roboninecom/SO-ARM102/docs/i18n/en/README.md

<!-- translation-navigation -->
[English](README.md) · [Русский](../ru/README.md) · [Español](../es/README.md) · [Français](../fr/README.md) · [Deutsch](../de/README.md) · [Português (Brasil)](../pt-BR/README.md) · [简体中文](../zh-CN/README.md) · [日本語](../ja/README.md) · [हिन्दी](../hi/README.md) · [العربية](../ar/README.md)

[English source](../../../README.md)

[Documentation](README.md) · [Printing](docs/printing.md) · [BOM](docs/bom.md) · [Assembly](docs/assembly-guide.md) · [Specifications](docs/specifications.md) · [Models](models/README.md) · [Contributing](CONTRIBUTING.md) · [Licensing](LICENSING.md) · [Translations](docs/translations.md)

> English reference. Shared illustrations and the original PDF booklet are unchanged.
<!-- /translation-navigation -->

<!-- translated-content -->

# SO-ARM 102

<div align="center">

SO-ARM 102

**🎥 [Watch the preview video](../../../assets/video/so-arm-102-preview.mp4)** · **🛒 [Buy the kit](https://robonine.com/shop/so-arm102-robotic-arm-kit/)**

**SO-ARM 102 is an open-source leader–follower robot arm kit for teleoperation and imitation learning. Each arm has five degrees of freedom plus a gripper.**

<p align="left">
Building on SO-ARM 100 and 101, it combines a stiffer PET-CF frame with a parallel gripper.
</p>






📩 [hello@robonine.com](mailto:hello@robonine.com)

**DIY budget: ~$340 for components, or ~$374 including printing material.**
[BOM summary](#bill-of-materials) · [Itemised costs and purchase links](docs/bom.md#estimated-kit-cost)

> Rather not source the parts and print them yourself? **[Buy the SO-ARM 102 kit](https://robonine.com/shop/so-arm102-robotic-arm-kit/)**.

</div>

---

## ✨ What changed against SO-ARM 101

| | SO-ARM 101 | SO-ARM 102 |
|---|---|---|
| **Parallel gripper** | Angular jaw | **Two parallel jaws, 85 mm span** |
| **Stiffer frame: deflection at 300 g ¹** | 7.5 mm | **3.4–3.9 mm (−48–55%)** |
| **Faster shoulder and elbow, no load** | 45 RPM (STS3215) | **75 RPM (STS3250), +67%** |
| **Higher rated payload** | 150 g | **300 g (+100%)** |
| **Wider base rotation** | 220° | **352° (+60%)** |
| **Reach: horizontal / behind the base** | 441 / 377 mm | **483 / 473 mm (+9.5% / +25.5%)** |
| **Lower base joint backlash** | 8.75 counts | **5.00 counts (−43%)** |
| **Quieter at 1 m** | 70 dB | **60 dB (−10 dB)** |

¹ Frame test at full extension with printed servo dummies in joints 2, 3 and 4: SO-ARM 101 in PLA, SO-ARM 102 in Fiberon PET-CF17 at 25% infill. Servo speeds are manufacturer no-load ratings at 12 V; payloads are rated values. Full results and test conditions: [docs/specifications.md](docs/specifications.md).

---

## 🎥 Preview

<div align="center">

SO-ARM 102 preview

*Click for the full video, 21 s*

</div>

---

## 🤝 Configurations

### Single-arm: one leader + one follower

The standard kit. Move the leader by hand, and the follower repeats the motion.
Use it for teleoperation and for recording demonstrations for imitation learning.

One leader and one follower

### Bimanual: two leaders + two followers

Two kits side by side. Each hand drives its own leader, so the followers can pass objects,
hold and work on a part, or do any task that needs two hands.

Two leaders and two followers

### The two arms

| Follower | Leader |
|:-:|:-:|
| Follower arm | Leader arm |
| Parallel gripper, wrist camera, 12 V | Handle with trigger, 5 V |

---

## 🚀 Build it in four steps

Prefer a ready kit? **[Buy the SO-ARM 102 kit](https://robonine.com/shop/so-arm102-robotic-arm-kit/)**.

### 1. Print the parts

Individual parts fit a 180 × 180 mm bed. The largest part is 160 mm long.
The supplied 3MF plate layouts use a 256 × 256 mm bed.

- 3MF slicer projects with saved orientation and support settings: [`models/3mf/`](../../../models/3mf)
  — [leader](../../../models/3mf/SO102_leader.3mf), [follower arms](../../../models/3mf/SO102_follower_arms.3mf),
  [Follower gripper and base](../../../models/3mf/SO102_follower_gripper_base.3mf)
- Project contents and printer profiles: [models/README.md](models/README.md)
- STL files, ready to slice: [`models/stl/`](../../../models/stl)
- STEP sources: [`models/step/`](../../../models/step)
- Material, settings and part quantities: [docs/printing.md](docs/printing.md)

### 2. Buy the hardware

Source the components from the [BOM summary](#bill-of-materials) and
[full BOM with purchase links](docs/bom.md). Budget **$340.22** for components,
or **$373.97** including printing material, before shipping and taxes.

| Arm | Servos | Controller | Power |
|---|---|---|---|
| Follower | 2 × STS3235, 2 × STS3250, 2 × STS3215 | Waveshare Bus Servo Adapter | **12 V** |
| Leader | 6 × STS3215 | Waveshare Bus Servo Adapter | **5 V** |

> ⚠️ **The leader runs on 5 V and the follower on 12 V.** Do not swap the power supplies.

### 3. Assemble

- Printable booklet, 32 pages A5: [docs/SO-ARM102_assembly_A5_v0.8.pdf](../../SO-ARM102_assembly_A5_v0.8.pdf)
- Step list with parts and fasteners: [docs/assembly-guide.md](docs/assembly-guide.md)

Tools: hex keys 1.5 mm (M2 screws) and 2 mm (M3 screws).

### 4. Set up the software

Servo IDs, calibration and lessons: **[lab.robonine.com](https://lab.robonine.com)**.
Use the SO-ARM 102 follower plugin with the standard `so101_leader` type.
**[LeRobot installation and setup](docs/lerobot.md)**.

---

## Bill of materials

Quantities and reference costs for **one leader + one follower**:

| Category / purchase links | Kit contents | Total (USD) |
|---|---|---:|
| [Servos](docs/bom.md#servos) | 6 × STS3215 7.4 V, 2 × STS3215 12 V, 2 × STS3235, 2 × STS3250 | $240.72 |
| [Electronics](docs/bom.md#electronics) | 2 controllers, 2 power supplies, 2 USB cables, 1 wrist camera | $50.50 |
| [Mechanical parts](docs/bom.md#mechanical-parts) | 4 bearings, 2 steel guide rods, 4 table clamps | $37.76 |
| [Fasteners](docs/bom.md#fasteners) | Screws and nuts; specified servo-kit screws included | $11.24 |
| **Components subtotal** | | **$340.22** |
| [Printing material](docs/bom.md#printing-materials) | 0.4 kg PET-CF17 + 0.75 kg PETG allowance | $33.75 |
| **Total with printing material** | | **$373.97** |

Buying the example full packs and filament spools from scratch costs about **$435**,
including unused spares. These are reference estimates, not new supplier quotes.
Shipping, taxes, tools, a computer, a printer, electricity and assembly labour are excluded.
Confirm supplier prices, variants and minimum order quantities before ordering;
re-slice the 3MF projects to check filament consumption.

[Full BOM, purchase links and cost assumptions](docs/bom.md#estimated-kit-cost).

---

## URDF export

The current standalone export is in [`simulation/urdf/`](../../../simulation/urdf):
[URDF](../../../simulation/urdf/so_arm_102.urdf) · [Xacro](../../../simulation/urdf/so_arm_102.xacro).
Keep `meshes/` beside the description files; mesh paths are relative to this folder.

- **Visuals:** STL meshes. **Collisions:** fitted, independently rotated boxes on all eight links.
- **Mass estimate:** PLA, 30% infill, 6 perimeters, 6 top/bottom layers,
  0.2 mm layer height, and **0.40 mm extrusion width**. These are simulation
  assumptions; use [the printing guide](docs/printing.md) for fabrication settings.
- **Hardware masses:** six motors at 70 g each; base bearing at 105 g.
  Total estimated model mass: **0.889 kg**.
- **Gripper:** `clamp2` mimics `clamp1` with multiplier `-1`.

[Export settings](../../../simulation/urdf/export_settings.json) and
[mass properties](../../../simulation/urdf/mass_properties.json) record the assumptions.
Geometry and inertia checks are recorded in [export_verification.json](../../../simulation/urdf/export_verification.json).

---

## 📁 Repository structure

```
├── models/
│   ├── 3mf/                 # Slicer projects: leader, follower, gripper and board case
│   ├── stl/                 # Print-ready meshes
│   │   ├── common/          # Shared parts, including controller cases
│   │   ├── follower/        # Parallel gripper and camera mount
│   │   └── leader/          # Handle, trigger and wrist roll
│   └── step/                # CAD sources, same layout as stl/
├── docs/
│   ├── printing.md          # Material, slicer settings, quantities
│   ├── bom.md               # Bill of materials
│   ├── assembly-guide.md    # Step list with parts and fasteners
│   ├── specifications.md    # Geometry, servos, measured results vs SO-ARM 101
│   └── SO-ARM102_assembly_A5_v0.8.pdf
├── assets/
│   ├── images/              # Photos, renders, booklet pages, test photos
│   └── video/               # Preview video and GIF
├── LICENSING.md             # Which licence covers which file
└── NOTICE                   # Third-party attribution
```

---

## ⚠️ Known issues

Build notes from independent testing; check these when assembling.

1. **Use booklet v0.8.** Earlier booklets show the HAT controller and older gripper parts. v0.8 fits a Bus Servo Adapter on both arms.
2. **M2 screws are hard to reach in several places.** Expect to fight a few of them.
3. **The gripper clamps run tight on carbon rods.** The clamp bores are sized for 6.1 mm. Rod diameters vary between suppliers, so check the fit before assembly.
4. **Check the servo cable lengths** before closing each joint, especially from the base to the shoulder.
5. **The assembly order is awkward in two places** of the booklet. Read two steps ahead before fastening.
6. **Leader joints can feel loose.** Adding 8 × 2 mm rubber O-rings between each servo and its horn gives the leader smooth, silent friction. Use two per servo on joints 1–4 and one on joints 5–6.

Found something else? Please [open an issue](https://github.com/roboninecom/SO-ARM-102/issues).

---

## ⭐ Star History

Star History — SO-ARM 102 (https://www.star-history.com/?repos=roboninecom%2FSO-ARM102&type=date&legend=top-left)

---

## 🔗 Related projects

- [SO-ARM100/101 Parallel Gripper](https://github.com/roboninecom/SO-ARM100-101-Parallel-Gripper), the gripper the SO-ARM 102 gripper grew from
- [SO-ARM101](https://github.com/TheRobotStudio/SO-ARM100) by TheRobotStudio, the arm this design succeeds
- [Practical comparison of smart serial servos](https://robonine.com/smart-serial-servo-motor-comparison-robotics/), the tests behind the servo choice
- [Choosing a filament for robotic arms](https://robonine.com/choosing-filament-for-robotic-arm-applications/), the tests behind PET-CF

---

## 📄 License

Copyright (c) 2026 Robonine. Different kinds of material carry different licences:

| Material | Licence |
|---|---|
| Hardware designs in `models/` | [CERN-OHL-P-2.0](../../../HARDWARE-LICENSE.txt) |
| Software and configuration | [Apache-2.0](../../../SOFTWARE-LICENSE.txt) |
| Documentation and images in `docs/`, `assets/`, all `README.md` | [CC BY 4.0](../../../DOCS-LICENSE.txt) |

See [LICENSING.md](LICENSING.md) and [REUSE.toml](../../../REUSE.toml) for the file-by-file map.

---

## 👥 Team

| Name | Role | Contact |
|---|---|---|
| **Alan Subin** | Design Engineer: mechanical design, CAD, assembly booklet | [LinkedIn](https://www.linkedin.com/in/alan-subin/) |
| **Boris Kotov** | Software and Test Engineer: prototypes, printing, test rigs | [Telegram](https://t.me/bkotov) |
| **Nikita Bragin** | Project Manager | [LinkedIn](https://www.linkedin.com/in/nikita-bragin-82296b29/) |
| **Mikhail Chistiakov** | Industrial Designer: look and form of the arm | [Telegram](https://t.me/brrryska) |
| **Mikhail Zhmaylo** | Structural Engineer: stiffness models, design changes to cut deflection | [Telegram](https://t.me/mikhail_zhmaylo) |
| **Vladislav Eremenko** | Structural Engineer: strength and thermal analysis, topology optimisation | [Telegram](https://t.me/v1ad_eremenko) |
| **Vladimir Osipov** | Tester and Consultant: independent test build | [LinkedIn](https://www.linkedin.com/in/vladimirosipov/) |

<div align="center">

**Built for the robotics community by [Robonine](https://robonine.com)** 🤖

</div>
<!-- /translated-content -->
