roboninecom/SO-ARM102/docs/i18n/es/README.md

<!-- translation-navigation -->
[English](../en/README.md) · [Русский](../ru/README.md) · [Español](README.md) · [Français](../fr/README.md) · [Deutsch](../de/README.md) · [Português (Brasil)](../pt-BR/README.md) · [简体中文](../zh-CN/README.md) · [日本語](../ja/README.md) · [हिन्दी](../hi/README.md) · [العربية](../ar/README.md)

[Original en inglés](../../../README.md)

[Documentación](README.md) · [Impresión](docs/printing.md) · [Materiales](docs/bom.md) · [Montaje](docs/assembly-guide.md) · [Especificaciones](docs/specifications.md) · [Modelos](models/README.md) · [Contribuir](CONTRIBUTING.md) · [Licencias](LICENSING.md) · [Traducciones](docs/translations.md)

> Traducción completa del documento. Las ilustraciones y el manual PDF original se comparten entre idiomas. Traducción realizada con ayuda de IA; aún no revisada por hablantes nativos.
<!-- /translation-navigation -->

<!-- translated-content -->

# SO-ARM 102

<div align="center">

SO-ARM 102

**🎥 [Ver el video de vista previa](../../../assets/video/so-arm-102-preview.mp4)**·**🛒 [Comprar el kit](https://robonine.com/shop/so-arm102-robotic-arm-kit/)**

**SO-ARM 102 es un kit de brazos robóticos líder–seguidor de código abierto para teleoperación y aprendizaje por imitación. Cada brazo tiene cinco grados de libertad y una pinza.**

<p align="left">
Basado en SO-ARM 100 y 101, combina una estructura de PET-CF más rígida con una pinza paralela.
</p>

   

📩 [hello@robonine.com](mailto:hello@robonine.com)

**Presupuesto de bricolaje: ~$340 para componentes, o ~$374 incluyendo material de impresión.** [Resumen del BOM](#bill-of-materials) · [Costos detallados y enlaces de compra](docs/bom.md#estimated-kit-cost)

> ¿Prefieres no obtener las piezas e imprimirlas tú mismo? **[Compra el kit SO-ARM 102](https://robonine.com/shop/so-arm102-robotic-arm-kit/)**.

</div>

---

## ✨ Lo que cambió contra SO-ARM 101

| | SO-ARM 101 | SO-ARM 102 |
|---|---|---|
| **Pinza paralela** | Mordaza angular | **Dos mordazas paralelas, apertura de 85 mm** |
| **Bastidor más rígido: deflexión con 300 g ¹** | 7.5 mm | **3.4–3.9 mm (−48–55%)** |
| **Hombro y codo más rápidos, sin carga** | 45 RPM (STS3215) | **75 RPM (STS3250), +67%** |
| **Mayor carga útil nominal** | 150 g | **300 g (+100%)** |
| **Mayor giro de la base** | 220° | **352° (+60%)** |
| **Alcance: horizontal / detrás de la base** | 441 / 377 mm | **483 / 473 mm (+9.5% / +25.5%)** |
| **Menor holgura en la articulación de la base** | 8.75 cuentas | **5.00 cuentas (−43%)** |
| **Menos ruido a 1 m** | 70 dB | **60 dB (−10 dB)** |

¹ Ensayo del bastidor completamente extendido con réplicas impresas de servos en las articulaciones 2, 3 y 4: SO-ARM 101 en PLA, SO-ARM 102 en Fiberon PET-CF17 con 25% de relleno. Las velocidades son valores del fabricante sin carga a 12 V; las cargas útiles son nominales. Resultados y condiciones: [docs/specifications.md](docs/specifications.md).

---

## 🎥 Vista previa

<div align="center">

SO-ARM 102 preview

*Haz clic para ver el vídeo completo, 21 s*

</div>

---

## 🤝 Configuraciones

### Brazo de un solo robot: un brazo robot líder + un brazo robot seguidor

El kit estándar. Mueva el brazo robot líder a mano, y el brazo robot seguidor repite el movimiento.Úselo para teleoperación y para grabar demostraciones para aprendizaje por imitación.

Un brazo líder y un brazo seguidor

### Bimanual: dos líderes + dos seguidores

Cada mano controla su propio brazo robot líder, por lo que los seguidores pueden pasar objetos, sujetar y trabajar en una pieza o hacer cualquier tarea que requiera dos manos.

Dos brazos líderes y dos brazos seguidores

### Los dos brazos robóticos

| Brazo seguidor | Brazo líder |
|:-:|:-:|
| Brazo seguidor | Brazo líder |
| Pinza paralela, cámara de muñeca, 12 V | Mango con gatillo, 5 V |

---

## 🚀 Construye en cuatro pasos

¿Prefieres un kit listo? **[Compra el SO-ARM 102 kit](https://robonine.com/shop/so-arm102-robotic-arm-kit/)**.

### 1. Imprimir las piezas

Las piezas individuales se ajustan a una placa de construcción de impresora 3D 180 × 180 mm. La parte más grande tiene 160 mm largo. Los diseños de placa 3MF suministrados utilizan una placa de construcción de impresora 3D 256 × 256 mm.

- 3MF proyectos slicer con configuraciones de orientación y soporte guardadas: [`models/3mf/`](../../../models/3mf) — [brazo robot líder](../../../models/3mf/SO102_leader.3mf), [brazo robot seguidor](../../../models/3mf/SO102_follower_arms.3mf), [Pinza y base del seguidor](../../../models/3mf/SO102_follower_gripper_base.3mf)
- Contenido del proyecto y perfiles de impresora: [models/README.md](models/README.md)
- STL archivos, listos para cortar: [`models/stl/`](../../../models/stl)
- STEP sources: [`models/step/`](../../../models/step)
- Material, ajustes y cantidades de piezas: [docs/printing.md](docs/printing.md)

### 2. Comprar el hardware

Obtenga los componentes del [resumen de la lista de materiales](#bill-of-materials) y [lista completa con enlaces de compra](docs/bom.md). Presupuesto **$340.22**para componentes, o**$373.97** incluyendo material de impresión, antes del envío e impuestos.

| Brazo | Servos | Controlador | Alimentación |
|---|---|---|---|
| Brazo seguidor | 2 × STS3235, 2 × STS3250, 2 × STS3215 | Waveshare Bus Servo Adapter | **12 V** |
| Brazo líder | 6 × STS3215 | Waveshare Bus Servo Adapter | **5 V** |

> ⚠️ **El brazo líder funciona a 5 V y el brazo seguidor a 12 V.** No intercambie las fuentes de alimentación.

### 3. Ensamblar

- Folleto imprimible, 32 páginas A5: [docs/SO-ARM102_assembly_A5_v0.8.pdf](../../SO-ARM102_assembly_A5_v0.8.pdf)
- Lista de pasos con piezas y sujetadores: [docs/assembly-guide.md](docs/assembly-guide.md)

Herramientas: llaves hexagonales 1.5 mm (M2 tornillos) y 2 mm (M3 tornillos).

### 4. Configurar el software

Servo IDs, calibración y lecciones: **[lab.robonine.com](https://lab.robonine.com)**.
Utilice el plugin del seguidor SO-ARM 102 con el tipo estándar `so101_leader`.
**[Instalación y configuración de LeRobot](docs/lerobot.md)**.

---

## Lista de materiales

Cantidades y costos de referencia para **un brazo robot líder + un brazo robot seguidor**:

| Categoría / enlaces de compra | Contenido del kit | Total (USD) |
|---|---|---:|
| [Servos](docs/bom.md#servos) | 6 × STS3215 7.4 V, 2 × STS3215 12 V, 2 × STS3235, 2 × STS3250 | $240.72 |
| [Electrónica](docs/bom.md#electronics) | 2 controladores, 2 fuentes de alimentación, 2 cables USB, 1 cámara de muñeca | $50.50 |
| [Piezas mecánicas](docs/bom.md#mechanical-parts) | 4 rodamientos, 2 barras guía de acero, 4 abrazaderas de mesa | $37.76 |
| [Elementos de fijación](docs/bom.md#fasteners) | Tornillos y tuercas; tornillos especificados del juego del servomotor incluidos | $11.24 |
| **Subtotal de componentes** |  | **$340.22** |
| [Material de impresión](docs/bom.md#printing-materials) | 0.4 kg PET-CF17 + 0.75 kg PETG asignación | $33.75 |
| **Total con material de impresión** |  | **$373.97** |

Comprar el ejemplo de paquetes completos y carretes de filamentos desde cero cuesta alrededor de **$435**, incluyendo repuestos no utilizados. Estas son estimaciones de referencia, no nuevas cotizaciones de proveedores. El envío, los impuestos, las herramientas, una computadora, una impresora, la electricidad y el trabajo de montaje están excluidos. Confirme los precios del proveedor, las variantes y las cantidades mínimas de pedido antes de realizar el pedido; corte nuevamente con el cortador de impresión 3D los 3MF proyectos para verificar el consumo de filamento.

[BOM completo, enlaces de compra y supuestos de costo](docs/bom.md#estimated-kit-cost).

---

## URDF exportación

La exportación independiente actual está en [`simulation/urdf/`](../../../simulation/urdf): [URDF](../../../simulation/urdf/so_arm_102.urdf) · [Xacro](../../../simulation/urdf/so_arm_102.xacro). Mantenga `meshes/` junto a los archivos de descripción; las rutas de malla son relativas a esta carpeta.

- **Visuales:**STL mallas.**Colisiones:** cajas rotativas independientes en los ocho enlaces.
- **Estimación de masa:**PLA, 30% de relleno, 6 perímetros, 6 capas superior/inferior, 0.2 mm altura de capa y**0.40 mm ancho de extrusión** Estos son supuestos de simulación; utilice [la guía de impresión](docs/printing.md) para los ajustes de fabricación.
- **Masas de hardware:**seis motores a 70 g cada uno; cojinete base a 105 g. Masa total estimada del modelo:**0.889 kg**.
- **Gripper:** `clamp2` imita `clamp1` con multiplicador `-1`.

[Configuración de exportación](../../../simulation/urdf/export_settings.json) y [Propiedades de masa](../../../simulation/urdf/mass_properties.json) registran los supuestos.La geometría y las comprobaciones de inercia se registran en [export_verification.json](../../../simulation/urdf/export_verification.json).

---

## 📁 Estructura del repositorio

```
├── models/
│   ├── 3mf/                 # Proyectos de la rebanadora: brazo robot líder, brazo robot seguidor, pinza y caja del tablero
│   ├── stl/                 # Mallas listas para imprimir
│   │   ├── common/          # Piezas comunes, incluidas las cajas de los controladores
│   │   ├── follower/        # Pinza paralela y soporte de cámara
│   │   └── leader/          # Mango, gatillo y giro de muñeca
│   └── step/                # CAD fuentes, mismo diseño que stl/
├── docs/
│   ├── printing.md          # Material, ajustes de la rebanadora, cantidades
│   ├── bom.md               # Lista de materiales
│   ├── assembly-guide.md    # Lista de pasos con piezas y sujetadores
│   ├── specifications.md    # Geometría, servomotores, resultados medidos vs SO-ARM 101
│   └── SO-ARM102_assembly_A5_v0.8.pdf
├── assets/
│   ├── images/              # Fotos, renders, páginas de folletos, fotos de prueba
│   └── video/               # Vista previa de vídeo y GIF
├── LICENSING.md             # Qué licencia cubre qué archivo
└── NOTICE                   # Atribución a terceros
```

---

## Problemas conocidos

Notas de montaje de pruebas independientes; revíselas al montar.

1. **Use el folleto v0.8.** Los anteriores muestran el controlador HAT y piezas antiguas de la pinza. La v0.8 instala un Bus Servo Adapter en ambos brazos.
2. **M2 tornillos son difíciles de alcanzar en varios lugares.** Espere luchar contra algunos de ellos.
3. **Las abrazaderas de la pinza funcionan bien en varillas de carbono.** Los orificios de las abrazaderas tienen un tamaño para 6.1 mm.Los diámetros de las varillas varían entre los proveedores, así que compruebe el ajuste antes del montaje.
4. **Compruebe las longitudes de cable del servomotor** antes de cerrar cada junta, especialmente desde la base hasta el hombro.
5. **El orden de montaje es incómodo en dos lugares** del folleto.Lea dos pasos antes de fijar.
6. **Las juntas de los brazos del robot líder pueden sentirse sueltas.** Al agregar 8 × 2 mm juntas tóricas de goma entre cada servomotor y su bocina, el brazo del robot líder obtiene una fricción suave y silenciosa. Utilice dos por servomotor en las juntas 1–4 y una en las juntas 5–6.

Por favor, [abre un problema](https://github.com/roboninecom/SO-ARM-102/issues).

---

## ⭐ Historial de estrellas

Historial de estrellas — SO-ARM 102 (https://www.star-history.com/?repos=roboninecom%2FSO-ARM102&type=date&legend=top-left)

---

## Proyectos relacionados

- [SO-ARM100/101 Pinza paralela](https://github.com/roboninecom/SO-ARM100-101-Parallel-Gripper), la pinza de la que creció la SO-ARM 102 pinza
- [SO-ARM101](https://github.com/TheRobotStudio/SO-ARM100) por TheRobotStudio, el brazo robótico este diseño tiene éxito
- [Comparación práctica de servomotores inteligentes en serie](https://robonine.com/smart-serial-servo-motor-comparison-robotics/), las pruebas detrás de la elección del servomotor
- [Elegir un filamento para brazos robóticos](https://robonine.com/choosing-filament-for-robotic-arm-applications/), las pruebas detrás de PET-CF

---

## 📄 Licencia de uso

Copyright (c) 2026 Robonine. Diferentes tipos de material llevan diferentes licencias:

| Material | Licencia |
|---|---|
| Diseños de hardware en `models/` | [CERN-OHL-P-2.0](../../../HARDWARE-LICENSE.txt) |
| Software y configuración | [Apache-2.0](../../../SOFTWARE-LICENSE.txt) |
| Documentación e imágenes en `docs/`, `assets/`, todos `README.md` | [CC BY 4.0](../../../DOCS-LICENSE.txt) |

Vea [LICENSING.md](LICENSING.md) y [REUSE.toml](../../../REUSE.toml) para el mapa archivo por archivo.

---

## 👥 Team

| Nombre | Función | Contacto |
|---|---|---|
| **Alan Subin** | Ingeniero de diseño: diseño mecánico, CAD, folleto de montaje | [LinkedIn](https://www.linkedin.com/in/alan-subin/) |
| **Boris Kotov** | Ingeniero de software y pruebas: prototipos, impresión, bancos de prueba | [Telegram](https://t.me/bkotov) |
| **Nikita Bragin** | Gerente de proyecto | [LinkedIn](https://www.linkedin.com/in/nikita-bragin-82296b29/) |
| **Mikhail Chistiakov** | Diseñador industrial: aspecto y forma del brazo robot | [Telegram](https://t.me/brrryska) |
| **Mikhail Zhmaylo** | Ingeniero estructural: modelos de rigidez, cambios de diseño para reducir la desviación | [Telegram](https://t.me/mikhail_zhmaylo) |
| **Vladislav Eremenko** | Ingeniero estructural: análisis de resistencia y térmico, optimización topológica | [Telegram](https://t.me/v1ad_eremenko) |
| **Vladimir Osipov** | Tester y Consultor: construcción independiente de pruebas | [LinkedIn](https://www.linkedin.com/in/vladimirosipov/) |

<div align="center">

** Construido para la comunidad de robótica por [Robonine](https://robonine.com)** 🤖

</div>
<!-- /translated-content -->
