roboninecom/SO-ARM102/docs/i18n/ru/README.md

<!-- translation-navigation -->
[English](../en/README.md) · [Русский](README.md) · [Español](../es/README.md) · [Français](../fr/README.md) · [Deutsch](../de/README.md) · [Português (Brasil)](../pt-BR/README.md) · [简体中文](../zh-CN/README.md) · [日本語](../ja/README.md) · [हिन्दी](../hi/README.md) · [العربية](../ar/README.md)

[Английский оригинал](../../../README.md)

[Документация](README.md) · [Печать](docs/printing.md) · [Комплектующие](docs/bom.md) · [Сборка](docs/assembly-guide.md) · [Характеристики](docs/specifications.md) · [Модели](models/README.md) · [Участие](CONTRIBUTING.md) · [Лицензирование](LICENSING.md) · [Переводы](docs/translations.md)

> Полный перевод документа. Изображения и исходный PDF-буклет общие для всех языков. Перевод подготовлен с помощью ИИ; проверка носителями языка ещё не проведена.
<!-- /translation-navigation -->

<!-- translated-content -->

# SO-ARM 102

<div align="center">

SO-ARM 102

**🎥 [Посмотреть видео](../../../assets/video/so-arm-102-preview.mp4)**·**🛒 [Купить комплект](https://robonine.com/shop/so-arm102-robotic-arm-kit/)**

**SO-ARM 102 — открытый комплект ведущей и ведомой роботизированных рук для телеуправления и обучения по демонстрациям. Каждая рука имеет пять степеней свободы и захват.**

<p align="left">
Развивая конструкцию SO-ARM 100 и 101, он сочетает более жёсткую раму из PET-CF с параллельным захватом.
</p>

   

📩 [hello@robonine.com](mailto:hello@robonine.com)

**Бюджет самостоятельной сборки: ~$340 на комплектующие или ~$374 с материалом для печати.** [Сводная спецификация](#bill-of-materials) · [Подробные цены и ссылки закупки](docs/bom.md#estimated-kit-cost)

> Предпочитаете не закупать и не печатать детали самостоятельно? **[Купите комплект SO-ARM 102](https://robonine.com/shop/so-arm102-robotic-arm-kit/)**.

</div>

---

## ✨ Изменения относительно SO-ARM 101

| | SO-ARM 101 | SO-ARM 102 |
|---|---|---|
| **Параллельный захват** | Угловой захват | **Две параллельные губки, раскрытие 85 mm** |
| **Более жёсткая рама: прогиб при 300 g ¹** | 7.5 mm | **3.4–3.9 mm (−48–55%)** |
| **Более быстрые плечо и локоть, без нагрузки** | 45 RPM (STS3215) | **75 RPM (STS3250), +67%** |
| **Большая номинальная грузоподъёмность** | 150 g | **300 g (+100%)** |
| **Больший поворот основания** | 220° | **352° (+60%)** |
| **Вылет: горизонтальный / за основание** | 441 / 377 mm | **483 / 473 mm (+9.5% / +25.5%)** |
| **Меньший люфт основания** | 8.75 отсчётов | **5.00 отсчётов (−43%)** |
| **Меньше шума на расстоянии 1 m** | 70 dB | **60 dB (−10 dB)** |

¹ Испытание рамы при полном вылете с печатными макетами сервоприводов в суставах 2, 3 и 4: SO-ARM 101 из PLA, SO-ARM 102 из Fiberon PET-CF17 с заполнением 25%. Скорости сервоприводов указаны производителем без нагрузки при 12 V; грузоподъёмность номинальная. Результаты и условия испытаний: [docs/specifications.md](docs/specifications.md).

---

## 🎥 Видео

<div align="center">

Видео SO-ARM 102

*Нажмите, чтобы посмотреть полное видео, 21 s*

</div>

---

## 🤝 Конфигурации

### Одна рабочая рука: одна ведущая и одна ведомая

Стандартный комплект. Перемещайте ведущую руку вручную, а ведомая будет повторять движение. Используйте комплект для телеуправления и записи демонстраций для обучения.

Одна ведущая и одна ведомая рука

### Двуручная конфигурация: две ведущие и две ведомые руки

Два комплекта рядом. Каждая рука оператора перемещает свою ведущую руку, а ведомые могут передавать предметы, удерживать и обрабатывать деталь или выполнять другие задачи, требующие двух рук.

Две ведущие и две ведомые руки

### Две руки комплекта

| Ведомая рука | Ведущая рука |
|:-:|:-:|
| Ведомая рука | Ведущая рука |
| Параллельный захват, камера на запястье, 12 V | Рукоятка с курком, 5 V |

---

## 🚀 Сборка за четыре этапа

Предпочитаете готовый комплект? **[Купите SO-ARM 102](https://robonine.com/shop/so-arm102-robotic-arm-kit/)**.

### 1. Напечатайте детали

Отдельные детали помещаются на столе 180 × 180 mm. Длина самой большой детали — 160 mm. Готовые раскладки 3MF рассчитаны на стол 256 × 256 mm.

- Проекты слайсера 3MF с сохранёнными ориентацией и поддержками: [`models/3mf/`](../../../models/3mf) — [ведущая рука](../../../models/3mf/SO102_leader.3mf), [ведомая рука](../../../models/3mf/SO102_follower_arms.3mf), [Захват и основание ведомой руки](../../../models/3mf/SO102_follower_gripper_base.3mf)
- Содержимое проектов и профили принтера: [models/README.md](models/README.md)
- Файлы STL, готовые к подготовке печати: [`models/stl/`](../../../models/stl)
- Исходные модели STEP: [`models/step/`](../../../models/step)
- Материалы, параметры и количество деталей: [docs/printing.md](docs/printing.md)

### 2. Закупите комплектующие

Используйте [сводную спецификацию](#bill-of-materials) и [полный BOM со ссылками закупки](docs/bom.md). Бюджет комплектующих — **$340.22**, с материалом для печати — **$373.97**, без доставки и налогов.

| Рука | Сервоприводы | Контроллер | Питание |
|---|---|---|---|
| Ведомая рука | 2 × STS3235, 2 × STS3250, 2 × STS3215 | Waveshare Bus Servo Adapter | **12 V** |
| Ведущая рука | 6 × STS3215 | Waveshare Bus Servo Adapter | **5 V** |

> ⚠️ **Питание ведущей руки — 5 V, ведомой — 12 V.** Не меняйте блоки питания местами.

### 3. Соберите комплект

- Буклет для печати, 32 страницы A5: [docs/SO-ARM102_assembly_A5_v0.8.pdf](../../SO-ARM102_assembly_A5_v0.8.pdf)
- Этапы сборки с деталями и крепежом: [docs/assembly-guide.md](docs/assembly-guide.md)

Инструменты: шестигранники 1.5 mm для винтов M2 и 2 mm для винтов M3.

### 4. Настройте ПО

Назначение ID сервоприводов, калибровка и уроки: **[lab.robonine.com](https://lab.robonine.com)**.
Используйте плагин ведомой руки SO-ARM 102 со стандартным типом `so101_leader`.
**[Установка и настройка LeRobot](docs/lerobot.md)**.

---

## Спецификация комплектующих

Количество и справочная стоимость для **одной ведущей и одной ведомой руки**:

| Категория / ссылки закупки | Состав комплекта | Итого (USD) |
|---|---|---:|
| [Сервоприводы](docs/bom.md#servos) | 6 × STS3215 7.4 V, 2 × STS3215 12 V, 2 × STS3235, 2 × STS3250 | $240.72 |
| [Электроника](docs/bom.md#electronics) | Контроллеры — 2, блоки питания — 2, USB-кабели — 2, камера на запястье — 1 | $50.50 |
| [Механические детали](docs/bom.md#mechanical-parts) | Подшипники — 4, стальные направляющие — 2, струбцины — 4 | $37.76 |
| [Крепёж](docs/bom.md#fasteners) | Винты и гайки; указанные винты из комплекта сервоприводов включены | $11.24 |
| **Итого комплектующие** |  | **$340.22** |
| [Материал для печати](docs/bom.md#printing-materials) | Расчётный расход: 0.4 kg PET-CF17 + 0.75 kg PETG | $33.75 |
| **Итого с материалом для печати** |  | **$373.97** |

Закупка указанных полных упаковок и катушек с нуля обойдётся примерно в **$435**, включая неиспользованные остатки. Это справочные оценки, а не новые предложения поставщиков. Доставка, налоги, инструменты, компьютер, принтер, электричество и работа по сборке не включены. Перед заказом проверьте цены, варианты и минимальные партии; заново нарежьте проекты 3MF для оценки расхода пластика.

[Полный BOM, ссылки закупки и допущения расчёта стоимости](docs/bom.md#estimated-kit-cost).

---

## Экспорт URDF

Текущий автономный экспорт находится в [`simulation/urdf/`](../../../simulation/urdf): [URDF](../../../simulation/urdf/so_arm_102.urdf) · [Xacro](../../../simulation/urdf/so_arm_102.xacro). Сохраняйте папку `meshes/` рядом с описаниями: пути к сеткам заданы относительно неё.

- **Визуализация:**сетки STL.**Коллизии:** подобранные и независимо повёрнутые параллелепипеды на всех восьми звеньях.
- **Оценка массы:**PLA, заполнение 30%, 6 периметров, 6 верхних/нижних слоёв, высота слоя 0.2 mm и**ширина экструзии 0.40 mm**. Это допущения симуляции; параметры изготовления приведены в [руководстве по печати](docs/printing.md).
- **Масса оборудования:**шесть моторов по 70 g, подшипник основания — 105 g. Общая расчётная масса модели —**0.889 kg**.
- **Захват:** `clamp2` повторяет движение `clamp1` с множителем `-1`.

Допущения записаны в [настройках экспорта](../../../simulation/urdf/export_settings.json) и [массовых характеристиках](../../../simulation/urdf/mass_properties.json). Проверки геометрии и инерции приведены в [export_verification.json](../../../simulation/urdf/export_verification.json).

---

## 📁 Структура репозитория

```
├── models/
│   ├── 3mf/                 # Проекты слайсера: ведущая и ведомая руки, захват и корпус платы
│   ├── stl/                 # Сетки для печати
│   │   ├── common/          # Общие детали, включая корпуса контроллеров
│   │   ├── follower/        # Параллельный захват и крепление камеры
│   │   └── leader/          # Рукоятка, курок и узел вращения запястья
│   └── step/                # Исходники CAD, структура как в stl/
├── docs/
│   ├── printing.md          # Материалы, настройки слайсера, количество
│   ├── bom.md               # Спецификация комплектующих
│   ├── assembly-guide.md    # Этапы сборки с деталями и крепежом
│   ├── specifications.md    # Геометрия, сервоприводы, измерения в сравнении с SO-ARM 101
│   └── SO-ARM102_assembly_A5_v0.8.pdf
├── assets/
│   ├── images/              # Фото, рендеры, страницы буклета, фото испытаний
│   └── video/               # Видео и GIF
├── LICENSING.md             # Какая лицензия покрывает какой файл
└── NOTICE                   # Сведения об авторах сторонних материалов
```

---

## ⚠️ Известные проблемы

Замечания по результатам независимой тестовой сборки; учитывайте их при сборке.

1. **Используйте буклет v0.8.** В предыдущих версиях показаны контроллер HAT и старые детали захвата. В v0.8 на обеих руках установлен Bus Servo Adapter.
2. **В нескольких местах трудно добраться до винтов M2.** Установка части винтов потребует усилий.
3. **Губки захвата туго ходят по карбоновым направляющим.** Диаметр отверстий — 6.1 mm. Диаметры направляющих зависят от поставщика: проверьте посадку до сборки.
4. **Проверьте длину кабелей сервоприводов**, прежде чем закрывать сустав, особенно между основанием и плечом.
5. **В двух местах буклета порядок сборки неудобен.** Перед затяжкой читайте на два шага вперёд.
6. **Суставы ведущей руки могут казаться слишком свободными.** Резиновые кольца 8 × 2 mm между сервоприводом и качалкой создают плавное бесшумное трение. Используйте по два кольца на суставах 1–4 и по одному на суставах 5–6.

Нашли другую проблему? [Создайте issue](https://github.com/roboninecom/SO-ARM-102/issues).

---

## ⭐ История звёзд

История звёзд — SO-ARM 102 (https://www.star-history.com/?repos=roboninecom%2FSO-ARM102&type=date&legend=top-left)

---

## 🔗 Связанные проекты

- [SO-ARM100/101 Parallel Gripper](https://github.com/roboninecom/SO-ARM100-101-Parallel-Gripper) — захват, на основе которого создан захват SO-ARM 102
- [SO-ARM101](https://github.com/TheRobotStudio/SO-ARM100) от TheRobotStudio — предшественник этой руки
- [Практическое сравнение интеллектуальных сервоприводов](https://robonine.com/smart-serial-servo-motor-comparison-robotics/) — испытания, на которых основан выбор моторов
- [Выбор пластика для роботизированных рук](https://robonine.com/choosing-filament-for-robotic-arm-applications/) — испытания PET-CF

---

## 📄 Лицензия

Авторские права (c) 2026 Robonine. Разные материалы распространяются по разным лицензиям:

| Материал | Лицензия |
|---|---|
| Аппаратные модели в `models/` | [CERN-OHL-P-2.0](../../../HARDWARE-LICENSE.txt) |
| ПО и конфигурация | [Apache-2.0](../../../SOFTWARE-LICENSE.txt) |
| Документация и изображения в `docs/`, `assets/`, все `README.md` | [CC BY 4.0](../../../DOCS-LICENSE.txt) |

Распределение лицензий по файлам см. в [LICENSING.md](LICENSING.md) и [REUSE.toml](../../../REUSE.toml).

---

## 👥 Команда

| Название | Роль | Контакт |
|---|---|---|
| **Alan Subin** | Инженер-конструктор: механическая конструкция, CAD, буклет сборки | [LinkedIn](https://www.linkedin.com/in/alan-subin/) |
| **Boris Kotov** | Инженер по ПО и испытаниям: прототипы, печать, испытательные стенды | [Telegram](https://t.me/bkotov) |
| **Nikita Bragin** | Руководитель проекта | [LinkedIn](https://www.linkedin.com/in/nikita-bragin-82296b29/) |
| **Mikhail Chistiakov** | Промышленный дизайнер: внешний вид и форма руки | [Telegram](https://t.me/brrryska) |
| **Mikhail Zhmaylo** | Инженер по расчётам: модели жёсткости, изменения конструкции для уменьшения прогиба | [Telegram](https://t.me/mikhail_zhmaylo) |
| **Vladislav Eremenko** | Инженер по расчётам: прочность, тепловой анализ, топологическая оптимизация | [Telegram](https://t.me/v1ad_eremenko) |
| **Vladimir Osipov** | Испытатель и консультант: независимая тестовая сборка | [LinkedIn](https://www.linkedin.com/in/vladimirosipov/) |

<div align="center">

**Создано [Robonine](https://robonine.com) для сообщества робототехники** 🤖

</div>
<!-- /translated-content -->
