roboninecom/SO-ARM102/docs/i18n/ar/docs/specifications.md

<div dir="rtl" lang="ar">

<!-- translation-navigation -->
[English](../../en/docs/specifications.md) · [Русский](../../ru/docs/specifications.md) · [Español](../../es/docs/specifications.md) · [Français](../../fr/docs/specifications.md) · [Deutsch](../../de/docs/specifications.md) · [Português (Brasil)](../../pt-BR/docs/specifications.md) · [简体中文](../../zh-CN/docs/specifications.md) · [日本語](../../ja/docs/specifications.md) · [हिन्दी](../../hi/docs/specifications.md) · [العربية](specifications.md)

[الأصل الإنجليزي](../../../specifications.md)

[الوثائق](../README.md) · [الطباعة](printing.md) · [قائمة المواد](bom.md) · [التجميع](assembly-guide.md) · [المواصفات](specifications.md) · [النماذج](../models/README.md) · [المساهمة](../CONTRIBUTING.md) · [التراخيص](../LICENSING.md) · [الترجمات](translations.md)

> هذه ترجمة كاملة للوثيقة. الرسوم وكتيب PDF الأصلي مشتركة بين اللغات. أعدت الترجمة بمساعدة الذكاء الاصطناعي ولم يراجعها متحدثون أصليون بعد.
<!-- /translation-navigation -->

<!-- translated-content -->

# المواصفات ونتائج الاختبارات

تم القياس على Robonine نماذج أولية في آب/أغسطس وأيلول/سبتمبر 2026. والأرقام التي تحمل علامة *محسوبة* مستمدة من صحائف بيانات النموذج URDF والمحرك المساعد، لا من قياس.

## الأبعاد الهندسية

| المفصل | النطاق |
|---|---|
| دوران القاعدة | −176° … +176° (352°) |
| رفع الكتف | −43° … +181° (224°) |
| ثني المرفق | −166° … +77° (243°) |
| ثني المعصم | −85° … +111° (196°) |
| دوران المعصم | −165° … +163° (328°) |
| القابض | 0 … 85 mm |

| الوصلة | بين المحورين |
|---|---|
| الدوران الأساسي إلى الكتف | 85 mm |
| الكتف إلى المرفق | 119 mm |
| مرفق إلى معصم المرونة | 139 mm |
| مرونة المعصم إلى لف المعصم | 62 mm |
| دوار المعصم إلى نهاية الملقط | 132 mm |

| مدى الوصول، مركز رأس الممسحة |  |
|---|---|
| نصف القطر الأفقي | 483 mm |
| الطول فوق القاعدة | حتى 544 mm |
| تحت قاعدة القاعدة، ذراع الروبوت فوق حافة الطاولة | انخفض إلى −301 mm |

حُسبت نسبة التغطية من 100,000 وضع عشوائي داخل حدود المفصل، بدون اصطدامات ذاتية.

## محركات السيرفو

| المفصل | الذراع التابع | الذراع القائد |
|---|---|---|
| 1 التناوب الأساسي | STS3235 | STS3215 |
| 2 رفع الكتف | STS3250 | STS3215 |
| 3 مرفق مرن | STS3250 | STS3215 |
| 4 مرونة المعصم | STS3235 | STS3215 |
| 5 لف المعصم | ST-3215-C049, 1:191 | STS3215 |
| 6 المضخة/الزناد | ST-3215-C049, 1:191 | STS3215 |
| التغذية | 12 V | 5 V |

## القابض

| | |
|---|---|
| النوع | موازية، سلسلة ومحور، فكين متحركان |
| عرض الفتح | 85 mm |
| صندوق، العرض الأقصى الموصى به | حوالي 75 mm |
| الأسطوانة، القطر الأقصى الموصى به | حوالي 70 mm |
| الكرة، القطر الأقصى الموصى به | حوالي 60 mm |
| الكاميرا | كاميرا USB مركبة على المقبض |

## النتائج المقيسة مقابل SO-ARM 101

| المقياس | SO-ARM 101 | SO-ARM 102 | التغير |
|---|---|---|---|
| الانحراف عند رأس المقبض، 300 g، ذراع الروبوت ممدداً بالكامل(1) | 7.5 mm | 3.4 mm | −55 % |
| نفس الشيء، جميع الروابط عند 100 في المائة من الملء | — | 2.34 mm | −69 % |
| نصف القطر الأفقي | 441 mm | 483 mm | +9.5 % |
| المدى خلف القاعدة | 377 mm | 473 mm | +25.5 % |
| نطاق دوران القاعدة | 220° | 352° | +60 % |
| نطاق المرفق | 194° | 243° | +25 % |
| سرعة الكتف والمرفق بدون حمولة، *محسوبة* | 270 °/s | 450 °/s | +67 % |
| خلوص مفصل القاعدة | 8.75 عدد | 5.00 عدد | −43 % |
| خطأ الطرف الأفقي من حركة القاعدة العكسية، *محسوب* | ±2.96 mm | ±1.85 mm | −37.5 % |
| قابلية التكرار | — | حوالي 0.1 mm |  |
| الضجيج عند 1 م | 70 dB | 60 dB | −10 dB |
| الحمولة الاسمية | 150 g | 300 g |  |

¹ صُنعت الذراعان مع نماذج سيرفو مطبوعة في المفاصل 2 و3 و4، لذا تُقارَن البنية فقط. طُبع SO-ARM 101 بمادة PLA، وSO-ARM 102 بمادة Fiberon PET-CF17، بنسبة ملء 25 %. أعطت إعادة اختبار SO-ARM 102 نفسه النتيجة 3.9 mm.

| SO-ARM 101 | SO-ARM 102 |
|:-:|:-:|
| SO-ARM 101 اختبار الصلابة | SO-ARM 102 اختبار الصلابة |

## تيار ودرجة حرارة، ذراع روبوتية متابعة

مقيسة بحمل 300 g على مسار متكرر، محيط 30 °C، ست محركات خدمة STS3250.

| | |
|---|---|
| التيار المتوسط | 1.26 A |
| تيار الذروة | 3.28 A |
| أقصى درجة حرارة للسيرفو | 46 °C |

## الدقة المطلقة

لا يزال الضبط جاريًا. مع إعدادات PID الأصلية للسيرفو، هبط الطرف نحو 50 mm تحت وزن الذراع نفسها عند مدّها بالكامل. خفّض ضبط PID هذا الهبوط إلى نحو 5 mm. يجري إعداد ملف مخصص لتقييم الدقة.
<!-- /translated-content -->

</div>
