roboninecom/SO-ARM102/docs/i18n/ru/docs/specifications.md

<!-- translation-navigation -->
[English](../../en/docs/specifications.md) · [Русский](specifications.md) · [Español](../../es/docs/specifications.md) · [Français](../../fr/docs/specifications.md) · [Deutsch](../../de/docs/specifications.md) · [Português (Brasil)](../../pt-BR/docs/specifications.md) · [简体中文](../../zh-CN/docs/specifications.md) · [日本語](../../ja/docs/specifications.md) · [हिन्दी](../../hi/docs/specifications.md) · [العربية](../../ar/docs/specifications.md)

[Английский оригинал](../../../specifications.md)

[Документация](../README.md) · [Печать](printing.md) · [Комплектующие](bom.md) · [Сборка](assembly-guide.md) · [Характеристики](specifications.md) · [Модели](../models/README.md) · [Участие](../CONTRIBUTING.md) · [Лицензирование](../LICENSING.md) · [Переводы](translations.md)

> Полный перевод документа. Изображения и исходный PDF-буклет общие для всех языков. Перевод подготовлен с помощью ИИ; проверка носителями языка ещё не проведена.
<!-- /translation-navigation -->

<!-- translated-content -->

# Характеристики и результаты испытаний

Измерения выполнены на прототипах Robonine в августе и сентябре 2026. Значения с пометкой *расчётное* получены из модели URDF и документации сервоприводов, а не измерены.

## Геометрия

| Сустав | Диапазон |
|---|---|
| Поворот основания | −176° … +176° (352°) |
| Подъём плеча | −43° … +181° (224°) |
| Сгибание локтя | −166° … +77° (243°) |
| Сгибание запястья | −85° … +111° (196°) |
| Вращение запястья | −165° … +163° (328°) |
| Захват | 0 … 85 mm |

| Звено | Между осями |
|---|---|
| От поворота основания до плеча | 85 mm |
| От плеча до локтя | 119 mm |
| От локтя до сгибания запястья | 139 mm |
| От сгибания до вращения запястья | 62 mm |
| От вращения запястья до кончика захвата | 132 mm |

| Вылет по центру кончика захвата |  |
|---|---|
| Горизонтальный радиус | 483 mm |
| Высота над нижней плоскостью основания | до 544 mm |
| Ниже основания, при установке руки над краем стола | до −301 mm |

Вылет рассчитан по 100,000 случайных поз в пределах суставов без самоколлизий.

## Сервоприводы

| Сустав | Ведомая рука | Ведущая рука |
|---|---|---|
| 1 Поворот основания | STS3235 | STS3215 |
| 2 Подъём плеча | STS3250 | STS3215 |
| 3 Сгибание локтя | STS3250 | STS3215 |
| 4 Сгибание запястья | STS3235 | STS3215 |
| 5 Вращение запястья | ST-3215-C049, 1:191 | STS3215 |
| 6 Захват / курок | ST-3215-C049, 1:191 | STS3215 |
| Питание | 12 V | 5 V |

## Захват

| | |
|---|---|
| Тип | Параллельный, реечный, с двумя подвижными губками |
| Раскрытие | 85 mm |
| Коробка: рекомендуемая максимальная ширина | около 75 mm |
| Цилиндр: рекомендуемый максимальный диаметр | около 70 mm |
| Шар: рекомендуемый максимальный диаметр | около 60 mm |
| Камера | USB-камера на захвате |

## Измеренные результаты в сравнении с SO-ARM 101

| Показатель | SO-ARM 101 | SO-ARM 102 | Изменение |
|---|---|---|---|
| Прогиб у кончика захвата, нагрузка 300 g, рука полностью вытянута ¹ | 7.5 mm | 3.4 mm | −55 % |
| То же, заполнение всех звеньев 100 % ¹ | — | 2.34 mm | −69 % |
| Горизонтальный радиус | 441 mm | 483 mm | +9.5 % |
| Вылет за основание | 377 mm | 473 mm | +25.5 % |
| Диапазон поворота основания | 220° | 352° | +60 % |
| Диапазон локтя | 194° | 243° | +25 % |
| Скорость плеча и локтя без нагрузки, *расчётная* | 270 °/s | 450 °/s | +67 % |
| Люфт сустава основания | 8.75 отсчётов | 5.00 отсчётов | −43 % |
| Горизонтальная ошибка кончика из-за люфта основания, *расчётная* | ±2.96 mm | ±1.85 mm | −37.5 % |
| Повторяемость | — | около 0.1 mm |  |
| Шум на расстоянии 1 м | 70 dB | 60 dB | −10 dB |
| Номинальная нагрузка | 150 g | 300 g |  |

¹ В суставах 2, 3 и 4 обеих рук установлены напечатанные макеты сервоприводов: сравниваются только рамы. SO-ARM 101 напечатана из PLA, SO-ARM 102 — из Fiberon PET-CF17 с заполнением 25 %. Повторное испытание SO-ARM 102 дало 3.9 mm.

| SO-ARM 101 | SO-ARM 102 |
|:-:|:-:|
| Испытание жёсткости SO-ARM 101 | Испытание жёсткости SO-ARM 102 |

## Ток и температура ведомой руки

Измерено при нагрузке 300 g на повторяющейся траектории, температуре окружающей среды 30 °C, с шестью сервоприводами STS3250.

| | |
|---|---|
| Средний ток | 1.26 A |
| Пиковый ток | 3.28 A |
| Максимальная температура сервопривода | 46 °C |

## Абсолютная точность

Настройка продолжается. При штатных параметрах PID сервоприводов кончик полностью вытянутой руки проседал примерно на 50 mm под её собственным весом. После настройки PID прогиб уменьшился примерно до 5 mm. Отдельный профиль точности разрабатывается.
<!-- /translated-content -->
