roboninecom/SO-ARM102/docs/bom.md

# Bill of materials

<!-- documentation-languages -->
[English](i18n/en/docs/bom.md) · [Русский](i18n/ru/docs/bom.md) · [Español](i18n/es/docs/bom.md) · [Français](i18n/fr/docs/bom.md) · [Deutsch](i18n/de/docs/bom.md) · [Português (Brasil)](i18n/pt-BR/docs/bom.md) · [简体中文](i18n/zh-CN/docs/bom.md) · [日本語](i18n/ja/docs/bom.md) · [हिन्दी](i18n/hi/docs/bom.md) · [العربية](i18n/ar/docs/bom.md)
<!-- /documentation-languages -->

Quantities are for one complete kit: one follower arm and one leader arm.
Printed parts are listed separately in [printing.md](printing.md).

## Estimated kit cost

**One leader + one follower: $342.4 in components, or $388.4 including printing material.**

| Category | Cost of quantities used (USD) | Buy full packs / spools (USD) |
|---|---:|---:|
| Servos (12 pcs) | $240.7 | $240.7 |
| Electronics, camera and power supplies | $50.5 | $50.5 |
| Bearings, steel guide rods and table clamps | $40.0 | $52.0 |
| Fasteners | $11.2 | $28.6 |
| **Components subtotal** | **$342.4** | **$371.8** |
| Printing material: 0.4 kg PET-CF17 + 0.3 kg PETG-CF + 0.5 kg PLA+ | $46.0 | $58.0 |
| **Total with printing material** | **$388.4** | **$429.8** |

The **Total (USD)** column is the cost of the quantity needed for one kit,
using the reference offer behind each existing line total (not the sum of supplier offers).
Included screws cost $0; alternative carbon tubes are excluded from totals.
Estimates use the reference prices listed below, with each line rounded to cents.
They are not new supplier quotes: confirm the selected variants, minimum order
quantities and prices before ordering. Shipping, taxes, tools, a computer, a printer,
electricity and assembly labour are excluded.

The full-pack column includes unused spares: 0.5 kg spool of PET-CF17, 1.0 kg spools of PETG-CF and PLA+. Printing quantities are budget allowances; re-slice the supplied
3MF projects for your settings. Rod costs use steel; carbon tubes are an alternative.

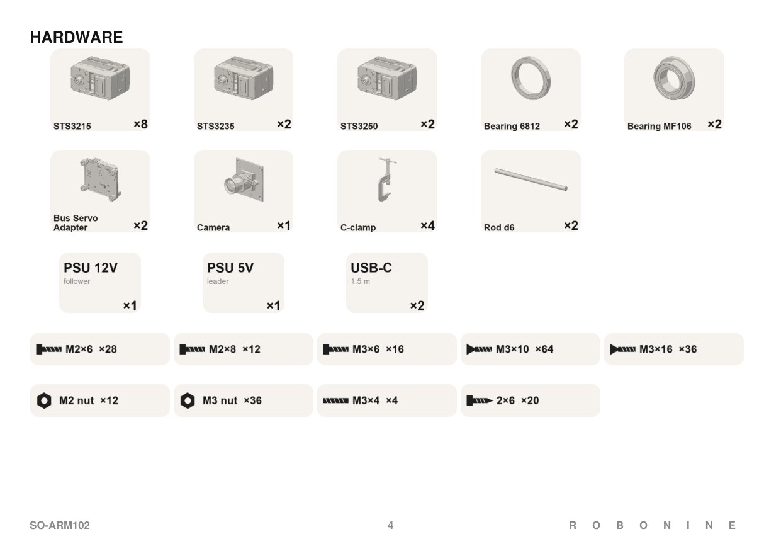
[picture p2: assets/images/assembly/hardware.jpg]
Kit hardware


## Servos

| Joint | ID | Follower | Leader |
|---|:-:|---|---|
| Base rotation | 1 | ST-3235-С001 | ST-3215-C066, 1:191 |
| Shoulder lift | 2 | ST-3250-С002 | ST-3215-C066, 1:191 |
| Elbow flex | 3 | ST-3250-С002 | ST-3215-C066, 1:191 |
| Wrist flex | 4 | ST-3235-С001 | ST-3215-C066, 1:191 |
| Wrist roll | 5 | ST-3215-C049, 1:191 | ST-3215-C066, 1:191 |
| Gripper / Trigger | 6 | ST-3215-C049, 1:191 | ST-3215-C066, 1:191 |

Totals: 6 × STS3215 7.4V, 2 × STS3215 12V, 2 × STS3235 12V, 2 × STS3250 12V. All are Feetech TTL serial bus servos.

| Servo | Qty | Selection | Aliexpress link | Unit price (USD) | Alibaba link | Unit price (USD) | Total (USD) |
|---|---|---|---|---|---|---|---|
| STS3215 | 6 | 7.4V TTL version for leader servos. Select ST-3215-C066 (7.4V). | [Aliexpress](https://www.aliexpress.us/item/3256811860804361.html) | $32.8 | [Alibaba](https://www.alibaba.com/product-detail/Feetech-SO-ARM101-LeRobot-Open-Source_1601636174153.html) | $6.7 | $40.4 |
| STS3215 | 2 | 12V TTL version for follower joints 5 and 6. Select ST-3215-C049 (12V30KG). | [Aliexpress](https://www.aliexpress.us/item/3256811832699316.html) | $55.8 for 2pcs | [Alibaba](https://www.alibaba.com/product-detail/6pcs-12V-30KG-1-345-STS3215_1601900233170.html) | $14.7 | $29.4 |
| STS3235 | 2 | 12V TTL version for follower joints 1 and 4. | [Aliexpress](https://www.aliexpress.us/item/3256810213842277.html) | $63.0 | [Alibaba](https://www.alibaba.com/product-detail/FEETECH-STS3235-12V-30KG-TTL-Dual_1601910640629.html) | $40.8 | $81.6 |
| STS3250 | 2 | 12V TTL version for follower joints 2 and 3. | [Aliexpress](https://www.aliexpress.us/item/3256811995148799.html) | $126.4 for 2pcs | [Alibaba](https://www.alibaba.com/product-detail/Feetech-STS3250-12V-50kg-Servo-High_1601711893549.html) | $44.6 | $89.3 |
| **Total** | | | | | | | **$240.7** |

- **Follower, 12V.** STS3250 is a 50 kg·cm brushless servo at 75 RPM. It drives the two joints that carry the most load.
  STS3235 is a 30 kg·cm servo with lower backlash than the STS3215.
- **Leader, 5V.** The leader servos are only read, never loaded. You can use a passive ST-3215-C066 without motor and gearbox **only** for leader arm.
- Servo horns and the M3 × 6 horn screws come with the servos.

## Servo cables

The STS3250 servos come with 22 cm long cables, while the STS3215 servos come with 17 cm long cables. Assembling follower + leader requires 4 long cables and 8 standard ones, meaning you'll need to purchase two additional cables that are 22 cm or longer. You will need them to join servos ID1 to ID2 and ID3 to ID4 ([assembly-guide.md](assembly-guide.md)).

5264 3p Wire Double Head Reverse 300 mm [Aliexpress](https://www.aliexpress.us/item/3256809219214030.html) [Amazon](https://www.amazon.com/waveshare-5264-3PIN-Servo-Compatible-servos/dp/B0GVDPPF72/)

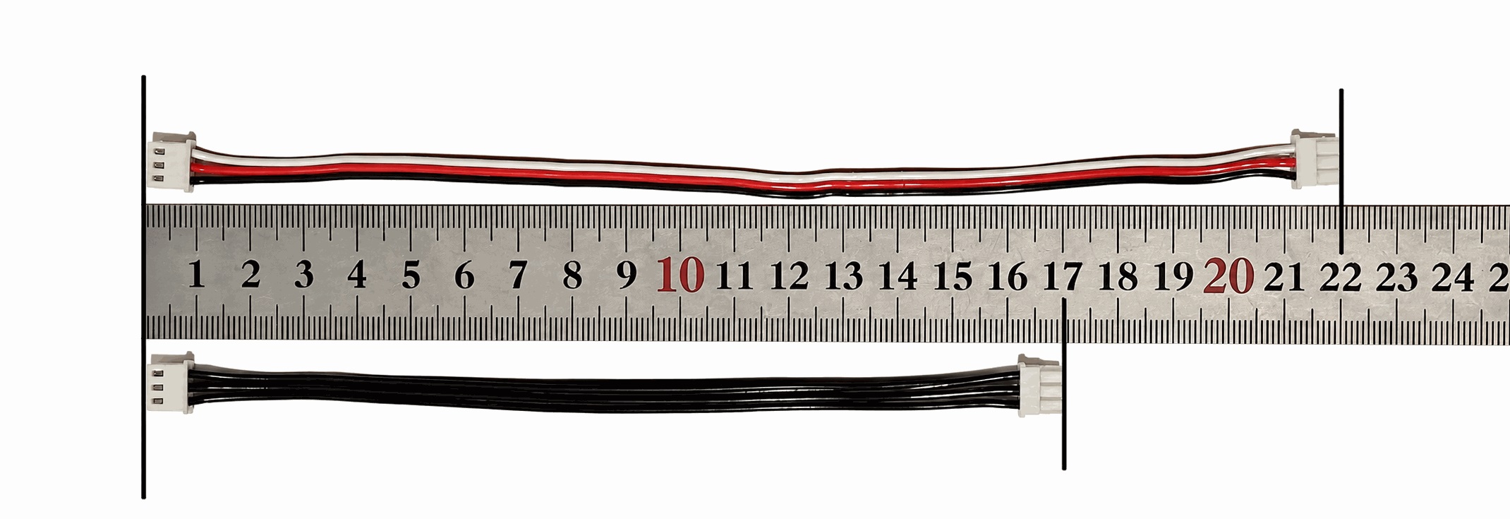
[picture p3: assets/images/assembly/cables-length.jpg]
Cables length


## Electronics

| Item | Qty | Notes | Buy US | Unit cost (US) | Buy US | Unit cost (US) | Buy EU | Unit cost (EU) | Total (USD) |
| --- | --- | --- | --- | --- | --- | --- | --- | --- | --- |
| Waveshare Bus Servo Adapter | 2 | Servo controller | [Amazon](https://www.amazon.com/Waveshare-Integrates-Control-Applicable-Integrate/dp/B0CJ6TP3TP/) | $13.0 | [Aliexpress](https://www.aliexpress.us/item/3256810343532716.html) | $7.4 | [Amazon EU](https://www.amazon.fr/-/en/Serial-Integrates-Control-Circuit-Support/dp/B0CJBKQ8LJ/) | €11.9 | $14.8 |
| Power supply 12V DC (12V 5A power supply 5.5 2.1mm) | 1 | Follower. 60W / 5A or more recommended. The arm peaked at 3.3A under a 300g load. Match the Adapter's connector (5.5x2.1mm). | [Amazon](https://www.amazon.com/Power-Supply-Adapter-5-5x2-1-2-5mm/dp/B0C3CJF313/) | $10.0 | [Aliexpress](https://www.aliexpress.us/item/3256812113231032.html) | $6.60 | [Amazon EU](https://www.amazon.fr/-/en/zstg-Universal-Power-Supply-Connector/dp/B0GTLSRM91/) | €12.00 | $6.6 |
| Power supply 5V DC (5V 2A power supply 5.5 2.1mm) | 1 | Leader. Match the Adapter's connector (5.5x2.1mm). | [Amazon](https://www.amazon.com/MTDZKJG-Adapter-100V-240V-Transformer-Security/dp/B0BZP65GRW/) | $6.2 | [Aliexpress](https://www.aliexpress.us/item/3256812479558626.html) | $4.1 | [Amazon EU](https://www.amazon.fr/5V-2A-Supply-DC-Adapter/dp/B0GDXFRYJS/) | €11.0 | $4.1 |
| USB-C cable, 1.5 m (USB A to USB C data cable 1.5m) | 2 | One per controller. Choose a data cable, not a charging-only cable. | [Amazon](https://www.amazon.com/Data-Cable-1-5ft-10Gbps-Transfer/dp/B0FMJTHRCM/) | $6.0 | [Aliexpress](https://www.aliexpress.us/item/3256812299430938.html) | $3.0 | [Amazon EU](https://www.amazon.fr/-/en/10Gbps-Transfer-Charging-Samsung-External/dp/B0DHZ1R8FQ/) | €7.0 | $6.0 |
| USB camera (OV2735, 1080P USB Camera Module, 2MP 1920x1080, UVC Camera, 2.8 or 3.0 mm lens) | 1 | Wrist camera on the follower gripper. The prototype used an OV2735 module. Check module dimensions and mounting holes against the camera holder. | [Amazon](https://www.amazon.com/innomaker-Computer-Raspberry-Support-Windows/dp/B0CNCSFQC1/) | $19.0 | [Aliexpress](https://www.aliexpress.us/item/3256804452094739.html) | $26.1 | [Amazon EU](https://www.amazon.fr/InnoMaker-Raspberry-Compatible-Windows-Android/dp/B0CNCSFQC1/) | €21.0 | $19.0 |
| **Total** | | | | | | | | | **$50.5** |

## Mechanical parts

| Item | Size | Qty | Where | Buy US | Unit cost (US) | Buy US | Unit cost (US) | Buy EU | Unit cost (EU) | Total (USD) |
| --- | --- | --- | --- | --- | --- | --- | --- | --- | --- | --- |
| Ball bearing 6812 | 60 × 78 × 10 mm | 2 | Base rotation, one per arm | [Amazon](https://www.amazon.com/Othmro-6812-2RS-60x78x10mm-Accuracy-Bearing/dp/B081W9QL2Z/) | $5.9 | [Aliexpress](https://www.aliexpress.us/item/3256812369319030.html) | $39.6 / 2 | [Amazon EU](https://www.amazon.fr/-/en/XYWHPGV-6812-2RS-Groove-Bearings-Chrome/dp/B0CQLT6J6D/) | €7.4 / 2 | $11.8 |
| Flanged bearing MF106ZZ | 6 × 10 × 3 mm | 2 | Gripper main frame | [Amazon](https://www.amazon.com/METERXITY-Shielded-Bearings-Wheelbarrow-Machines/dp/B0F4QXJSRQ/) | $6.6 / 4 | [Aliexpress](https://www.aliexpress.us/item/3256807821523719.html) | $6.0 / 10 | [Amazon EU](https://www.amazon.fr/-/en/PRECISCRY-DE-SGQ-FLZC-11-MF128ZZ-8x12x3-5-5Pcs/dp/B0GQK9BGWK/) | €11.6 / 5 | $1.2 |
| Rod (Stainless Steel Round Rod, 6mm Diameter, Length 125mm) | Ø6 × 125 mm, carbon or steel | 2 | Gripper guides | [Amazon](https://www.amazon.com/SKYPRO-Stainless-Diameter-Industry-Working/dp/B0CLCSWSJ9?th=1) | $11.9 / 5 | [Aliexpress](https://www.aliexpress.us/item/3256805290944526.html) | $2.80 | [Amazon EU](https://www.amazon.fr/-/en/SKYPRO-Stainless-Diameter-Industry-Metalworking/dp/B0CLCSWSJ9/) | €14.4 / 5 | $4.8 |
| Aluminium guide tube, alternative | Ø6 × 4 × 125 mm; cut 1 × 300 mm into 2 × 125 mm; deburr | 2 | Alternative to steel gripper guide rods | [Amazon](https://www.amazon.com/dp/B0DRG94GJB/) | $10.0 / 3 pcs | [Aliexpress](https://www.aliexpress.us/item/3256804988048256.html) | $4.1 / 1 pc | [Amazon EU](https://www.amazon.de/dp/B0D266J2NF/) | €14.9 / 3 pcs | $3.3 (alternative) |
| Carbon tube (Carbon tube, 6mm x 4mm x 125mm), alternative | Ø6 × 4 × 125 mm | 2 | Alternative to steel gripper guide rods | [Amazon](https://www.amazon.com/MECCANIXITY-Carbon-Pultruded-Airplane-Quadcopter/dp/B0CZDCW2NL/) | $5.6 / 2 | [Aliexpress](https://www.aliexpress.us/item/3256812851232051.html) | $5.9 / 2 | [Amazon EU](https://www.amazon.fr/-/en/QUARKZMAN-Carbon-Fiber-Tubes-Aircraft/dp/B0CZQVN7JB/) | €8.1 / 2 | $5.6 (alternative) |
| C-clamp | 3 inch, 0–75 mm opening | 4 | Two per arm, to fix the base to the table | [Amazon](https://www.amazon.com/Inch-Clamp-Woodworking-Precision-Carpentry/dp/B0FLHZVM7G/) | $10.0 / 2 | [Aliexpress](https://www.aliexpress.us/item/3256813098676278.html) | $9.7 | [Amazon EU](https://www.amazon.fr/Performance-75mm-Adjustable-Stainless-Metalworking/dp/B0GSQL9BCN/) | €17.4 / 2 | $20.0 |
| Rubber O-ring | 8 × 2 mm | 10 | Adds friction to the leader joints. Two per servo on joints 2–4, one on joints 1, 5, 6. | [Amazon](https://www.amazon.com/uxcell-Rings-Nitrile-Rubber-Diameter/dp/B07F329SW1/) | $6.0 / 50 | [Aliexpress](https://www.aliexpress.us/item/3256812453064283.html) | $2.3 / 30 | [Amazon EU] | € | $2.3 |
| **Total** | | | | | | | | | | **$40.0** |

## Fasteners

Kit totals as packed in the assembly booklet.

Use a removable threadlocker compatible with the printed plastic, e.g. [Vibra-Tite VC-3](https://www.vibra-tite.com/faq/if-vc-3-has-mek-how-can-it-be-plastic-compatible/). Apply VC-3 to metal screw threads and let it dry fully before assembly (at least 30 minutes per its [technical data sheet](https://www.vibra-tite.com/wp-content/uploads/213_tds.pdf)); do not apply it wet to plastic. Confirm compatibility with your filament on a spare print first.

| Fastener | Standard | Qty | Buy US | Unit cost (US) | Buy US | Unit cost (US) | Buy EU | Unit cost (EU) | Total (USD) |
| --- | --- | --- | --- | --- | --- | --- | --- | --- | --- |
| M2 × 6 socket head | DIN 912 | 28 | [Amazon](https://www.amazon.com/Socket-Stainless-Threaded-Furniture-Printing/dp/B0DKY8XHB1/) | $6.6 / 60 | [Aliexpress](https://www.aliexpress.us/item/3256812583382995.html) | $3.7 / 100 | [Amazon EU](https://www.amazon.fr/-/en/THFJWJ-M2-Allen-Cylinder-Screws/dp/B0FP8ZP1XT/) | €6.60 / 60 | $1.0 |
| M2 × 8 socket head | DIN 912 | 12 | [Amazon](https://www.amazon.com/Socket-Stainless-Threaded-Furniture-Printing/dp/B0DKY7L8YJ/) | $6.6 / 50 | [Aliexpress](https://www.aliexpress.us/item/3256812583382995.html) | $4.1 / 100 | [Amazon EU](https://www.amazon.fr/-/en/THFJWJ-M2-Allen-Cylinder-Screws/dp/B0FP8ZKVDN/) | €7.00 / 60 | $0.5 |
| M3 × 10 countersunk | DIN 7991 | 64 | [Amazon](https://www.amazon.com/M3-0-5-Socket-Screws-Alloy-Threaded/dp/B08HNF3J3D/) | $9.0 / 100 | [Aliexpress](https://www.aliexpress.us/item/3256812583382995.html) | $3.7 / 50 | [Amazon EU](https://www.amazon.fr/-/en/Mbsomnus-Countersunk-Stainless-Mechanical-Furniture/dp/B0DY12R93P/) | €8.0 / 60 | $4.6 |
| M3 × 16 countersunk | DIN 7991 | 36 | [Amazon](https://www.amazon.com/Skweawert-40-Pcs-M3x16mm-countersunk/dp/B0D7MY32JZ/) | $6.2 / 40 | [Aliexpress](https://www.aliexpress.us/item/3256812583382995.html) | $4.10 / 50 | [Amazon EU](https://www.amazon.fr/-/en/Mbsomnus-Countersunk-Stainless-Mechanical-Furniture/dp/B0DY138MGY/) | €8.0 / 60 | $2.9 |
| M3 × 4 set screw | DIN 913 | 4 | [Amazon](https://www.amazon.com/Generic-Bathroom-Fixtures-Furniture-Project/dp/B0H8DPZJPQ/) | $4.6 / 60 | [Aliexpress](https://www.aliexpress.us/item/3256805653005840.html) | $2.1 / 10 | [Amazon EU](https://www.amazon.fr/-/en/MIETONG-Hex-Socket-Grub-Screws/dp/B0FSKLJR93/) | €6.0 / 20 | $0.3 |
| M2 hex nut | DIN 934 | 12 | [Amazon](https://www.amazon.com/1-10Pcs-M1-M20-Stainless-Steel-Loose/dp/B0GVMQ3VD5/) | $3.5 / 100 | [Aliexpress](https://www.aliexpress.us/item/3256812621986317.html) | $4.1 / 100 | [Amazon EU](https://www.amazon.fr/-/en/PRORAJE-Stainless-Steel-Hexagonal-Diameter/dp/B0GVC5QKH9/) | €6.0 / 20 | $0.4 |
| M3 hex nut | DIN 934 | 36 | [Amazon](https://www.amazon.com/FOCMKEAS-Stainless-Hexagon-Fasteners-Hardware/dp/B0CR7WL4D6/) | $3.7 / 50 | [Aliexpress](https://www.aliexpress.us/item/3256812621986317.html) | $4.0 / 100 | [Amazon EU](https://www.amazon.fr/-/en/PRORAJE-Stainless-Steel-Hexagonal-Diameter/dp/B0GVC7PD4Q/) | €6.3 / 50 | $1.4 |
| M3 × 6 Phillips-head screw | from servo kit | 16 | Included with the servos. | — | — | — | — | — | — |
| Self-tapping screw 2 × 6 | from servo kit | 20 | Included with the servos. | — | — | — | — | — | — |
| **Total** | | | | | | | | | **$11.2** |

Black fasteners match the look of the renders but are not required.

## Printing materials

| Material | Use | Purchase link | Price / budget (USD) | Total (USD) |
|---|---|---|---|---:|
| Fiberon PET-CF17 | Arm links and servo holders | [Polymaker](https://shop.polymaker.com/products/fiberon-pet-cf17) | $25.0 / 0.5 kg | $20.0 (0.4 kg) |
| PETG-CF | Gripper and base parts | [Amazon](https://www.amazon.com/ELEGOO-Filament-Strength-Resistance-Functional/dp/B0F37YCK6K/) | PETG-CF: $19.0 / 1 kg | $5.7 (0.3 kg) |
| PLA+ | Leader | [Amazon](https://www.amazon.com/ELEGOO-Filament-Printing-Dimensional-Cardboard/dp/B0C6XG88RG/) | PLA+: $14.0 / 1 kg | $7.0 (0.5 kg) |
| **Total** | | | | **$46.00** |

Use the [printing guide](printing.md) and re-slice the supplied 3MF projects to determine
the filament quantity for your printer and settings.

## Tools

Allow about **$10.0** for a small hex-key and screwdriver set if you do not already own these tools.

- Hex key 1.5 mm for M2 screws: [Amazon search](https://www.amazon.com/s?k=1.5mm+hex+key)
- Hex key 2 mm for M3 screws: [Amazon search](https://www.amazon.com/s?k=2mm+hex+key)
- Phillips PH1 screwdriver for servo horn screws: [Amazon search](https://www.amazon.com/s?k=PH1+Phillips+screwdriver)
