roboninecom/SO-ARM102/assets/images/assembly/printed-parts.jpg

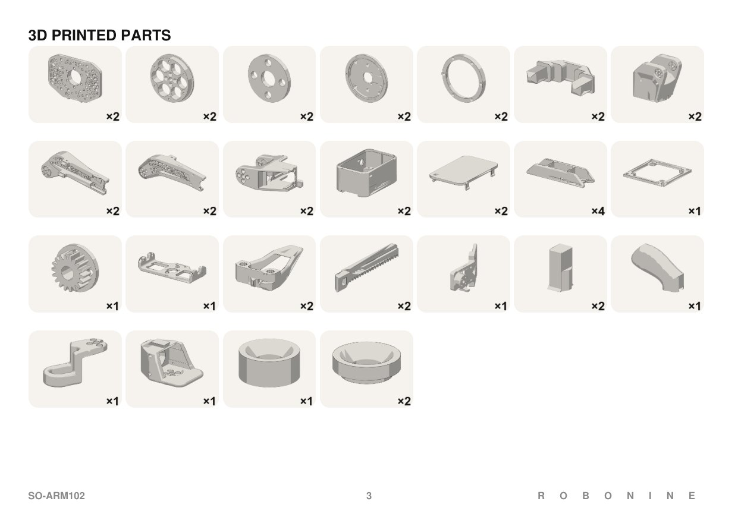
assets/images/assembly/printed-parts.jpg
