roboninecom/SO-ARM102/models/3mf/SO102.2.01_Follower_table_base_PETG-CF_(D6.1).3mf

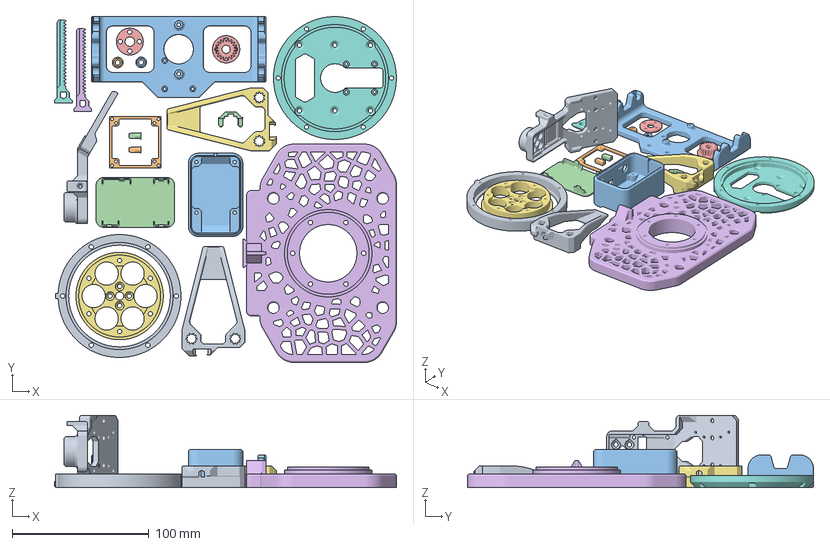
[picture p5: CAD file, 2026-11-07]
models/3mf/SO102.2.01_Follower_table_base_PETG-CF_(D6.1).3mf
250.5 x 253.4 x 53.0 mm
RB9.01.062.075 Camera holder
RB9.01.062.090 Camera spacer
RB9.01.062.012 Main frame (D6.1)
RB9.01.062.100 Nail x 2
RB9.01.062.040 Gear for gripper
RB9.01.062.030 Gear rack x 2
RB9.01.062.025 Clamp (D6.1) x 2
SO102.02.101 Board holder
SO102.02.101-01 Board cap
SO102.02.030 Base washer
SO102.01.010 Base
SO102.02.020 Base ring
SO102.02.040 Bottom top plate
SO102.02.050 Bottom ring
RB9.01.062.050 Washer x 2
SO102.02.130 Cable snap
