roboninecom/SO-ARM102/models/step/common/SO102.02.101-01 Board cap.STEP

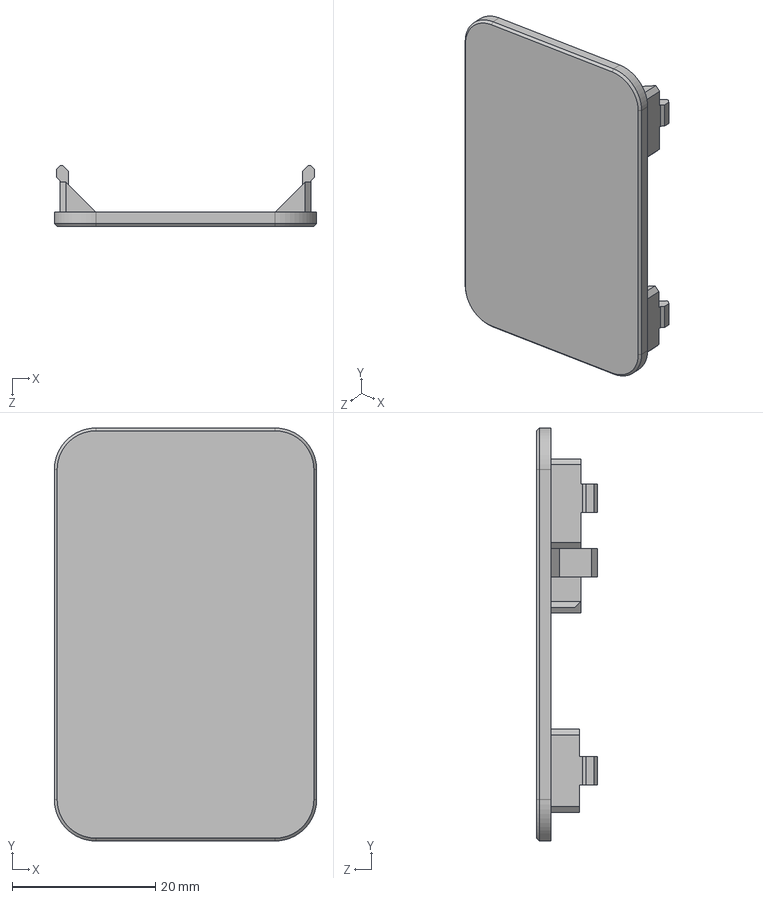
[picture p6: CAD file, 2026-11-07]
models/step/common/SO102.02.101-01 Board cap.STEP
36.6 x 57.6 x 8.50 mm
