roboninecom/SO-ARM102/models/step/leader/SO102 Wrist roll.STEP

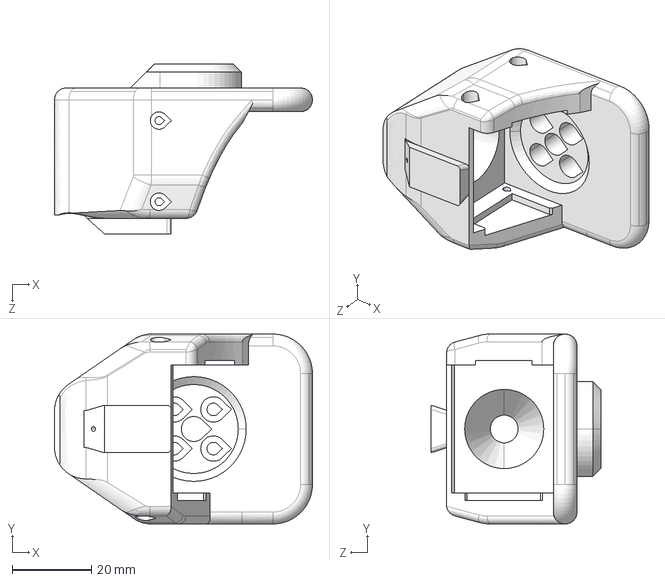
[picture p8: CAD file, 2026-11-02]
models/step/leader/SO102 Wrist roll.STEP
65.2 x 48.0 x 42.9 mm
