roboninecom/SO-ARM102/models/step/follower/RB9.01.062.100 Nail.STEP

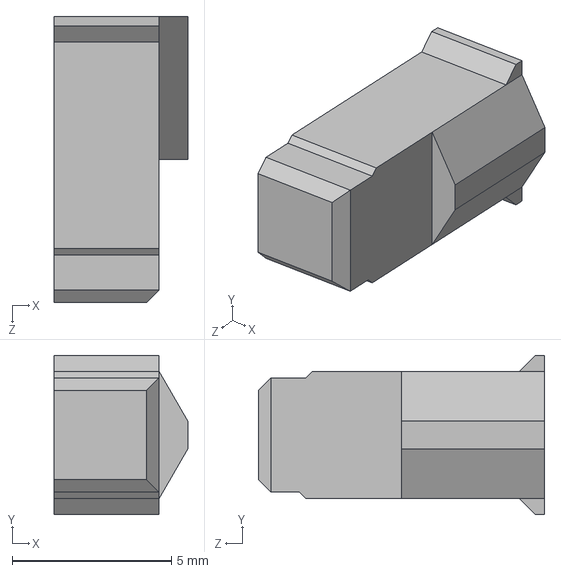
[picture p9: CAD file, 2026-11-07]
models/step/follower/RB9.01.062.100 Nail.STEP
4.20 x 5.00 x 9.00 mm
