roboninecom/SO-ARM102/models/3mf/SO102.3.01_Leader_table_PLA+.3mf

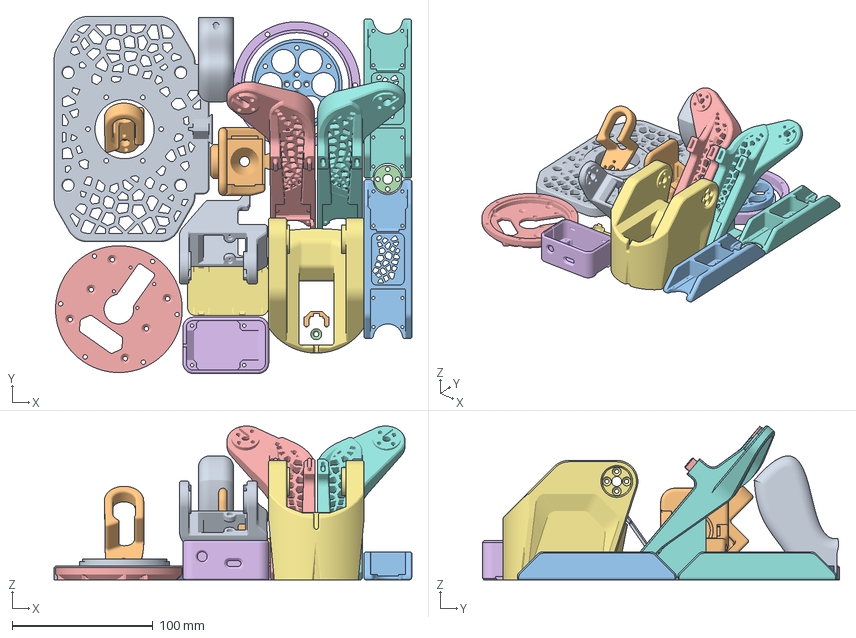
[picture p10: CAD file, 2026-11-07]
models/3mf/SO102.3.01_Leader_table_PLA+.3mf
254.0 x 253.6 x 109.4 mm
SO102_Handle
SO102 Wrist roll
SO102.02.020 Base ring
SO102.02.030 Base washer
SO102.02.040 Bottom top plate
SO102.02.050 Bottom ring
SO102.02.060 Bottom servo holder
SO102.02.080-01 Upper arm right
SO102.02.090 Wrist holder
SO102.02.130 Cable snap
SO102.02.070 Bottom arm x 2
SO102 Washer
SO102.02.080 Upper arm
SO102.02.101 Board holder
SO102.02.101-01 Board cap.STL
SO102.01.010 Base
SO102_Trigger
