roboninecom/SO-ARM102/models/step/follower/RB9.01.062.030 Gear rack.STEP

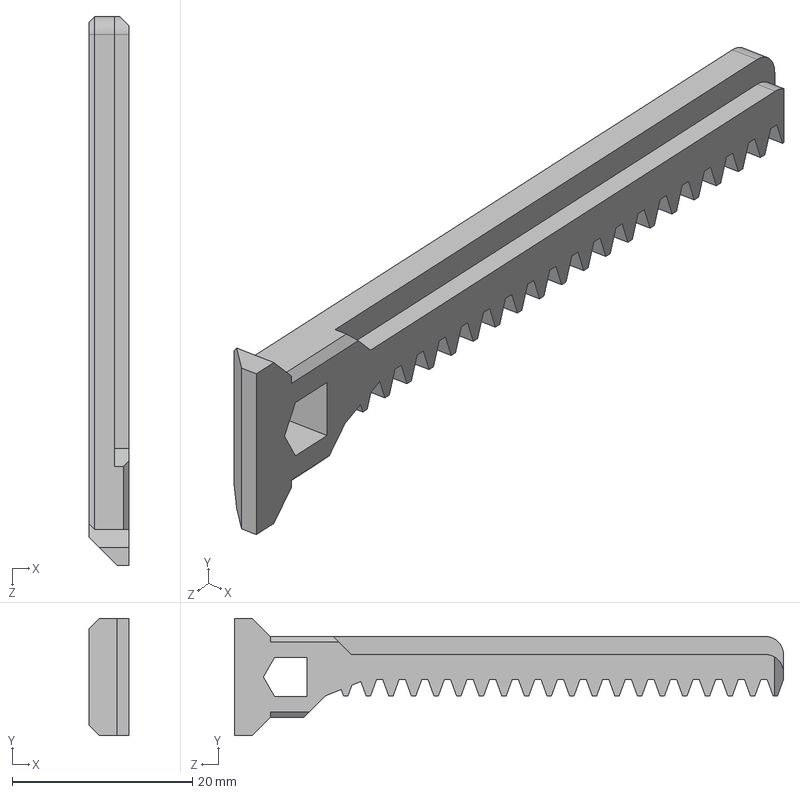
[picture p11: CAD file, 2026-11-07]
models/step/follower/RB9.01.062.030 Gear rack.STEP
4.40 x 13.0 x 61.0 mm
