roboninecom/SO-ARM102/models/3mf/SO102.1.01_Follower_table_arm_links_PET-CF.3mf

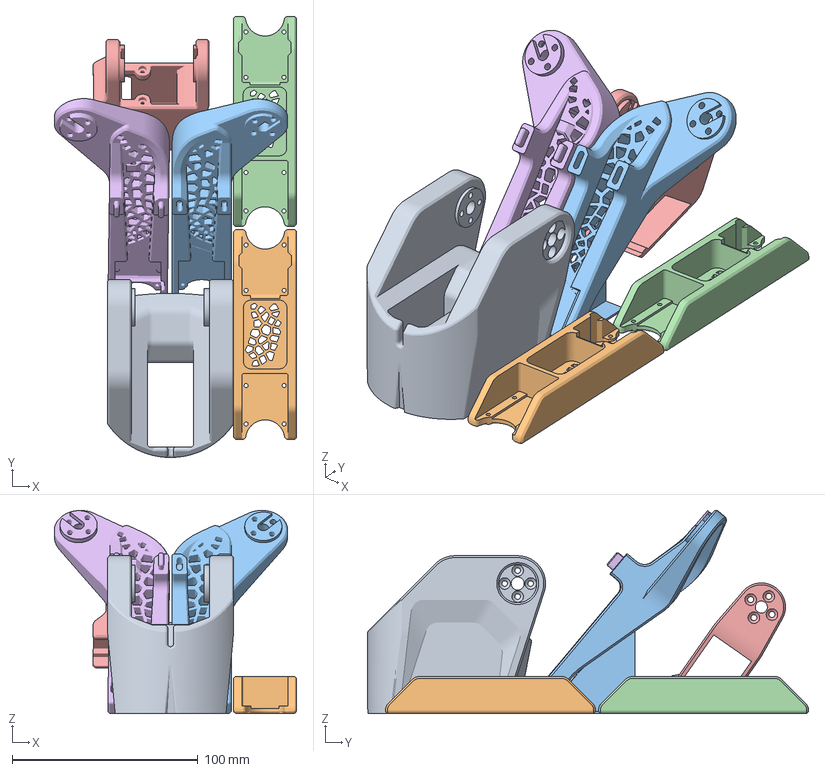
[picture p12: CAD file, 2026-11-07]
models/3mf/SO102.1.01_Follower_table_arm_links_PET-CF.3mf
130.6 x 237.5 x 109.4 mm
SO102.02.060 Bottom servo holder
SO102.02.070 Bottom arm x 2
SO102.02.080-01 Upper arm right
SO102.02.090 Wrist holder
SO102.02.080 Upper arm
