roboninecom/SO-ARM102/models/step/follower/RB9.01.062.025 Clamp (D6.0).STEP

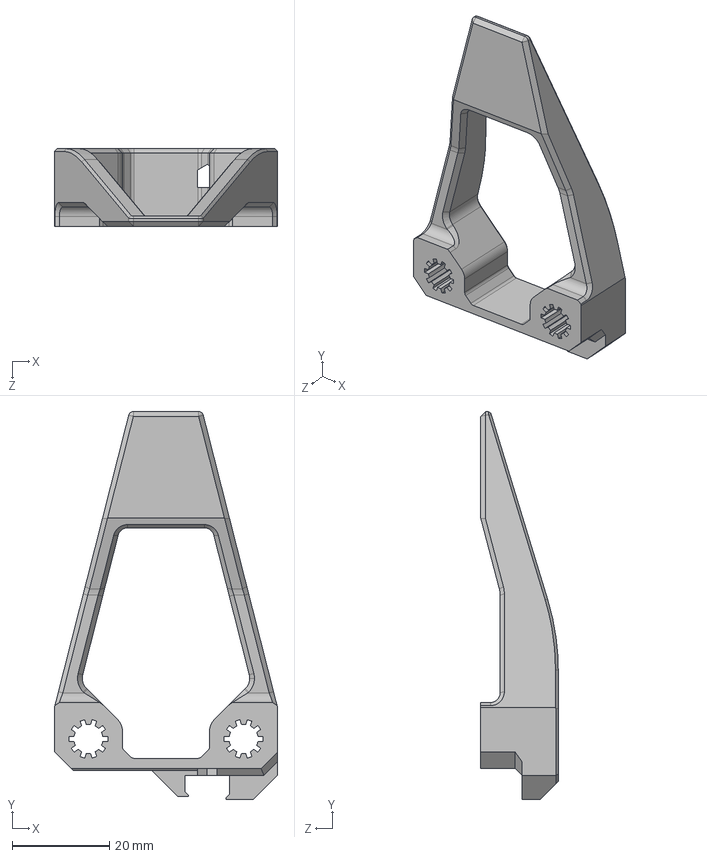
[picture p13: CAD file, 2026-11-07]
models/step/follower/RB9.01.062.025 Clamp (D6.0).STEP
46.0 x 80.0 x 16.0 mm
