roboninecom/SO-ARM102/models/3mf/colored_figures.3mf

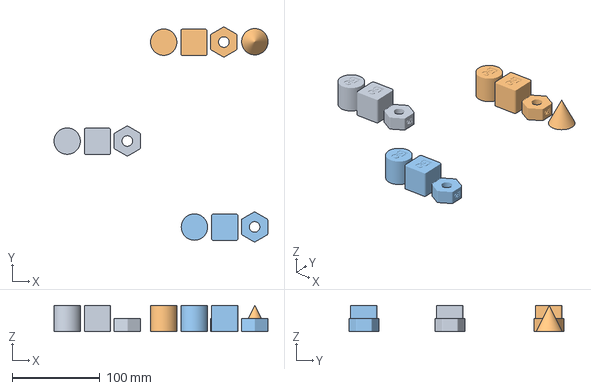
[picture p14: CAD file, 2026-11-03]
models/3mf/colored_figures.3mf
243.4 x 244.4 x 30.0 mm
cube_cylinder_nut.STL x 2
cube_cylinder_nut_cone.STL
