roboninecom/SO-ARM102/models/step/follower/RB9.01.062.075 Camera holder.STEP

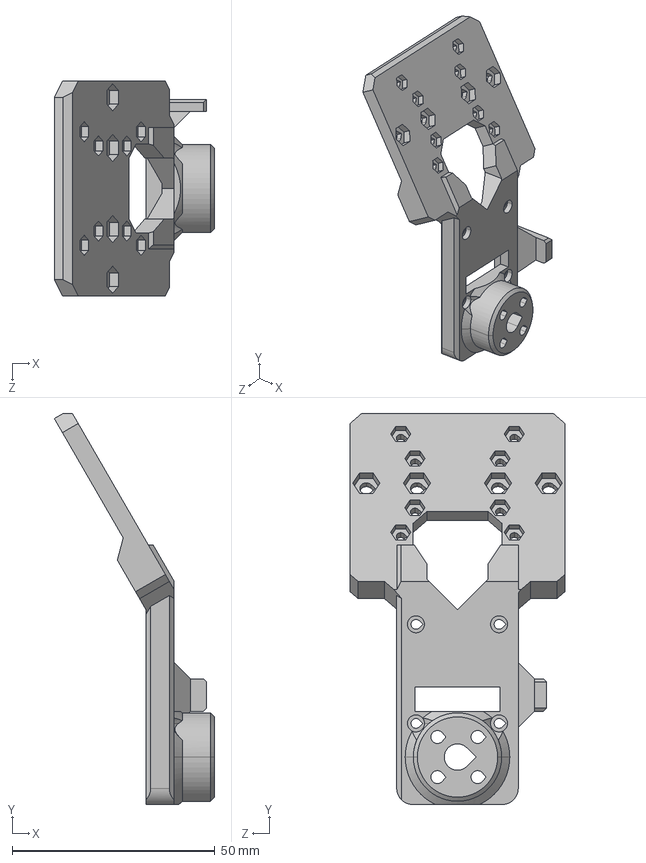
[picture p15: CAD file, 2026-11-02]
models/step/follower/RB9.01.062.075 Camera holder.STEP
39.6 x 96.5 x 53.0 mm
