roboninecom/SO-ARM102/models/step/leader/SO102 Washer.STEP

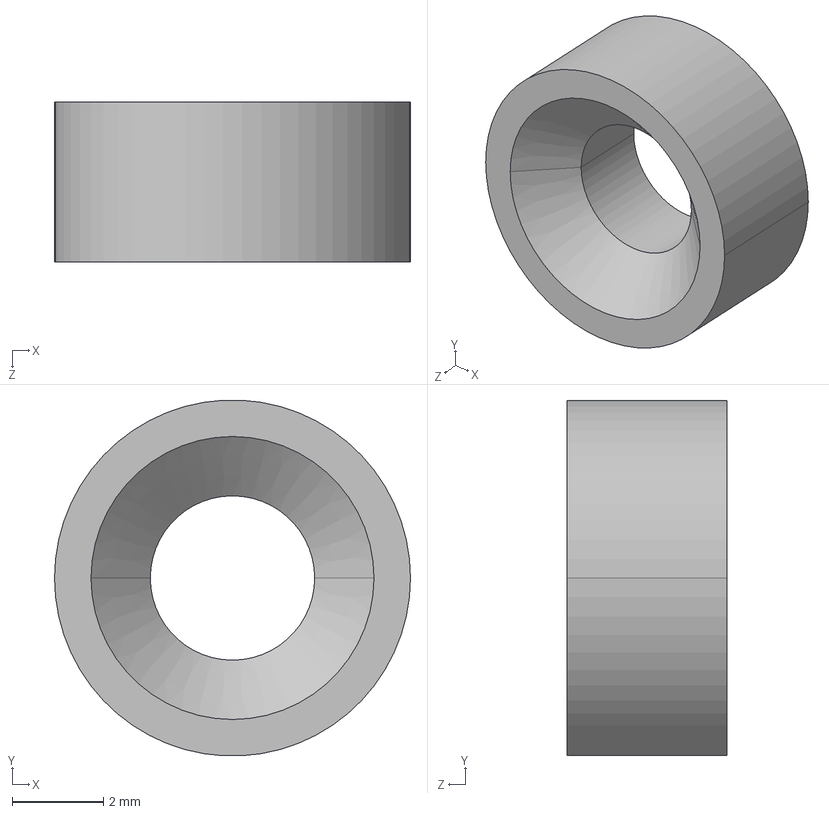
[picture p16: CAD file, 2026-11-02]
models/step/leader/SO102 Washer.STEP
7.80 x 7.79 x 3.50 mm
