roboninecom/SO-ARM102/(list of files, cad)

Other CAD files:
models/stl/test/Gripper rods test plate D6.0-D6.2.STL
models/3mf/SO102.2.01_Follower_table_base_PETG-CF_(D6.0).3mf
models/3mf/SO102.2.01_Follower_table_base_PETG-CF_(D6.2).3mf
models/step/follower/RB9.01.062.025 Clamp (D6.1).STEP
models/stl/common/SO102.02.101-01 Board cap.STL
models/stl/follower/RB9.01.062.025 Clamp (D6.0).STL
models/stl/follower/RB9.01.062.025 Clamp (D6.1).STL
models/stl/follower/RB9.01.062.025 Clamp (D6.2).STL
models/stl/follower/RB9.01.062.030 Gear rack.stl
models/stl/follower/RB9.01.062.075 Camera holder.STL
models/stl/follower/RB9.01.062.100 Nail.stl
models/stl/leader/SO102 Washer.STL
models/stl/leader/SO102 Wrist roll.stl
