roboninecom/SO-ARM102/docs/i18n/ar/docs/assembly-guide.md

<div dir="rtl" lang="ar">

<!-- translation-navigation -->
[English](../../en/docs/assembly-guide.md) · [Русский](../../ru/docs/assembly-guide.md) · [Español](../../es/docs/assembly-guide.md) · [Français](../../fr/docs/assembly-guide.md) · [Deutsch](../../de/docs/assembly-guide.md) · [Português (Brasil)](../../pt-BR/docs/assembly-guide.md) · [简体中文](../../zh-CN/docs/assembly-guide.md) · [日本語](../../ja/docs/assembly-guide.md) · [हिन्दी](../../hi/docs/assembly-guide.md) · [العربية](assembly-guide.md)

[الأصل الإنجليزي](../../../assembly-guide.md)

[الوثائق](../README.md) · [الطباعة](printing.md) · [قائمة المواد](bom.md) · [التجميع](assembly-guide.md) · [المواصفات](specifications.md) · [النماذج](../models/README.md) · [المساهمة](../CONTRIBUTING.md) · [التراخيص](../LICENSING.md) · [الترجمات](translations.md)

> هذه ترجمة كاملة للوثيقة. الرسوم وكتيب PDF الأصلي مشتركة بين اللغات. أعدت الترجمة بمساعدة الذكاء الاصطناعي ولم يراجعها متحدثون أصليون بعد.
<!-- /translation-navigation -->

<!-- translated-content -->

# دليل التجميع

يتبع هذا الدليل الكتيب المطبوع [SO-ARM102_assembly_A5_v0.8.pdf](../../../SO-ARM102_assembly_A5_v0.8.pdf) صفحة بصفحة. طبع الكتيب على ورق A5 مسطح إذا كنت تفضل الورقة.

قبل البدء:

- طباعة جميع الأجزاء من [printing.md](printing.md) وجمع المعدات من [bom.md](bom.md).
- أنت بحاجة إلى المفاتيح السداسية 1.5 mm (M2) و 2 mm (M3).
- اقرأ خطوتين قبل تشديد أي شيء. مكانان في الترتيب الحالي غير مريح، انظر [مشاكل معروفة](../README.md#-known-issues).

> ⚠️ **تعمل الذراع القائدة بجهد 5 V والذراع التابعة بجهد 12 V.** احتفظ بمزوّدي الطاقة منفصلين.

استخدم مثبت لولب قابلاً للفك ومتوافقاً مع البلاستيك المطبوع، مثل [Vibra-Tite VC-3](https://www.vibra-tite.com/faq/if-vc-3-has-mek-how-can-it-be-plastic-compatible/). ضع VC-3 على لولب البرغي المعدني واتركه يجف تماماً قبل التجميع (30 دقيقة على الأقل وفق [ورقة البيانات الفنية](https://www.vibra-tite.com/wp-content/uploads/213_tds.pdf))؛ لا تضعه وهو رطب على البلاستيك. اختبر أولاً توافقه مع خيط الطباعة على قطعة تجريبية.

تحذير بشأن الأدوات والفولطية

## ترتيب العمل

### قراءة الرسوم التوضيحية

تشير العلامات البيضاء إلى الأجزاء الجديدة؛ والأجزاء الرمادية هي أجزاء تم تجميعها بالفعل. وتظهر صورة صغيرة للجزء والكمية ما يجب إضافته. والدائرة المرقمة هي خطوة التجميع؛ والنقاط تبين التقدم. وأرقام الأجزاء، وأحجام الملحقات، وتحديدات محركات الخدمة هي نفسها في كل لغة.

### تسلسل التجميع

1. ضعي البوق على محركات الخدمة
2. اجمع جسم الذراع **مرتين**، مرة للذراع التابعة ومرة للقائدة (الخطوات 1–13). في الخطوتين 12–13، ركّب Bus Servo Adapter على كل ذراع.
3. اجمع الماسك المتوازي (خطوات الماسك 1–6).
4. أكمل الذراع التابعة: حامل الكاميرا والقابض والكاميرا (خطوات التابعة 1–3).
5. أكمل الذراع القائدة: المقبض والزناد (خطوات القائدة 1–2).

## معرّفات السيرفو

حدد هوية كل محرك سيرف قبل أن يدخل إلى ذراع الروبوت. أدوات لتحديد الهويات والمعايرة متاحة على [lab.robonine.com](https://lab.robonine.com).

معرفات الخادم

| ID | المفصل | سيرفو الذراع التابع | سيرفو الذراع القائد |
|:-:|---|---|---|
| 1 | دوران القاعدة | STS3235 | STS3215 |
| 2 | رفع الكتف | STS3250 | STS3215 |
| 3 | ثني المرفق | STS3250 | STS3215 |
| 4 | ثني المعصم | STS3235 | STS3215 |
| 5 | دوران المعصم | STS3215 | STS3215 |
| 6 | القابض / الزناد | STS3215 | STS3215 |

## 0.

جميع محركات السيرفو في الذراع القائدة من نوع STS3215. في الذراع التابعة، المحركان ID 1 وID 4 من نوع STS3235، والمحركان ID 2 وID 3 من نوع STS3250.

ثبّت ذراع سيرفو واحدة على المحرك ID 1 بمسمار M3 × 6 من طقم السيرفو. ركّب أذرع السيرفو على جانبي المحركات ID 2 و3 و4. تُرفق مسامير الأذرع مع محركات السيرفو. المسامير المعلّمة «servo kit» في أي خطوة تؤخذ من عبوة السيرفو، وليس من كيس المثبّتات المنفصل.

إذا أضفت حلقات أو إلى ذراع الروبوت القيادي، ضعها بين محرك الخدمة والبوق الآن. إن خطأ هذا الترتيب يمكن أن يعرقل الحلقة بين قشرة محرك الخدمة والبوق.

## 1–13:: جسم الذراع، وذراع الروبوت المتتبع، وذراع الروبوت القائد

وتكرر هذه الخطوات لكلا ذراعي الروبوت. تطابق أسماء الأجزاء المطبوعة الأسماء في [printing.md](printing.md).

| الخطوة | الأجزاء | المثبتات |
|:-:|---|---|
| 1 | SO102.02.060 حامل أدنى لمحرك سيرفو، SO102.02.040 الصفيحة السفلى العليا | مثقاب 3 × M3×16، 3 × M3 |
| 2 | — | مثقاب 3 × M3×16، 3 × M3 |
| 3 | 1 هوية الخادم | 4 × M2×6 |
| 4 | حلقة القاعدة SO102.02.020، محمل 6812، حلقة القاعدة SO102.02.050، قاعدة SO102.02.010 | مثقاب 6 × M3×16، 6 × M3 |
| 5 | SO102.02.030 غسالة قاعدة | 4 × M3×10, 6 × M3×16 |
| 6 | أجهزة سيرفو ID 2 وID 3، 2 × SO102.02.070 ذراع روبوتية أسفلية، 2 كابلات قصيرة، 1 كابل طويل | 16 × M2×6 |
| 7 | رمز السيرفو 4، SO102.02.080-01 ذراع الروبوت العلوي الأيمن، 1 كابل قصير | 4 × M2×6 |
| 8 | SO102.02.080 الذراع العلوية اليسرى | 4 × M2×6, 8 × M3×10 |
| 9 | محرك السيرفو ID 5 (STS3215)، SO102.02.090 حامل المعصم، ذراع السيرفو | 1 × M3×6 (من طقم السيرفو), 4 × 2×6 (من طقم السيرفو) |
| 10 | 1 كابل قصير | 8 × M3×10 |
| 11 | — | 8 × M3×10 |
| 12 | SO102.02.101 حامل اللوحة, Bus Servo Adapter | 4 × صامولة M2, 4 × M2×8 |
| 13 | SO102.02.101-01 غطاء اللوحة, 1 × سلك طويل | — |

| | | |
|:-:|:-:|:-:|
| الخطوة 1 | الخطوة 2 | الخطوة 3 |
| الخطوة 4 | الخطوة 5 | الخطوة 6 |
| الخطوة 7 | الخطوة 8 | الخطوة 9 |
| الخطوة 10 | الخطوة 11 | الخطوة 12 |
| الخطوة 13 | | |

تحقق من أن كل كابل محركات الخدمة يصل إلى المفصل التالي مع بعض الراحة قبل إغلاق المفصل.

## مقبض 1-6، ذراع روبوت متتبع فقط

| الخطوة | الأجزاء | المثبتات |
|:-:|---|---|
| 1 | RB9.01.062.040 عجلة للممسكة على بوق المحرك المساعدة، رقم المحرك المساعدة 6 | 4 × M3×4 مسمار تثبيت، 1 × M3×6 (من طقم السيرفو) |
| 2 | 2 × RB9.01.062.025 (D6.1) ملصق، 2 × RB9.01.062.030 رافعة عجلة، 2 × RB9.01.062.100 مسمار | — |
| 3 | 2 × قضيب قطره 6 × 125 mm | — |
| 4 | RB9.01.062.012 الإطار الرئيسي (D6.1), 2 × محمل MF106, 2 × RB9.01.062.050 حلقة | 2 × M3×10 |
| 5 | ضع القضبان في الإطار الرئيسي | — |
| 6 | دفع المشابك إلى مواقفها الخارجية، إدخال محرك الخدمة | 3 × 2×6 (من طقم السيرفو) |

تعني ×2 في الخطوة 2 تجميع فك لكل جانب. الكميات في الجدول هي الإجمالي.

أحكم براغي التثبيت من جهة ذراع السيرفو باتجاه الترس، حتى لا تبقى فجوة بينهما. قبل الخطوة 6، حرّك السيرفو ذي المعرّف 6 إلى موضعه الأدنى لكي يغلق الماسك بالكامل ويفتح حتى كامل 85 mm. قبل إغلاق المجموعة، حرّك كلا الفكين يدويًا على طول القضيبين. يجب أن يتحركا بحرية من دون انحشار.

| | | |
|:-:|:-:|:-:|
| المقبض 1 | المقبض 2 | المقبض 3 |
| المقبض 4 | المقبض 5 | المقبض 6 |

## الذراع الروبوتية المتتبعة 1–3

| الخطوة | الأجزاء | المثبتات |
|:-:|---|---|
| 1 | RB9.01.062.075 حامل كاميرا | 5 × M3×10 |
| 2 | تجميع مقبض على المعصم | 4 × 2×6 (من طقم السيرفو) |
| 3 | RB9.01.062.090 جهاز فاصل بين الكاميرات، كاميرا USB, SO102.02.130 مشبك الكابل | مثقاب 4 × M2×8، 4 × M2 |

| | | |
|:-:|:-:|:-:|
| ذراع روبوت متابعة 1 | ذراع روبوت متابعة 2 | ذراع روبوت متابعة 3 |

## ذراع روبوتية رائدة 1–2

| الخطوة | الأجزاء | المثبتات |
|:-:|---|---|
| 1 | SO102 مقبض، SO102 جزء دوران المعصم، SO102.02.130 مشبك الكابل، SO102 وردة | 4 × M3×6 (من طقم السيرفو), 1 × 2×6 (من طقم السيرفو), 1 × M3×10 |
| 2 | SO102 صمامة، محرك خدمة ID 6 | 4 × M3×6 (من طقم السيرفو), 4 × 2×6 (من طقم السيرفو) |

| | |
|:-:|:-:|
| ذراع روبوتية رائدة 1 | ذراع روبوتية رائدة 2 |

## التثبيت والتشغيل الأول

1. تثبيت كل قاعدة إلى الطاولة مع اثنين من الملحقات C.
2. صِل وحدة تحكم الذراع التابعة بمزوّد الطاقة 12 V، ووحدة تحكم الذراع القائدة بمزوّد الطاقة 5 V.
3. يربط كلا المتحكمين إلى الحاسوب مع USB-C.
4. معايرة الذراعين الروبوتيين وبدء التشغيل عن بعد على [lab.robonine.com](https://lab.robonine.com)، أو مع LeRobot SO -101 workflow.
<!-- /translated-content -->

</div>
