roboninecom/SO-ARM102/docs/i18n/de/docs/assembly-guide.md

<!-- translation-navigation -->
[English](../../en/docs/assembly-guide.md) · [Русский](../../ru/docs/assembly-guide.md) · [Español](../../es/docs/assembly-guide.md) · [Français](../../fr/docs/assembly-guide.md) · [Deutsch](assembly-guide.md) · [Português (Brasil)](../../pt-BR/docs/assembly-guide.md) · [简体中文](../../zh-CN/docs/assembly-guide.md) · [日本語](../../ja/docs/assembly-guide.md) · [हिन्दी](../../hi/docs/assembly-guide.md) · [العربية](../../ar/docs/assembly-guide.md)

[Englisches Original](../../../assembly-guide.md)

[Dokumentation](../README.md) · [Drucken](printing.md) · [Stückliste](bom.md) · [Montage](assembly-guide.md) · [Technische Daten](specifications.md) · [Modelle](../models/README.md) · [Mitwirken](../CONTRIBUTING.md) · [Lizenzen](../LICENSING.md) · [Übersetzungen](translations.md)

> Vollständige Übersetzung des Dokuments. Abbildungen und die ursprüngliche PDF-Anleitung werden gemeinsam genutzt. Mit KI übersetzt; noch nicht von Muttersprachlern geprüft.
<!-- /translation-navigation -->

<!-- translated-content -->

# Montageanleitung

Diese Anleitung folgt der gedruckten Broschüre [SO-ARM102_assembly_A5_v0.8.pdf](../../../SO-ARM102_assembly_A5_v0.8.pdf) Seite für Seite und druckt die Broschüre auf A5 Querformat aus, wenn Sie Papier bevorzugen.

Vor dem Beginn:

- Drucken Sie alle Teile aus [printing.md](printing.md) und sammeln Sie die Hardware aus [bom.md](bom.md).
- Sie benötigen die Hex-Schlüssel 1.5 mm (M2) und 2 mm (M3).
- Lesen Sie zwei Schritte voraus, bevor Sie etwas festziehen. Zwei Stellen in der aktuellen Reihenfolge sind umständlich, siehe [Bekannte Probleme](../README.md#-known-issues).

> ⚠️ **Der Leader-Arm wird mit 5 V betrieben, der Follower-Arm mit 12 V.** Halten Sie die Netzteile getrennt.

Verwenden Sie eine lösbare, mit dem gedruckten Kunststoff verträgliche Schraubensicherung, z. B. [Vibra-Tite VC-3](https://www.vibra-tite.com/faq/if-vc-3-has-mek-how-can-it-be-plastic-compatible/). VC-3 auf Metallschraubengewinde auftragen und vor der Montage vollständig trocknen lassen (mindestens 30 Minuten laut [Datenblatt](https://www.vibra-tite.com/wp-content/uploads/213_tds.pdf)); nicht nass auf Kunststoff auftragen. Verträglichkeit zuerst an einem Probedruck mit Ihrem Filament prüfen.

Werkzeug- und Spannungswarnung

## Arbeitsreihenfolge

### Lesen der Illustrationen

Beigefarbene Markierungen kennzeichnen neue Teile, graue Teile sind bereits montiert. Das Teil-Thumbnail und die Menge zeigen, was hinzugefügt werden muss. Der nummerierte Kreis ist der Montageschritt, die Punkte zeigen den Fortschritt. Teilenummern, Verbindungsgrößen und Servomotor-IDs sind in allen Sprachen gleich.

### Montagereihenfolge

1. Montieren Sie die Hörner auf den Servomotoren.
2. Bauen Sie den Roboterarmkörper **zweimal**, einmal für den Nachfolgerroboterarm und einmal für den Anführerroboterarm (Schritte 1–13). In den Schritten 12–13 wird an jedem Arm ein Bus Servo Adapter montiert.
3. Bauen Sie den Parallelgreifer (Greiferschritte 1–6).
4. Vervollständigen Sie den Follower: Kamerahalter, Greifer und Kamera (Follower-Schritte 1–3).
5. Vervollständigen Sie den Leader: Griff und Abzug (Leader-Schritte 1–2).

## Servo-IDs

Stellen Sie die ID jedes Servomotors ein, bevor er in den Roboterarm gelangt. Tools zum Setzen von IDs und Kalibrieren finden Sie unter [lab.robonine.com](https://lab.robonine.com).

Servo IDs

| ID | Gelenk | Follower-Servo | Leader-Servo |
|:-:|---|---|---|
| 1 | Basisdrehung | STS3235 | STS3215 |
| 2 | Schulterhub | STS3250 | STS3215 |
| 3 | Ellbogenbeugung | STS3250 | STS3215 |
| 4 | Handgelenkbeugung | STS3235 | STS3215 |
| 5 | Handgelenkrotation | STS3215 | STS3215 |
| 6 | Greifer / Abzug | STS3215 | STS3215 |

## 0. Servohörner

Alle Servos des Leaders sind STS3215. Beim Follower sind ID 1 und ID 4 STS3235 sowie ID 2 und ID 3 STS3250.

Befestigen Sie ein Servohorn mit einer M3 × 6 Schraube aus dem Servopaket am Servo ID 1. Die Servos ID 2, 3 und 4 erhalten auf beiden Seiten ein Horn. Die Hornschrauben liegen den Servos bei. In einem Schritt mit „servo kit“ gekennzeichnete Schrauben stammen aus dem Servopaket, nicht aus dem separaten Schraubenbeutel.

Wenn Sie O-Ringe an den Roboterarm des Leiters anbringen, setzen Sie sie jetzt zwischen Servomotor und Horn ein, da eine falsche Reihenfolge dazu führen kann, dass der Ring zwischen Servomotorgehäuse und Horn verklemmt.

## 1–13. Armkörper, Roboterarm und Leiterroboterarm

Wiederholen Sie diese Schritte für beide Roboterarme. Die Namen der Druckteile entsprechen [printing.md](printing.md).

| Schritt | Teile | Befestigungsmittel |
|:-:|---|---|
| 1 | SO102.02.060 Servomotorhalter unten, SO102.02.040 Bodenplatte oben | 3 × M3×16, 3 × M3 Mutter |
| 2 | — | 3 × M3×16, 3 × M3 Mutter |
| 3 | Servo ID 1 | 4 × M2×6 |
| 4 | SO102.02.020 Grundring, Lager 6812, SO102.02.050 Unterer Ring, SO102.02.010 Basis | 6 × M3×16, 6 × M3 Mutter |
| 5 | SO102.02.030 Unterlegscheibe | 4 × M3×10, 6 × M3×16 |
| 6 | Servos ID 2 und ID 3, 2 × SO102.02.070 Roboterarm unten, 2 kurze Kabel, 1 langes Kabel | 16 × M2×6 |
| 7 | Servo ID 4, SO102.02.080-01 Roboterarm oben rechts, 1 kurze Leitung | 4 × M2×6 |
| 8 | SO102.02.080 Oberarm links | 4 × M2×6, 8 × M3×10 |
| 9 | Servo ID 5 (STS3215), SO102.02.090 Handgelenkhalter, Servohorn | 1 × M3×6 (aus dem Servopaket), 4 × 2×6 (aus dem Servopaket) |
| 10 | 1 Kurzes Kabel | 8 × M3×10 |
| 11 | — | 8 × M3×10 |
| 12 | SO102.02.101 Platinenhalter, Bus Servo Adapter | 4 × M2-Mutter, 4 × M2×8 |
| 13 | SO102.02.101-01 Platinenabdeckung, 1 × langes Kabel | — |

| | | |
|:-:|:-:|:-:|
| Schritt 1 | Schritt 2 | Schritt 3 |
| Schritt 4 | Schritt 5 | Schritt 6 |
| Schritt 7 | Schritt 8 | Schritt 9 |
| Schritt 10 | Schritt 11 | Schritt 12 |
| Schritt 13 | | |

Prüfen Sie, ob jedes Servomotorkabel die nächste Verbindung mit etwas Spiel erreicht, bevor Sie die Verbindung schließen.

## Greifer 1–6, nur Roboterarm

| Schritt | Teile | Befestigungsmittel |
|:-:|---|---|
| 1 | RB9.01.062.040 Getriebe für Greifer am Servomotorhorn, Servomotor ID 6 | 4 × M3×4 Stellschraube, 1 × M3×6 (aus dem Servopaket) |
| 2 | 2 × RB9.01.062.025 (D6.1) Klammer, 2 × RB9.01.062.030 Zahnstange, 2 × RB9.01.062.100 Nagel | — |
| 3 | 2 × Stab Ø6 × 125 mm | — |
| 4 | RB9.01.062.012 Hauptrahmen (D6.1), 2 × Lager MF106, 2 × RB9.01.062.050 Unterlegscheibe | 2 × M3×10 |
| 5 | Schnappen Sie die Stangen in den Hauptrahmen | — |
| 6 | Die Klemmen auf ihre äußeren Anschläge schieben, den Servomotor einsetzen | 3 × 2×6 (aus dem Servopaket) |

×2 in Schritt 2 bedeutet eine Backenbaugruppe pro Seite. Die Mengen in der Tabelle sind Gesamtmengen.

Ziehen Sie die Gewindestifte von der Seite des Servohorns in Richtung Zahnrad fest, damit dazwischen kein Spalt entsteht. Stellen Sie vor Schritt 6 den Servo mit ID 6 auf seine Minimalposition, damit der Greifer vollständig schließt und sich auf die vollen 85 mm öffnet. Schieben Sie beide Klemmbacken vor dem Schließen des Gehäuses von Hand entlang der Stangen. Sie müssen sich frei und ohne Verklemmen bewegen.

| | | |
|:-:|:-:|:-:|
| Gripper 1 | Gripper 2 | Gripper 3 |
| Gripper 4 | Gripper 5 | Gripper 6 |

## Roboterarm mit Nachfolger 1–3

| Schritt | Teile | Befestigungsmittel |
|:-:|---|---|
| 1 | RB9.01.062.075 Kamerahalter | 5 × M3×10 |
| 2 | Greifermontage am Handgelenk | 4 × 2×6 (aus dem Servopaket) |
| 3 | RB9.01.062.090 Kamera-Abstandshalter, USB-Kamera, SO102.02.130 Kabelclip | 4 × M2×8, 4 × M2 Mutter |

| | | |
|:-:|:-:|:-:|
| Nachfolger Roboterarm 1 | Nachfolger Roboterarm 2 | Nachfolger Roboterarm 3 |

## Leader Roboterarm 1–2

| Schritt | Teile | Befestigungsmittel |
|:-:|---|---|
| 1 | SO102 Handgriff, SO102 Handgelenkdrehung, SO102.02.130 Kabelclip, SO102 Unterlegscheibe | 4 × M3×6 (aus dem Servopaket), 1 × 2×6 (aus dem Servopaket), 1 × M3×10 |
| 2 | SO102 Trigger, Servomotor ID 6 | 4 × M3×6 (aus dem Servopaket), 4 × 2×6 (aus dem Servopaket) |

| | |
|:-:|:-:|
| Anführer Roboterarm 1 | Anführer Roboterarm 2 |

## Befestigung und erste Inbetriebnahme

1. Klemmen Sie jede Basis mit zwei C-Klemmen an den Tisch.
2. Schließen Sie die Steuerung des Follower-Arms an das 12 V-Netzteil und die Steuerung des Leader-Arms an das 5 V-Netzteil an.
3. Verbinden Sie beide Controller mit USB-C mit dem Computer.
4. Kalibrieren Sie beide Roboterarme und starten Sie die Teleoperation unter [lab.robonine.com](https://lab.robonine.com) oder mit dem LeRobot SO-101-Workflow.
<!-- /translated-content -->
