roboninecom/SO-ARM102/docs/i18n/es/docs/assembly-guide.md

<!-- translation-navigation -->
[English](../../en/docs/assembly-guide.md) · [Русский](../../ru/docs/assembly-guide.md) · [Español](assembly-guide.md) · [Français](../../fr/docs/assembly-guide.md) · [Deutsch](../../de/docs/assembly-guide.md) · [Português (Brasil)](../../pt-BR/docs/assembly-guide.md) · [简体中文](../../zh-CN/docs/assembly-guide.md) · [日本語](../../ja/docs/assembly-guide.md) · [हिन्दी](../../hi/docs/assembly-guide.md) · [العربية](../../ar/docs/assembly-guide.md)

[Original en inglés](../../../assembly-guide.md)

[Documentación](../README.md) · [Impresión](printing.md) · [Materiales](bom.md) · [Montaje](assembly-guide.md) · [Especificaciones](specifications.md) · [Modelos](../models/README.md) · [Contribuir](../CONTRIBUTING.md) · [Licencias](../LICENSING.md) · [Traducciones](translations.md)

> Traducción completa del documento. Las ilustraciones y el manual PDF original se comparten entre idiomas. Traducción realizada con ayuda de IA; aún no revisada por hablantes nativos.
<!-- /translation-navigation -->

<!-- translated-content -->

# Guía de montaje

Esta guía sigue el folleto impreso [SO-ARM102_assembly_A5_v0.8.pdf](../../../SO-ARM102_assembly_A5_v0.8.pdf) página por página, imprimiéndolo en A5 horizontal si prefiere papel.

Antes de empezar:

- Imprima todas las piezas de [printing.md](printing.md) y recoja el hardware de [bom.md](bom.md).
- Necesita las claves hexadecimales 1.5 mm (M2) y 2 mm (M3).
- Dos lugares en el orden actual son incómodos, consulte [Problemas conocidos](../README.md#-known-issues) para obtener más información.

> ⚠️ **El brazo líder funciona a 5 V y el brazo seguidor a 12 V.** Mantenga separadas las fuentes de alimentación.

Use un fijador de roscas desmontable compatible con el plástico impreso, como [Vibra-Tite VC-3](https://www.vibra-tite.com/faq/if-vc-3-has-mek-how-can-it-be-plastic-compatible/). Aplique VC-3 a la rosca del tornillo metálico y deje secar completamente antes del montaje (al menos 30 minutos según la [ficha técnica](https://www.vibra-tite.com/wp-content/uploads/213_tds.pdf)); no lo aplique húmedo sobre plástico. Compruebe primero la compatibilidad con su filamento en una pieza de prueba.

Herramientas y advertencia de voltaje

## Orden de trabajo

### Lectura de las ilustraciones

Los resaltados en beige indican piezas nuevas; las piezas grises ya están montadas. La miniatura de la pieza y la cantidad muestran lo que hay que añadir. El círculo numerado es el paso de montaje; los puntos indican el progreso.

### Secuencia de montaje

1. Monte los cuernos en los servomotores.
2. Construye el cuerpo del brazo robot **dos veces**, una vez para el brazo robot seguidor y otra para el brazo robot líder (pasos 1–13). En los pasos 12–13 se instala un Bus Servo Adapter en cada brazo.
3. Construya la pinza paralela (pasos de la pinza 1–6).
4. Complete el seguidor: soporte de cámara, pinza y cámara (pasos 1–3 del seguidor).
5. Complete el líder: mango y gatillo (pasos 1–2 del líder).

## Identificadores de servos

Establezca el ID de cada servomotor antes de que entre en el brazo del robot.Las herramientas para establecer los ID y calibrar están en [lab.robonine.com](https://lab.robonine.com).

Servo IDs

| ID | Articulación | Servo del seguidor | Servo del líder |
|:-:|---|---|---|
| 1 | Giro de la base | STS3235 | STS3215 |
| 2 | Elevación del hombro | STS3250 | STS3215 |
| 3 | Flexión del codo | STS3250 | STS3215 |
| 4 | Flexión de la muñeca | STS3235 | STS3215 |
| 5 | Rotación de la muñeca | STS3215 | STS3215 |
| 6 | Pinza / gatillo | STS3215 | STS3215 |

## 0. Servo bocinas

Todos los servos del líder son STS3215. En el seguidor, los ID 1 e ID 4 son STS3235, y los ID 2 e ID 3 son STS3250.

Monte un brazo de servo con un tornillo M3 × 6 del kit del servo en el servo ID 1. Los servos ID 2, 3 y 4 llevan un brazo en ambos lados. Los tornillos de los brazos vienen con los servos. Los tornillos marcados «servo kit» en un paso proceden del paquete del servo, no de la bolsa de tornillería suelta.

Si agrega juntas tóricas al brazo del robot líder, colóquelas ahora entre el servomotor y la bocina, ya que si se equivoca en este orden puede atascarse el anillo entre la carcasa del servomotor y la bocina.

## 1–13. Cuerpo del brazo: seguidor y líder

Repita estos pasos para ambos brazos del robot. Los nombres de las piezas impresas coinciden con [printing.md](printing.md).

| Paso | Piezas | Elementos de fijación |
|:-:|---|---|
| 1 | SO102.02.060 Soporte inferior del servomotor, SO102.02.040 Placa superior inferior | Tuerca 3 × M3×16, 3 × M3 |
| 2 | — | Tuerca 3 × M3×16, 3 × M3 |
| 3 | ID de servicio 1 | 4 × M2×6 |
| 4 | SO102.02.020 Anillo base, cojinete 6812, SO102.02.050 Anillo inferior, SO102.02.010 Base | Tuerca 6 × M3×16, 6 × M3 |
| 5 | SO102.02.030 Arandela de base | 4 × M3×10, 6 × M3×16 |
| 6 | Servos ID 2 e ID 3, 2 × SO102.02.070 brazo robot inferior, 2 cables cortos, 1 cable largo | 16 × M2×6 |
| 7 | Servo ID 4, SO102.02.080-01 brazo robot superior derecho, 1 cable corto | 4 × M2×6 |
| 8 | SO102.02.080 Brazo superior izquierdo | 4 × M2×6, 8 × M3×10 |
| 9 | Servo ID 5 (STS3215), SO102.02.090 Soporte de muñeca, brazo de servo | 1 × M3×6 (del kit del servo), 4 × 2×6 (del kit del servo) |
| 10 | 1 cable corto | 8 × M3×10 |
| 11 | — | 8 × M3×10 |
| 12 | SO102.02.101 Soporte de placa, Bus Servo Adapter | 4 × tuerca M2, 4 × M2×8 |
| 13 | SO102.02.101-01 Tapa de placa, 1 × cable largo | — |

| | | |
|:-:|:-:|:-:|
| Paso 1 | Paso 2 | Paso 3 |
| Paso 4 | Paso 5 | Paso 6 |
| Paso 7 | Paso 8 | Paso 9 |
| Paso 10 | Paso 11 | Paso 12 |
| Paso 13 | | |

Compruebe que cada cable del servomotor llegue a la siguiente junta con algo de holgura antes de cerrar la junta.

## Pinza 1–6, brazo robot seguidor solamente

| Paso | Piezas | Elementos de fijación |
|:-:|---|---|
| 1 | RB9.01.062.040 Engranaje para pinza en el cuerno del servomotor, ID del servomotor 6 | 4 × M3×4 tornillo de fijación, 1 × M3×6 (del kit del servo) |
| 2 | 2 × RB9.01.062.025 (D6.1) Abrazadera, 2 × RB9.01.062.030 Cremallera, 2 × RB9.01.062.100 Clavo | — |
| 3 | 2 × barra Ø6 × 125 mm | — |
| 4 | RB9.01.062.012 Marco principal (D6.1), 2 × cojinete MF106, 2 × RB9.01.062.050 Arandela | 2 × M3×10 |
| 5 | Encaje las barras en el marco principal | — |
| 6 | Empuje las abrazaderas a sus topes exteriores, inserte el servomotor | 3 × 2×6 (del kit del servo) |

El ×2 del paso 2 indica un conjunto de mordaza para cada lado. Las cantidades de la tabla son los totales.

Apriete los tornillos prisioneros desde el lado del brazo del servo hacia el engranaje, para que no quede ningún hueco entre ambos. Antes del paso 6, lleve el servo con ID 6 a su posición mínima para que la pinza se cierre por completo y se abra hasta los 85 mm. Antes de cerrar el conjunto, deslice a mano ambas mordazas por las varillas. Deben moverse libremente, sin atascarse.

| | | |
|:-:|:-:|:-:|
| Gripper 1 | Gripper 2 | Gripper 3 |
| Gripper 4 | Gripper 5 | Gripper 6 |

## Brazo robot seguidor 1–3

| Paso | Piezas | Elementos de fijación |
|:-:|---|---|
| 1 | RB9.01.062.075 Soporte de cámara | 5 × M3×10 |
| 2 | Montaje del agarrador en la muñeca | 4 × 2×6 (del kit del servo) |
| 3 | RB9.01.062.090 Espaciador de cámara, cámara USB, SO102.02.130 Clip de cable | Tuerca 4 × M2×8, 4 × M2 |

| | | |
|:-:|:-:|:-:|
| Brazo robot seguidor 1 | Brazo robot seguidor 2 | Brazo robot seguidor 3 |

## Brazo robot líder 1–2

| Paso | Piezas | Elementos de fijación |
|:-:|---|---|
| 1 | SO102 Mango, SO102 Giro de muñeca, SO102.02.130 Clip de cable, SO102 Arandela | 4 × M3×6 (del kit del servo), 1 × 2×6 (del kit del servo), 1 × M3×10 |
| 2 | SO102 Disparador, servomotor ID 6 | 4 × M3×6 (del kit del servo), 4 × 2×6 (del kit del servo) |

| | |
|:-:|:-:|
| Brazo robótico líder 1 | Brazo robótico líder 2 |

## Fijación y primera puesta en marcha

1. Sujete cada base a la mesa con dos abrazaderas en C.
2. Conecte el controlador del brazo seguidor a la fuente de 12 V y el controlador del brazo líder a la fuente de 5 V.
3. Conecta ambos controles al ordenador con USB-C.
4. Calibra ambos brazos robot y comienza la teleoperación en [lab.robonine.com](https://lab.robonine.com), o con el flujo de trabajo LeRobot SO-101.
<!-- /translated-content -->
