roboninecom/SO-ARM102/docs/i18n/fr/docs/assembly-guide.md

<!-- translation-navigation -->
[English](../../en/docs/assembly-guide.md) · [Русский](../../ru/docs/assembly-guide.md) · [Español](../../es/docs/assembly-guide.md) · [Français](assembly-guide.md) · [Deutsch](../../de/docs/assembly-guide.md) · [Português (Brasil)](../../pt-BR/docs/assembly-guide.md) · [简体中文](../../zh-CN/docs/assembly-guide.md) · [日本語](../../ja/docs/assembly-guide.md) · [हिन्दी](../../hi/docs/assembly-guide.md) · [العربية](../../ar/docs/assembly-guide.md)

[Original anglais](../../../assembly-guide.md)

[Documentation](../README.md) · [Impression](printing.md) · [Composants](bom.md) · [Montage](assembly-guide.md) · [Caractéristiques](specifications.md) · [Modèles](../models/README.md) · [Contribuer](../CONTRIBUTING.md) · [Licences](../LICENSING.md) · [Traductions](translations.md)

> Traduction intégrale du document. Les illustrations et le livret PDF original sont communs aux langues. Traduction assistée par IA, pas encore relue par des locuteurs natifs.
<!-- /translation-navigation -->

<!-- translated-content -->

# Guide de montage

Ce guide suit le livret imprimé [SO-ARM102_assembly_A5_v0.8.pdf](../../../SO-ARM102_assembly_A5_v0.8.pdf) page par page, imprimé sur A5 paysage si vous préférez du papier.

Avant de commencer :

- Imprimez toutes les pièces à partir de [printing.md](printing.md) et récupérez le matériel à partir de [bom.md](bom.md).
- Vous avez besoin des clés hexadécimales 1.5 mm (M2) et 2 mm (M3).
- Deux endroits dans l'ordre actuel sont mal placés, voir [Problèmes connus](../README.md#-known-issues) pour plus d'informations.

> ⚠️ **Le bras maître fonctionne sous 5 V, le bras suiveur sous 12 V.** Gardez leurs alimentations séparées.

Utilisez un frein-filet démontable compatible avec le plastique imprimé, par exemple [Vibra-Tite VC-3](https://www.vibra-tite.com/faq/if-vc-3-has-mek-how-can-it-be-plastic-compatible/). Appliquez VC-3 sur le filetage des vis métalliques et laissez sécher complètement avant assemblage (au moins 30 minutes selon la [fiche technique](https://www.vibra-tite.com/wp-content/uploads/213_tds.pdf)) ; ne l'appliquez pas humide sur le plastique. Vérifiez d'abord la compatibilité avec votre filament sur une pièce d'essai.

Outils et avertissement de tension

## Ordre des opérations

### Lecture des illustrations

La vignette de la pièce et la quantité indiquent ce qui doit être ajouté. Le cercle numéroté représente l'étape d'assemblage, les points indiquent le progrès. Les numéros de pièces, les tailles des fixations et les ID des servomoteurs sont identiques dans toutes les langues.

### Séquence d'assemblage

1. Montez les cornes sur les servomoteurs.
2. Construisez le corps du bras robotique **deux fois**, une fois pour le bras robotique suiveur et une fois pour le bras robotique leader (étapes 1–13). Les étapes 12–13 installent un Bus Servo Adapter sur chaque bras.
3. Construire la pince parallèle (étapes de pince 1–6).
4. Terminez le bras suiveur : support de caméra, pince et caméra (étapes 1–3 du suiveur).
5. Terminez le bras leader : poignée et gâchette (étapes 1–2 du leader).

## Identifiants des servos

Réglez l'ID de chaque servomoteur avant qu'il ne passe dans le bras du robot.Les outils pour régler les ID et calibrer sont disponibles sur [lab.robonine.com](https://lab.robonine.com).

Servo IDs

| ID | Articulation | Servo du suiveur | Servo du leader |
|:-:|---|---|---|
| 1 | Rotation de la base | STS3235 | STS3215 |
| 2 | Élévation de l’épaule | STS3250 | STS3215 |
| 3 | Flexion du coude | STS3250 | STS3215 |
| 4 | Flexion du poignet | STS3235 | STS3215 |
| 5 | Rotation du poignet | STS3215 | STS3215 |
| 6 | Pince / gâchette | STS3215 | STS3215 |

## 0. Servo klaxons

Tous les servomoteurs du leader sont des STS3215. Sur le suiveur, les ID 1 et ID 4 sont des STS3235, et les ID 2 et ID 3 sont des STS3250.

Montez un palonnier avec une vis M3 × 6 du kit du servomoteur sur le servomoteur ID 1. Les servomoteurs ID 2, 3 et 4 reçoivent un palonnier de chaque côté. Les vis des palonniers sont fournies avec les servomoteurs. Les vis marquées « servo kit » à une étape proviennent du sachet du servomoteur, pas du sachet de visserie séparé.

Si vous ajoutez des joints toriques au bras du robot leader, placez-les maintenant entre le servomoteur et la corne.Si vous ne respectez pas cet ordre, l'anneau entre la coque du servomoteur et la corne risque de se coincer.

## 1–13. Corps du bras, bras robotique suiveur et bras robotique leader

Répétez ces étapes pour les deux bras robotiques. Les noms des pièces imprimées correspondent à [printing.md](printing.md).

| Étape | Pièces | Fixations |
|:-:|---|---|
| 1 | SO102.02.060 Support de servomoteur inférieur, SO102.02.040 Plaque supérieure inférieure | Écrou 3 × M3×16, 3 × M3 |
| 2 | — | Écrou 3 × M3×16, 3 × M3 |
| 3 | Numéro de service 1 | 4 × M2×6 |
| 4 | SO102.02.020 Bague de base, roulement 6812, SO102.02.050 Anneau inférieur, SO102.02.010 Base | Écrou 6 × M3×16, 6 × M3 |
| 5 | SO102.02.030 Rondelle de base | 4 × M3×10, 6 × M3×16 |
| 6 | Servos ID 2 et ID 3, 2 × SO102.02.070 bras robot inférieur, 2 câbles courts, 1 câble long | 16 × M2×6 |
| 7 | Servo ID 4, SO102.02.080-01 bras robot supérieur droit, 1 câble court | 4 × M2×6 |
| 8 | SO102.02.080 Bras supérieur gauche | 4 × M2×6, 8 × M3×10 |
| 9 | Servomoteur ID 5 (STS3215), SO102.02.090 Support de poignet, palonnier | 1 × M3×6 (du kit du servomoteur), 4 × 2×6 (du kit du servomoteur) |
| 10 | 1 câble court | 8 × M3×10 |
| 11 | — | 8 × M3×10 |
| 12 | SO102.02.101 Support de carte, Bus Servo Adapter | 4 × écrou M2, 4 × M2×8 |
| 13 | SO102.02.101-01 Couvercle de carte, 1 × câble long | — |

| | | |
|:-:|:-:|:-:|
| Step 1 | Step 2 | Step 3 |
| Step 4 | Step 5 | Step 6 |
| Step 7 | Step 8 | Step 9 |
| Step 10 | Step 11 | Step 12 |
| Step 13 | | |

Vérifiez que chaque câble de servomoteur atteigne le prochain joint avec un certain jeu avant de fermer le joint.

## Pince 1–6, bras robotique suiveur uniquement

| Étape | Pièces | Fixations |
|:-:|---|---|
| 1 | RB9.01.062.040 Engrenage pour préhenseur sur le klaxon du servomoteur, servomoteur ID 6 | 4 × M3×4 vis de réglage, 1 × M3×6 (du kit du servomoteur) |
| 2 | Pince 2 × RB9.01.062.025 (D6.1), crémaillère 2 × RB9.01.062.030, clou 2 × RB9.01.062.100 | — |
| 3 | 2 × tige Ø6 × 125 mm | — |
| 4 | RB9.01.062.012 Cadre principal (D6.1), 2 × roulement MF106, 2 × RB9.01.062.050 Rondelle | 2 × M3×10 |
| 5 | Encliquetez les tiges dans le cadre principal | — |
| 6 | Poussez les pinces à leurs butées extérieures, insérez le servomoteur | 3 × 2×6 (du kit du servomoteur) |

Le ×2 de l’étape 2 correspond à un ensemble de mâchoire de chaque côté. Les quantités du tableau sont les totaux.

Serrez les vis de pression du côté du palonnier vers l'engrenage afin de ne laisser aucun jeu entre eux. Avant l'étape 6, placez le servo d'ID 6 en position minimale afin que la pince se ferme complètement et s'ouvre sur toute la course de 85 mm. Avant de refermer l'ensemble, faites coulisser les deux mâchoires à la main le long des tiges. Elles doivent se déplacer librement, sans coincer.

| | | |
|:-:|:-:|:-:|
| Gripper 1 | Gripper 2 | Gripper 3 |
| Gripper 4 | Gripper 5 | Gripper 6 |

## Bras robotique de suivi 1–3

| Étape | Pièces | Fixations |
|:-:|---|---|
| 1 | RB9.01.062.075 Support pour appareil photo | 5 × M3×10 |
| 2 | Montage de la pince sur le poignet | 4 × 2×6 (du kit du servomoteur) |
| 3 | RB9.01.062.090 Entretoise de caméra, caméra USB, SO102.02.130 Clip de câble | Écrou 4 × M2×8, 4 × M2 |

| | | |
|:-:|:-:|:-:|
| Suivant bras robotique 1 | Suivant bras robotique 2 | Suivant bras robotique 3 |

## Bras robotique de leader 1–2

| Étape | Pièces | Fixations |
|:-:|---|---|
| 1 | SO102 Poignée, SO102 Rotation du poignet, SO102.02.130 Clip de câble, SO102 Rondelle | 4 × M3×6 (du kit du servomoteur), 1 × 2×6 (du kit du servomoteur), 1 × M3×10 |
| 2 | SO102 Déclencheur, servomoteur ID 6 | 4 × M3×6 (du kit du servomoteur), 4 × 2×6 (du kit du servomoteur) |

| | |
|:-:|:-:|
| Leader robot arm 1 | Leader robot arm 2 |

## Fixation et première mise en service

1. Fixez chaque base à la table avec deux pinces en C.
2. Branchez le contrôleur du bras suiveur à l'alimentation de 12 V et celui du bras maître à l'alimentation de 5 V.
3. Connectez les deux manettes à l'ordinateur avec USB-C.
4. Étalonnez les deux bras du robot et démarrez la téléopération sur [lab.robonine.com](https://lab.robonine.com), ou avec le flux de travail LeRobot SO-101.
<!-- /translated-content -->
