roboninecom/SO-ARM102/docs/i18n/hi/docs/assembly-guide.md

<!-- translation-navigation -->
[English](../../en/docs/assembly-guide.md) · [Русский](../../ru/docs/assembly-guide.md) · [Español](../../es/docs/assembly-guide.md) · [Français](../../fr/docs/assembly-guide.md) · [Deutsch](../../de/docs/assembly-guide.md) · [Português (Brasil)](../../pt-BR/docs/assembly-guide.md) · [简体中文](../../zh-CN/docs/assembly-guide.md) · [日本語](../../ja/docs/assembly-guide.md) · [हिन्दी](assembly-guide.md) · [العربية](../../ar/docs/assembly-guide.md)

[अंग्रेज़ी मूल](../../../assembly-guide.md)

[दस्तावेज़](../README.md) · [प्रिंटिंग](printing.md) · [सामग्री सूची](bom.md) · [असेंबली](assembly-guide.md) · [विनिर्देश](specifications.md) · [मॉडल](../models/README.md) · [योगदान](../CONTRIBUTING.md) · [लाइसेंस](../LICENSING.md) · [अनुवाद](translations.md)

> यह दस्तावेज़ का पूर्ण अनुवाद है। चित्र और मूल PDF पुस्तिका सभी भाषाओं में साझा हैं। अनुवाद AI की सहायता से तैयार किया गया है; मूल भाषा बोलने वालों ने अभी इसकी समीक्षा नहीं की है।
<!-- /translation-navigation -->

<!-- translated-content -->

# असेंबली मार्गदर्शिका

यह मार्गदर्शक मुद्रित पुस्तिका [SO-ARM102_assembly_A5_v0.8.pdf](../../../SO-ARM102_assembly_A5_v0.8.pdf) के पृष्ठ से पृष्ठ का अनुसरण करता है. यदि आप कागज पसंद करते हैं तो पुस्तक को A5 लैंडस्केप पर छापें.

शुरू करने से पहले:

- [printing.md](printing.md) से सभी भागों को छापें और [bom.md](bom.md) से हार्डवेयर इकट्ठा करें.
- आपको हेक्स कुंजी 1.5 mm (M2) तथा 2 mm (M3) की आवश्यकता है.
- कुछ भी कसने से पहले दो कदम आगे पढ़ें. मौजूदा क्रम में दो स्थान असुविधाजनक हैं, देखें [Known issues](../README.md#-known-issues).

> ⚠️ **लीडर आर्म 5 V पर और फॉलोअर आर्म 12 V पर चलता है।** दोनों की बिजली आपूर्ति अलग रखें।

प्रिंट किए प्लास्टिक के अनुकूल, खोलने योग्य थ्रेडलॉकर इस्तेमाल करें, जैसे [Vibra-Tite VC-3](https://www.vibra-tite.com/faq/if-vc-3-has-mek-how-can-it-be-plastic-compatible/)। VC-3 धातु के स्क्रू की चूड़ियों पर लगाएँ और असेंबली से पहले पूरी तरह सूखने दें ([तकनीकी पत्रक](https://www.vibra-tite.com/wp-content/uploads/213_tds.pdf) के अनुसार कम से कम 30 मिनट); गीला पदार्थ प्लास्टिक पर न लगाएँ। पहले उसी फिलामेंट के परीक्षण प्रिंट पर अनुकूलता जाँचें।

उपकरण और वोल्टेज चेतावनी

## काम का क्रम

### चित्र पढ़ रहे

नए भागों के लिए बेज रंग का उभार है; भूरे रंग के भाग पहले से ही इकट्ठे हो चुके हैं. भाग लघुछवि तथा मात्रा बताती है कि क्या जोड़ना है. संख्यायुक्त वृत्त एकत्रीकरण चरण है; बिंदु प्रगति दर्शाता है. प्रत्येक भाषा में भाग संख्या, फिक्सिंग आकार तथा सर्वोमोटर पहचान एक ही होती है.

### एसेम्बलिंग अनुक्रम

1. सर्वोमोटर पर हॉर्न माउंट.
2.  रोबोट आर्म का शरीर **दो बार** बनाएं, एक बार अनुयायी रोबोट आर्म के लिए और एक बार नेता रोबोट आर्म (चरण 1–13) के लिए। चरण 12–13 में प्रत्येक आर्म पर एक Bus Servo Adapter लगाएँ।
3. समानांतर ग्रिपर बनाएँ (ग्रिपर चरण 1-6)
4. फॉलोअर पूरा करें: कैमरा होल्डर, ग्रिपर और कैमरा (फॉलोअर के चरण 1–3)।
5. लीडर पूरा करें: हैंडल और ट्रिगर (लीडर के चरण 1–2)।

## सर्वो ID

प्रत्येक सर्वोमोटर आईडी सेट करें इससे पहले कि यह रोबोट आर्म में जाए. आईडी सेट करने के लिए औजार और कैलिब्रेशन [lab.robonine.com](https://lab.robonine.com) पर है.

सर्वर आईडी

| ID | जोड़ | फ़ॉलोअर सर्वो | लीडर सर्वो |
|:-:|---|---|---|
| 1 | आधार का घुमाव | STS3235 | STS3215 |
| 2 | कंधा उठाना | STS3250 | STS3215 |
| 3 | कोहनी मोड़ना | STS3250 | STS3215 |
| 4 | कलाई मोड़ना | STS3235 | STS3215 |
| 5 | कलाई घुमाना | STS3215 | STS3215 |
| 6 | ग्रिपर / ट्रिगर | STS3215 | STS3215 |

## 0. सर्वो हॉर्न

लीडर के सभी सर्वो STS3215 हैं। फॉलोअर में ID 1 और ID 4 पर STS3235 तथा ID 2 और ID 3 पर STS3250 हैं।

सर्वो ID 1 पर सर्वो किट के M3 × 6 स्क्रू से एक हॉर्न लगाएँ। सर्वो ID 2, 3 और 4 पर दोनों ओर हॉर्न लगाएँ। हॉर्न के स्क्रू सर्वो के साथ आते हैं। किसी चरण में “servo kit” चिह्नित स्क्रू सर्वो की पैकिंग से लें, अलग फास्टनर बैग से नहीं।

अगर आप नेता रोबोट के हाथ में ओ-रिंग जोड़ते है तो उन्हें सर्वोमोटर और हॉर्न के बीच रख दें. इस क्रम को गलत करने से सर्वोमोटर शेल और हॉर्न के बीच रिंग जमी जा सकती है.

## 1–13. आर्म बॉडी, फॉलोवर रोबोट आर्म तथा लीडर रोबोट आर्म

दोनों रोबोट हाथों के लिए इन चरणों को दोहराएँ. प्रिंट किए गए भागों के नाम [printing.md](printing.md) से मेल खाते हैं।

| चरण | पुर्ज़े | फ़ास्टनर |
|:-:|---|---|
| 1 | SO102.02.060 निचला सर्वोमोटर होल्डर, SO102.02.040 निचला शीर्ष प्लेट | 3 × M3×16, 3 × M3 नट |
| 2 | — | 3 × M3×16, 3 × M3 नट |
| 3 | सेवा ID 1 | 4 × M2×6 |
| 4 | SO102.02.020 आधार रिंग, बेयरिंग 6812, SO102.02.050 निचला रिंग, SO102.02.010 आधार | 6 × M3×16, 6 × M3 नट |
| 5 | SO102.02.030 बेस वॉशर | 4 × M3×10, 6 × M3×16 |
| 6 | सर्वो ID 2 तथा ID 3, 2 × SO102.02.070 निचला रोबोट आर्म, 2 छोटे केबल, 1 लंबे केबल | 16 × M2×6 |
| 7 | सर्वो ID 4, SO102.02.080-01 ऊपरी रोबोट हाथ दायाँ, 1 छोटा केबल | 4 × M2×6 |
| 8 | SO102.02.080 बायाँ ऊपरी आर्म | 4 × M2×6, 8 × M3×10 |
| 9 | सर्वो ID 5 (STS3215), SO102.02.090 कलाई होल्डर, सर्वो हॉर्न | 1 × M3×6 (सर्वो किट से), 4 × 2×6 (सर्वो किट से) |
| 10 | 1 छोटा केबल | 8 × M3×10 |
| 11 | — | 8 × M3×10 |
| 12 | SO102.02.101 बोर्ड होल्डर, Bus Servo Adapter | 4 × M2 नट, 4 × M2×8 |
| 13 | SO102.02.101-01 बोर्ड कवर, 1 × लंबा तार | — |

| | | |
|:-:|:-:|:-:|
| चरण 1 | चरण 2 | चरण 3 |
| चरण 4 | चरण 5 | चरण 6 |
| चरण 7 | चरण 8 | चरण 9 |
| चरण 10 | चरण 11 | चरण 12 |
| चरण 13 | | |

 यह सुनिश्चित करें कि प्रत्येक सर्वोमोटर केबल अगले जोड़े तक कुछ लचीलापन के साथ पहुंचता है, जब आप जोड़े को बंद करते हैं।

## ग्रिपर 1–6, केवल अनुवर्ती रोबोट हाथ

| चरण | पुर्ज़े | फ़ास्टनर |
|:-:|---|---|
| 1 | RB9.01.062.040 सर्वोमोटर हॉर्न पर ग्रिपर के लिए गियर, सर्वोमोटर ID 6 | 4 × M3×4 सेट स्क्रू, 1 × M3×6 (सर्वो किट से) |
| 2 | 2 × RB9.01.062.025 (D6.1) क्लैंप, 2 × RB9.01.062.030 गियर रैक, 2 × RB9.01.062.100 nail | — |
| 3 | 2 × रूट Ø6 × 125 mm | — |
| 4 | RB9.01.062.012 मुख्य फ्रेम (D6.1), 2 × बेयरिंग MF106, 2 × RB9.01.062.050 वॉशर | 2 × M3×10 |
| 5 | मुख्य फ्रेम में पट्टियों को स्नैप करें | — |
| 6 | अपने बाहरी बंद करने के लिए क्लैम्प धक्का, सर्वोमोटर डाल | 3 × 2×6 (सर्वो किट से) |

चरण 2 में ×2 का अर्थ है प्रत्येक तरफ एक जॉ असेंबली। तालिका में कुल मात्राएँ दी गई हैं।

सेट स्क्रू को सर्वो हॉर्न की तरफ से गियर की ओर कसें, ताकि दोनों के बीच कोई अंतर न रहे। चरण 6 से पहले ID 6 वाले सर्वो को उसकी न्यूनतम स्थिति में ले जाएँ, ताकि ग्रिपर पूरी तरह बंद हो और पूरे 85 mm तक खुल सके। असेंबली बंद करने से पहले दोनों क्लैंप को हाथ से छड़ों पर सरकाएँ। उन्हें बिना अटके आसानी से चलना चाहिए।

| | | |
|:-:|:-:|:-:|
| 1 ग्रिपर | 2 ग्रिपर | 3 ग्रिपर |
| 4 ग्रिपर | 5 ग्रिपर | 6 ग्रिपर |

## फॉलोअर रोबोट आर्म 1–3

| चरण | पुर्ज़े | फ़ास्टनर |
|:-:|---|---|
| 1 | RB9.01.062.075 कैमरा धारक | 5 × M3×10 |
| 2 | कलाई पर ग्रिपर असेंबली | 4 × 2×6 (सर्वो किट से) |
| 3 | RB9.01.062.090 कैमरा स्पेसर, USB कैमरा, SO102.02.130 केबल क्लिप | 4 × M2×8, 4 × M2 नट |

| | | |
|:-:|:-:|:-:|
| Follower रोबोट आर्म 1 | Follower रोबोट आर्म 2 | Follower रोबोट आर्म 3 |

## नेता रोबोट हाथ 1–2

| चरण | पुर्ज़े | फ़ास्टनर |
|:-:|---|---|
| 1 | SO102 हैंडल, SO102 कलाई घुमाव भाग, SO102.02.130 केबल क्लिप, SO102 वॉशर | 4 × M3×6 (सर्वो किट से), 1 × 2×6 (सर्वो किट से), 1 × M3×10 |
| 2 | SO102 ट्रिगर, सर्वो मोटर ID 6 | 4 × M3×6 (सर्वो किट से), 4 × 2×6 (सर्वो किट से) |

| | |
|:-:|:-:|
| लीडर रोबोट आर्म 1 | लीडर रोबोट आर्म 2 |

## माउंटिंग और पहली शुरुआत

1.  प्रत्येक आधार को दो सी-क्लैम्प्स के साथ टेबल पर क्लैंप करें।
2. फॉलोअर के नियंत्रक को 12 V की बिजली आपूर्ति से और लीडर के नियंत्रक को 5 V की बिजली आपूर्ति से जोड़ें।
3. दोनों नियंत्रकों को USB-C के साथ कम्प्यूटर से जोड़ें.
4. दोनों रोबोट हाथों को कैलिब्रेट करें और [lab.robonine.com](https://lab.robonine.com) पर दूरसंचार प्रारंभ करें, या LeRobot SO-101 कार्यप्रवाह के साथ.
<!-- /translated-content -->
