roboninecom/SO-ARM102/docs/i18n/ja/docs/assembly-guide.md

<!-- translation-navigation -->
[English](../../en/docs/assembly-guide.md) · [Русский](../../ru/docs/assembly-guide.md) · [Español](../../es/docs/assembly-guide.md) · [Français](../../fr/docs/assembly-guide.md) · [Deutsch](../../de/docs/assembly-guide.md) · [Português (Brasil)](../../pt-BR/docs/assembly-guide.md) · [简体中文](../../zh-CN/docs/assembly-guide.md) · [日本語](assembly-guide.md) · [हिन्दी](../../hi/docs/assembly-guide.md) · [العربية](../../ar/docs/assembly-guide.md)

[英語原文](../../../assembly-guide.md)

[ドキュメント](../README.md) · [印刷](printing.md) · [部品表](bom.md) · [組立](assembly-guide.md) · [仕様](specifications.md) · [モデル](../models/README.md) · [貢献方法](../CONTRIBUTING.md) · [ライセンス](../LICENSING.md) · [翻訳](translations.md)

> この文書の全文翻訳です。図と元のPDF冊子は各言語で共用します。AIを使用した翻訳であり、母語話者による確認は未実施です。
<!-- /translation-navigation -->

<!-- translated-content -->

# 組立ガイド

このガイドは、印刷されたブックレット [SO-ARM102_assembly_A5_v0.8.pdf](../../../SO-ARM102_assembly_A5_v0.8.pdf) をページごとに追従します。紙が好きな場合は、ブックレットを A5横長で印刷してください。

作業を始める前に：

- [printing.md](printing.md)からすべての部品を印刷し、[bom.md](bom.md)からハードウェアを集める。
- ヘキサデシマルキー 1.5 mm (M2) と 2 mm (M3) が必要です。
- 何かを締め付ける前に2段階先読みしてください。現在の順序で2つの場所が不都合です。[既知の問題](../README.md#-known-issues)を参照してください。

> ⚠️ **リーダーアームは 5 V、フォロワーアームは 12 V で動作します。** それぞれの電源を分けて管理してください。

印刷した樹脂に適合する取り外し可能なねじロック剤（例：[Vibra-Tite VC-3](https://www.vibra-tite.com/faq/if-vc-3-has-mek-how-can-it-be-plastic-compatible/)）を使用してください。VC-3 は金属ねじのねじ部に塗布し、組立前に完全に乾燥させます（[技術資料](https://www.vibra-tite.com/wp-content/uploads/213_tds.pdf)では最低 30 分）。未乾燥の状態で樹脂に塗布しないでください。まず同じフィラメントの試作品で適合性を確認してください。

ツールと電圧警告

## 作業順序

### 絵を読む

ベージュ色のハイライトが新しい部品を示し、グレー色は既に組み立てられた部品です。部品サムネイルと数量は追加するものを示します。番号付き円は組み立てステップであり、点は進行状況を示しています。部品番号、ファスナーサイズ、サーボモーター ID は言語ごとに同じです。

### 組み立てシーケンス

1. サーボモーターにホーンを取り付ける
2. アーム本体を**2回**組み立てます。フォロワー用とリーダー用にそれぞれ1回です（手順 1–13）。 手順 12–13 で各アームに Bus Servo Adapter を取り付けます。
3. パラレルグリップを構築する（グリップステップ 1-6）。
4. フォロワーを仕上げます：カメラホルダー、グリッパー、カメラ（フォロワーの手順 1–3）。
5. リーダーを仕上げます：ハンドルとトリガー（リーダーの手順 1–2）。

## サーボID

ロボットアームに入る前に各サーボモーターの ID を設定します。ID の設定とキャリブレーションツールは [lab.robonine.com](https://lab.robonine.com)で利用できます。

サーボ ID の割り当て

| ID | 関節 | フォロワーのサーボ | リーダーのサーボ |
|:-:|---|---|---|
| 1 | ベース回転 | STS3235 | STS3215 |
| 2 | 肩の上下動 | STS3250 | STS3215 |
| 3 | 肘の屈曲 | STS3250 | STS3215 |
| 4 | 手首の屈曲 | STS3235 | STS3215 |
| 5 | 手首の回転 | STS3215 | STS3215 |
| 6 | グリッパー / トリガー | STS3215 | STS3215 |

## 0. サーボホーン

リーダーのサーボはすべて STS3215 です。フォロワーでは ID 1 と ID 4 が STS3235、ID 2 と ID 3 が STS3250 です。

サーボ ID 1 に、サーボ付属の M3 × 6 ねじでホーンを一つ取り付けます。サーボ ID 2、3、4 には両側にホーンを取り付けます。ホーン用ねじはサーボに付属しています。手順で「servo kit」と表示されたねじは、別袋の締結部品ではなくサーボの包装から取り出してください。

リーダーロボットアームにＯリングを付ける場合は、サーボモーターとホーンの間に置く。この順序が間違えば、サーボモーターシェルとホーンの間のリングがジャンプする可能性があります。

## 1–13アームボディ，フォロワーロボットアーム，リーダロボットアームについて述べた。

両方のロボットアームに対してこれらのステップを繰り返す。 印刷部品の名前は [printing.md](printing.md) と一致します。

| 手順 | 部品 | 締結部品 |
|:-:|---|---|
| 1 | SO102.02.060 下サーボモーターホルダー,SO102.02.040 下トッププレート | 3 × M3×16, 3 × M3 ナット |
| 2 | — | 3 × M3×16, 3 × M3 ナット |
| 3 | サーバ ID 1 | 4 × M2×6 |
| 4 | SO102.02.020 ベースリング、ベアリング 6812、SO102.02.050 ボトムリング、SO102.02.010 ベース | 6 × M3×16, 6 × M3 ナット |
| 5 | SO102.02.030 ベースワッシャー | 4 × M3×10, 6 × M3×16 |
| 6 | サーボID 2 と ID 3、2 × SO102.02.070 ボトムロボットアーム、2短いケーブル、1長いケーブル | 16 × M2×6 |
| 7 | サーボID 4、SO102.02.080-01上部ロボットアーム右、1短いケーブル | 4 × M2×6 |
| 8 | SO102.02.080 左上腕 | 4 × M2×6, 8 × M3×10 |
| 9 | サーボ ID 5 (STS3215)、SO102.02.090 手首ホルダー、サーボホーン | 1 × M3×6 (サーボ付属), 4 × 2×6 (サーボ付属) |
| 10 | 1 短いケーブル | 8 × M3×10 |
| 11 | — | 8 × M3×10 |
| 12 | SO102.02.101 基板ホルダー, Bus Servo Adapter | 4 × M2 ナット, 4 × M2×8 |
| 13 | SO102.02.101-01 基板カバー, 1 × 長いケーブル | — |

| | | |
|:-:|:-:|:-:|
| 手順 1 | 手順 2 | 手順 3 |
| 手順 4 | 手順 5 | 手順 6 |
| 手順 7 | 手順 8 | 手順 9 |
| 手順 10 | 手順 11 | 手順 12 |
| 手順 13 | | |

サーボモータのケーブルが次のジョイントに到達する前に，ジョイントを閉じる前に少しずつゆるみを持って確認した。

## グリップ 1-6、フォローロボットアームのみ

| 手順 | 部品 | 締結部品 |
|:-:|---|---|
| 1 | RB9.01.062.040 サーボモータホーンのグリップ用ギヤ、サーボモータID6 | 4 × M3×4 セットネジ、1 × M3×6 (サーボ付属) |
| 2 | 2 × RB9.01.062.025 (D6.1) クランプ、2 × RB9.01.062.030 ギアラック、2 × RB9.01.062.100 釘 | — |
| 3 | 2 × 棒 Ø6 × 125 mm | — |
| 4 | RB9.01.062.012 メインフレーム (D6.1), 2 × ベアリング MF106, 2 × RB9.01.062.050 ワッシャー | 2 × M3×10 |
| 5 | ロッドをメインフレームにスナップ | — |
| 6 | クランプを外側の止め具に押し込み サーボモーターを挿入 | 3 × 2×6 (サーボ付属) |

手順 2 の ×2 は、左右にそれぞれ一組のジョーを組み立てることを示します。表の数量は合計です。

ホーン側からギアに向かって止めねじを締め、両者の間に隙間ができないようにします。手順 6 の前に、ID 6 のサーボを最小位置に動かし、グリッパーが完全に閉じて最大 85 mm まで開くようにします。組み付けを閉じる前に、両方のクランプを手でロッドに沿って動かしてください。引っ掛かりなく自由に動くことを確認します。

| | | |
|:-:|:-:|:-:|
| グリッパーの手順 1 | グリッパーの手順 2 | グリッパーの手順 3 |
| グリッパーの手順 4 | グリッパーの手順 5 | グリッパーの手順 6 |

## フォローアーム 1–3

| 手順 | 部品 | 締結部品 |
|:-:|---|---|
| 1 | RB9.01.062.075 カメラホルダー | 5 × M3×10 |
| 2 | 手首にグリップを取り付ける | 4 × 2×6 (サーボ付属) |
| 3 | RB9.01.062.090 カメラスペーサー、USBカメラ, SO102.02.130 ケーブルクリップ | 4 × M2×8, 4 × M2 ナット |

| | | |
|:-:|:-:|:-:|
| フォロワーの手順 1 | フォロワーの手順 2 | フォロワーの手順 3 |

## リーダーロボットアーム 1–2

| 手順 | 部品 | 締結部品 |
|:-:|---|---|
| 1 | SO102 ハンドル、SO102 手首回転部、SO102.02.130 ケーブルクリップ、SO102 ワッシャー | 4 × M3×6 (サーボ付属), 1 × 2×6 (サーボ付属), 1 × M3×10 |
| 2 | SO102 トリガー、サーボモーター ID 6 | 4 × M3×6 (サーボ付属), 4 × 2×6 (サーボ付属) |

| | |
|:-:|:-:|
| リーダーの手順 1 | リーダーの手順 2 |

## 固定と初回起動

1. 2つのCクランプでテーブルに固定する
2. フォロワー側のコントローラーを 12 V 電源に、リーダー側のコントローラーを 5 V 電源に接続してください。
3. USB-Cで両方のコントローラをコンピュータに接続します。
4. 両方のロボットアームを調整し 遠隔操作を開始 [lab.robonine.com](https://lab.robonine.com)あるいは LeRobot SO-101 workflow.
<!-- /translated-content -->
