roboninecom/SO-ARM102/docs/SO-ARM102_assembly_A5_v0.8.pdf

# SO-ARM102

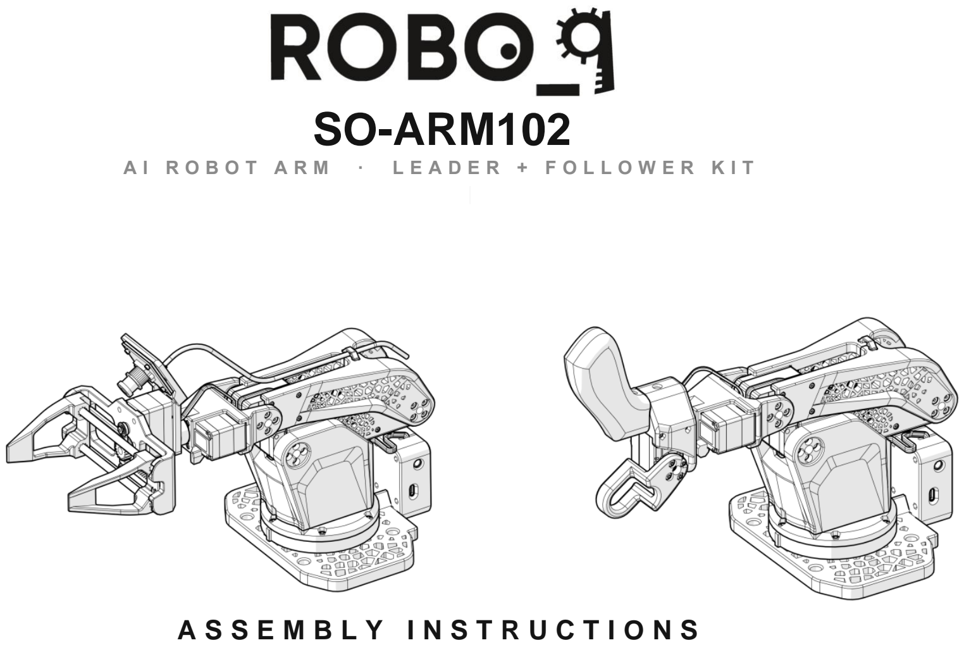
[picture p34: page 1]

A I R O B O T A R M | · | L E A D E R + F O L L O W E R K I T

## A S S E M B L Y I N S T R U C T I O N S

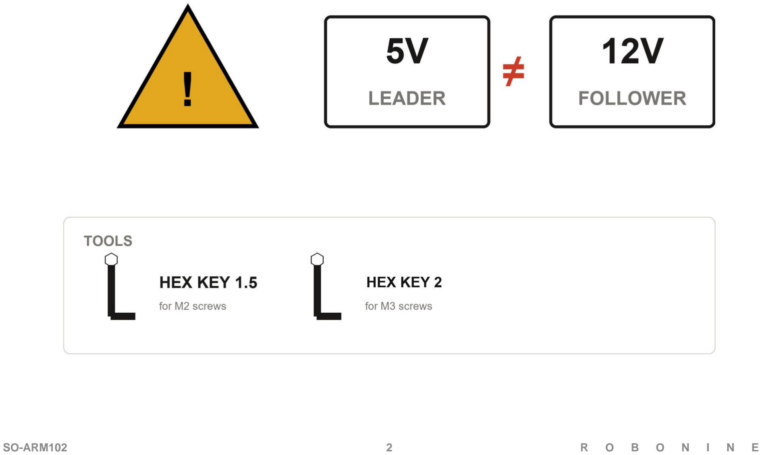
[picture p35: page 2]

SO-ARM102 | 2 | R | O | B | O | N | I | N | E

## 3D PRINTED PARTS

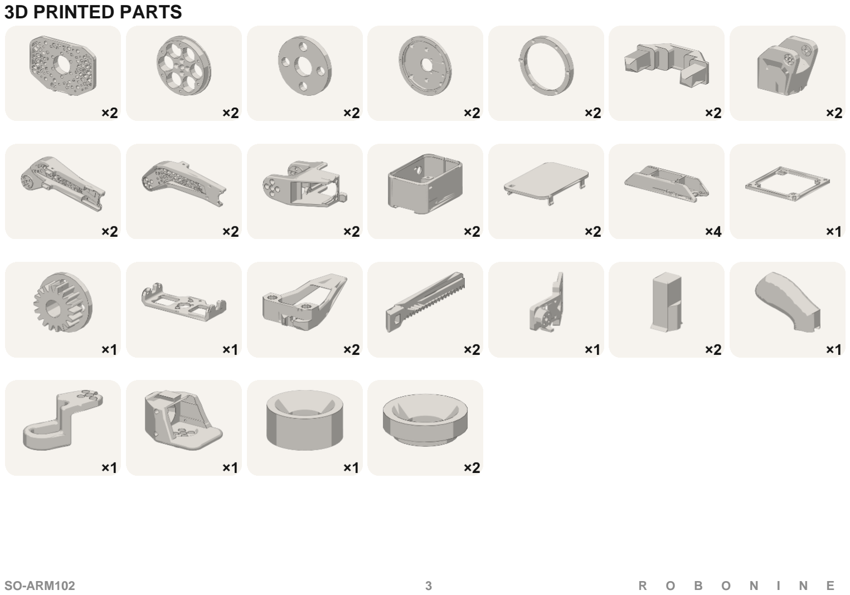
[picture p36: page 3]

SO-ARM102 | 3 | R | O | B | O | N | I | N | E

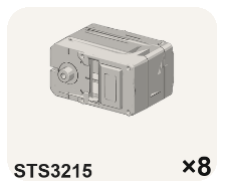
[picture p37: figure]
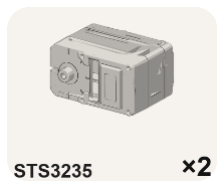
[picture p38: figure]
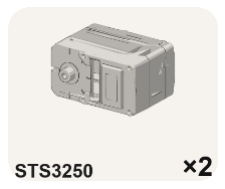
[picture p39: figure]
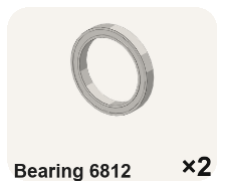
[picture p40: figure]
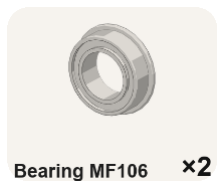
[picture p41: figure]
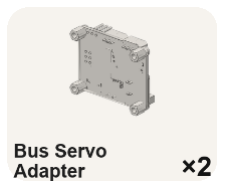
[picture p42: figure]
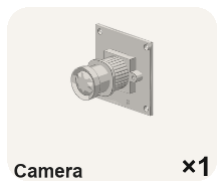
[picture p43: figure]
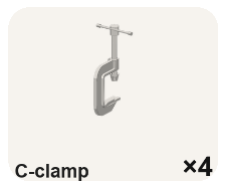
[picture p44: figure]
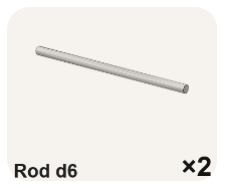
[picture p45: figure]

SO-ARM102 | 4 | R | O | B | O | N | I | N | E

## HARDWARE

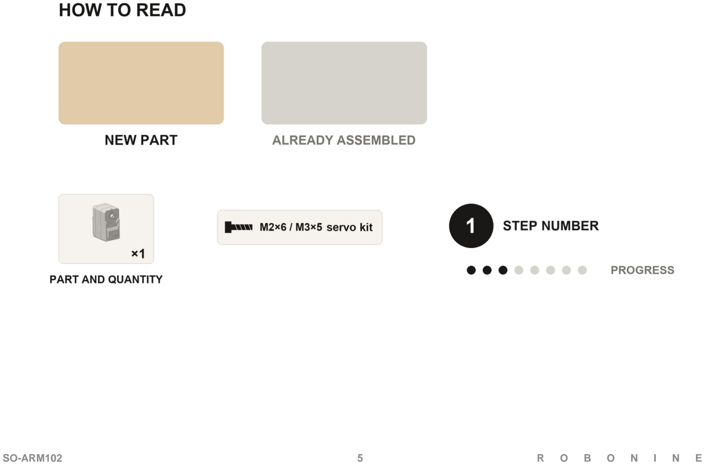
[picture p46: page 5]

SO-ARM102 | 5 | R | O | B | O | N | I | N | E

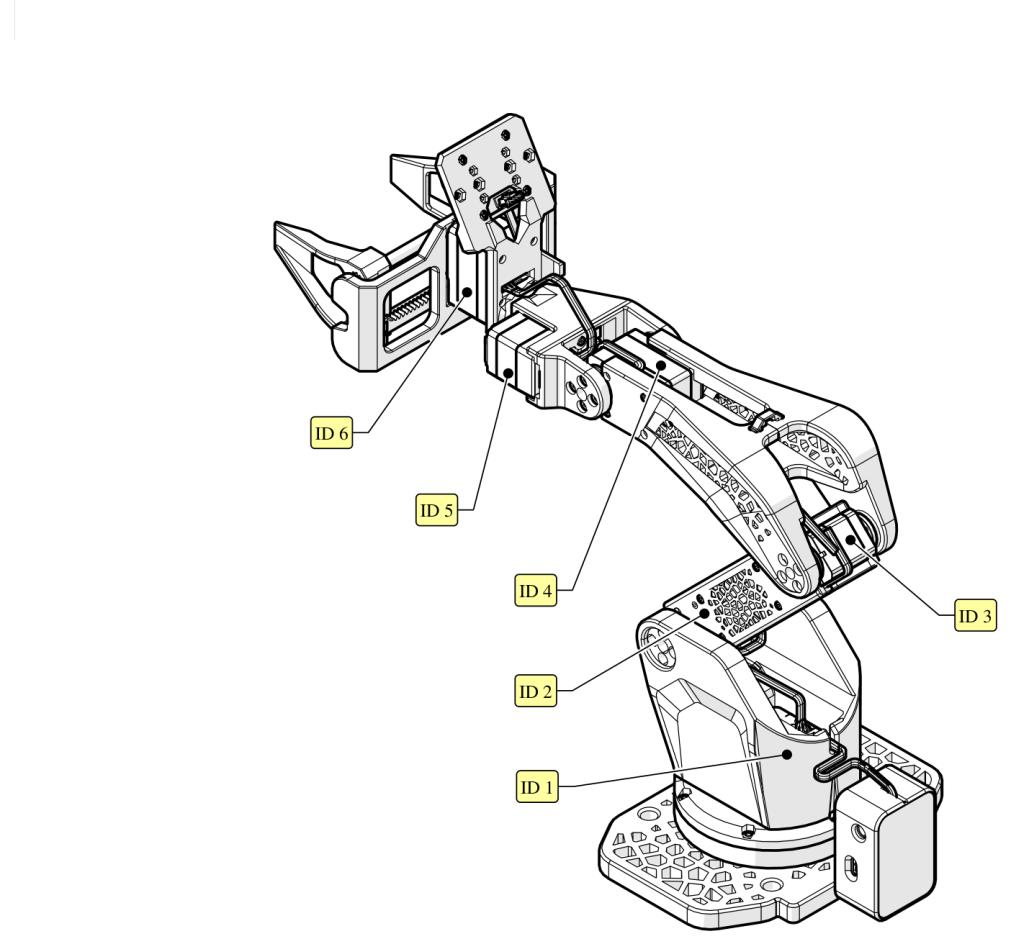
[picture p47: figure]

SO-ARM102 | 6 | R | O | B | O | N | I | N | E

# ALL LEADER SERVOS ARE STS3215 FOLLOWER SERVO ID 1 (STS3235) ID 2, ID 3 (STS3250), ID 4 (STS3235)

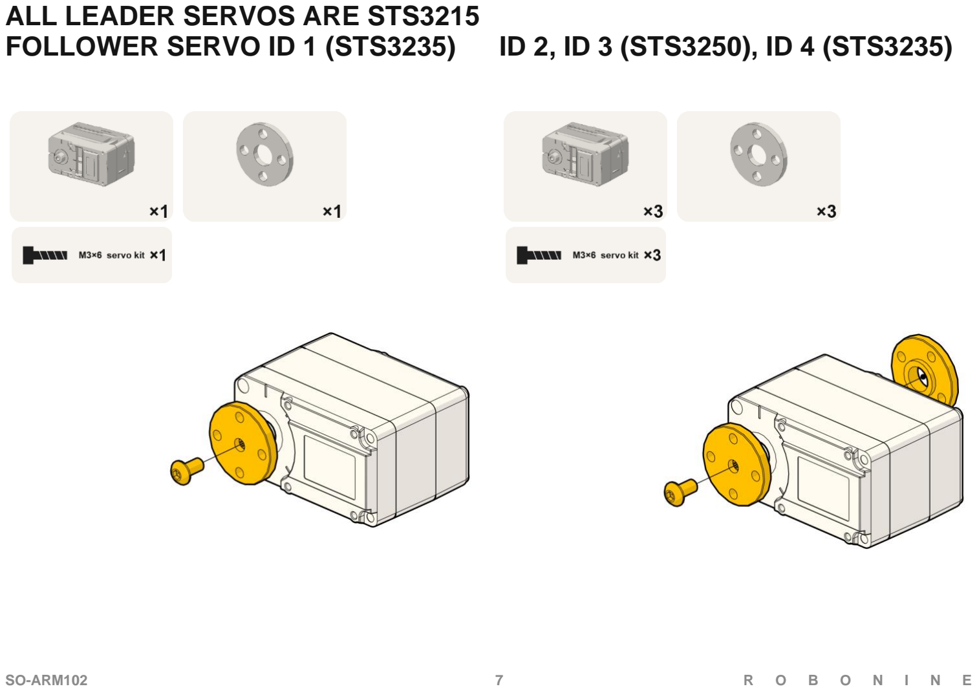
[picture p48: page 7]

SO-ARM102 | 7 | R | O | B | O | N | I | N | E

## FOLLOWER & LEADER

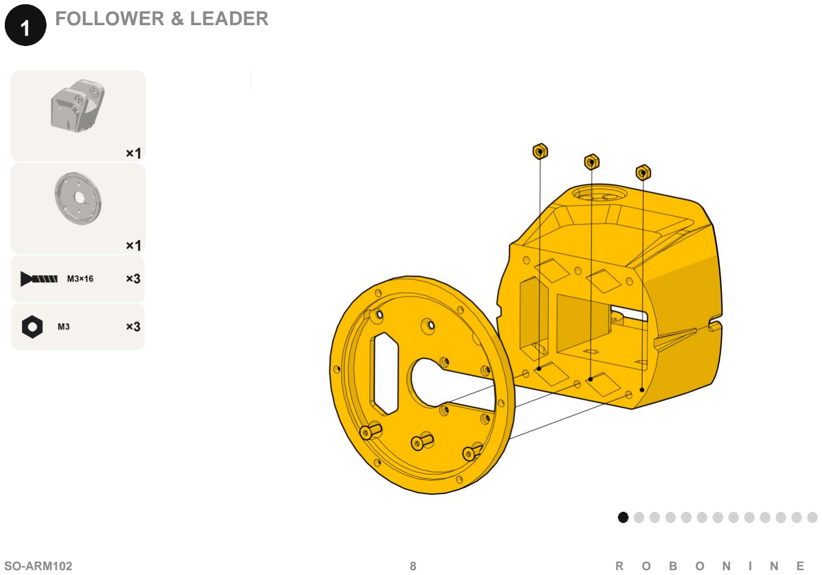
[picture p49: page 8]

SO-ARM102 | 8 | R | O | B | O | N | I | N | E

## FOLLOWER & LEADER

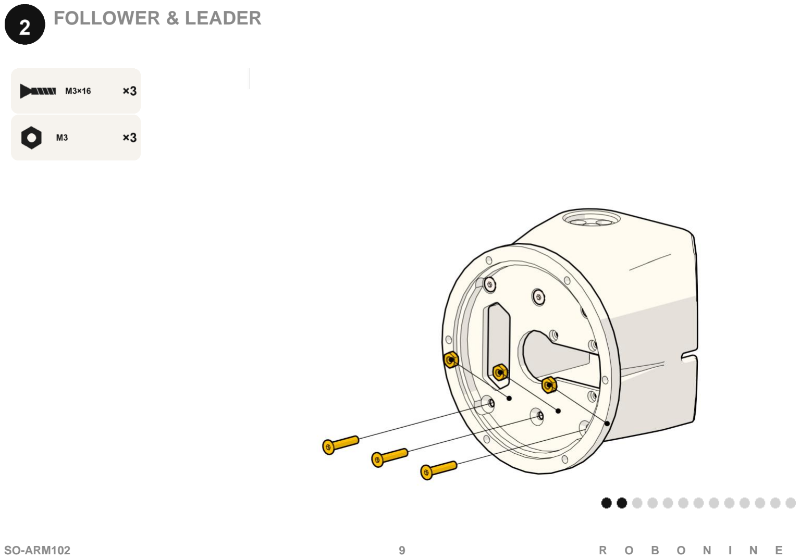
[picture p50: page 9]

SO-ARM102 | 9 | R | O | B | O | N | I | N | E

## FOLLOWER & LEADER

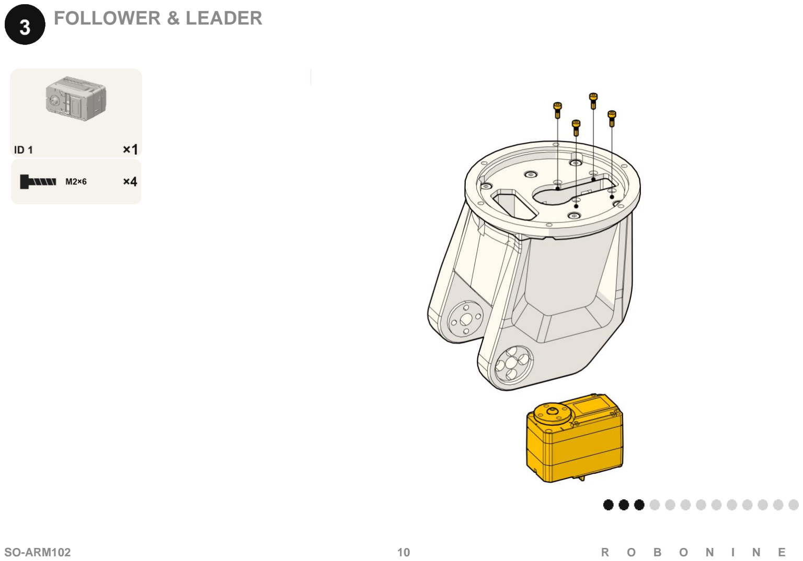
[picture p51: page 10]

SO-ARM102 | 10 | R | O | B | O | N | I | N | E

## FOLLOWER & LEADER

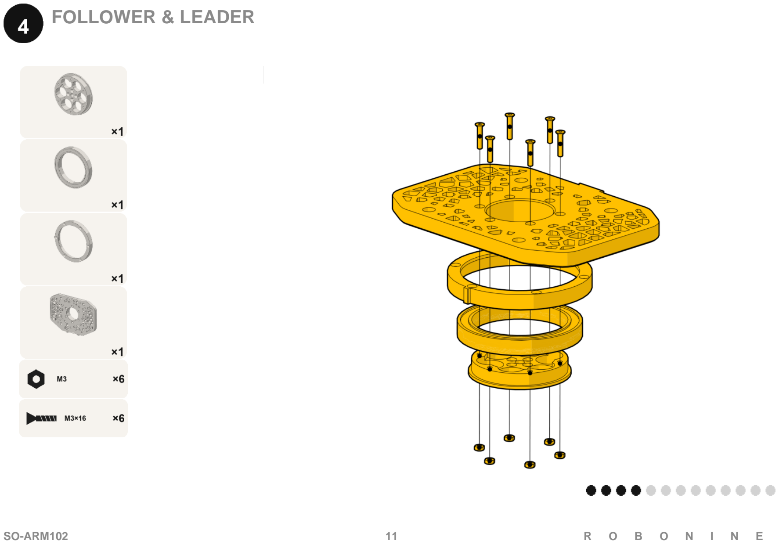
[picture p52: page 11]

SO-ARM102 | 11 | R | O | B | O | N | I | N | E

## FOLLOWER & LEADER

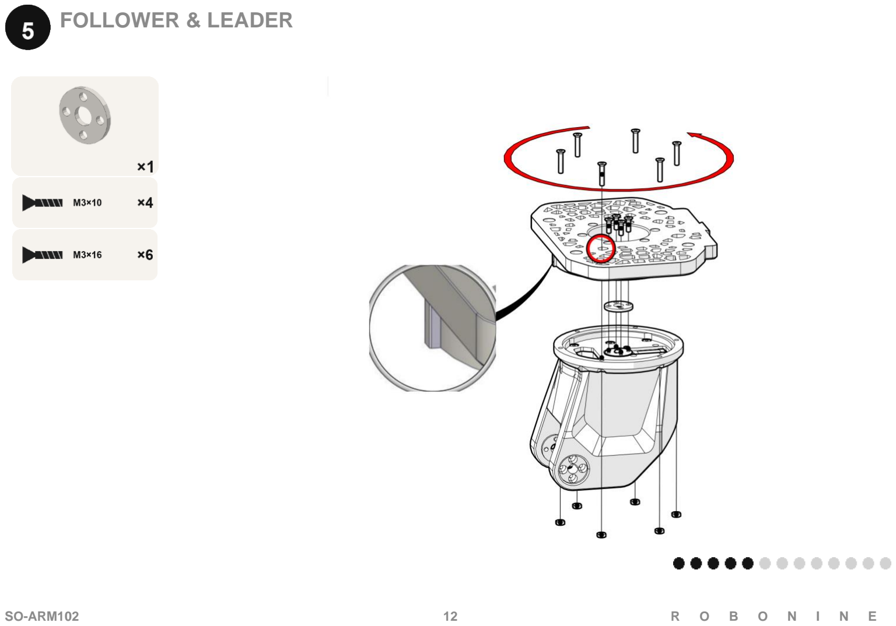
[picture p53: page 12]

SO-ARM102 | 12 | R | O | B | O | N | I | N | E

## FOLLOWER & LEADER

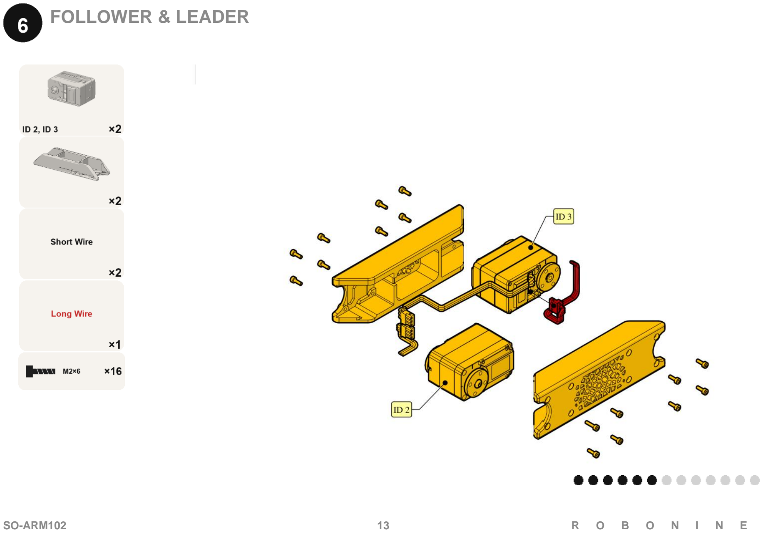
[picture p54: page 13]

SO-ARM102 | 13 | R | O | B | O | N | I | N | E

## FOLLOWER & LEADER

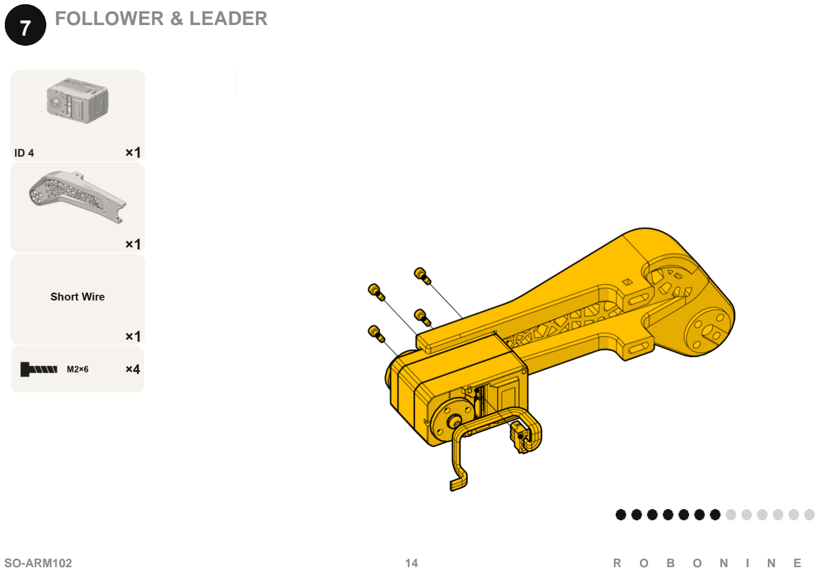
[picture p55: page 14]

SO-ARM102 | 14 | R | O | B | O | N | I | N | E

## FOLLOWER & LEADER

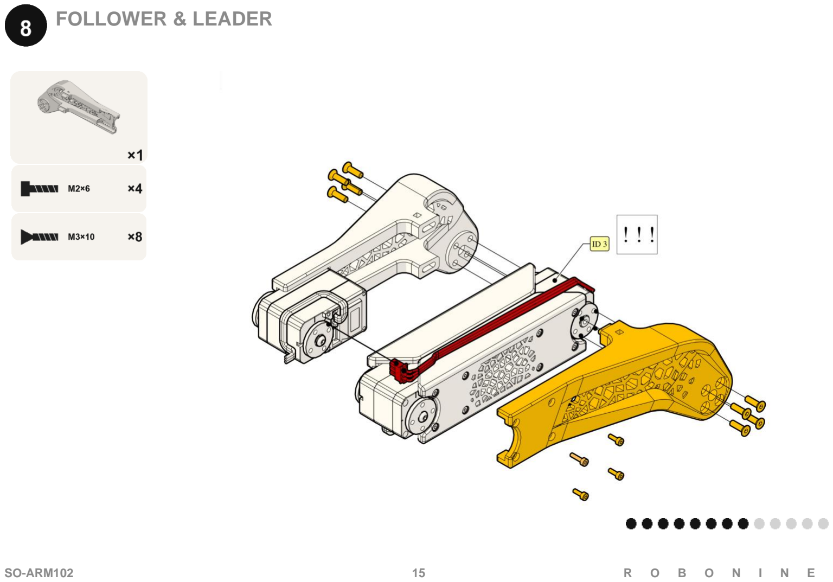
[picture p56: page 15]

SO-ARM102 | 15 | R | O | B | O | N | I | N | E

## FOLLOWER & LEADER

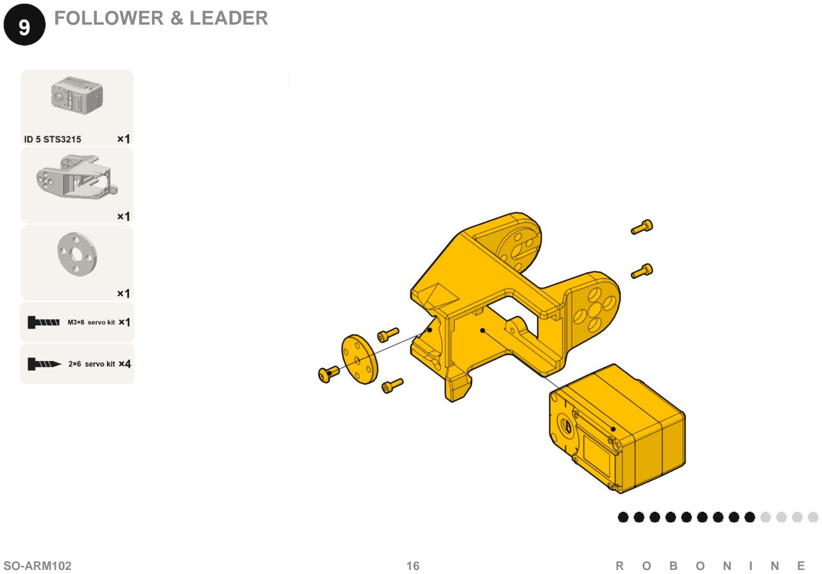
[picture p57: page 16]

SO-ARM102 | 16 | R | O | B | O | N | I | N | E

## FOLLOWER & LEADER

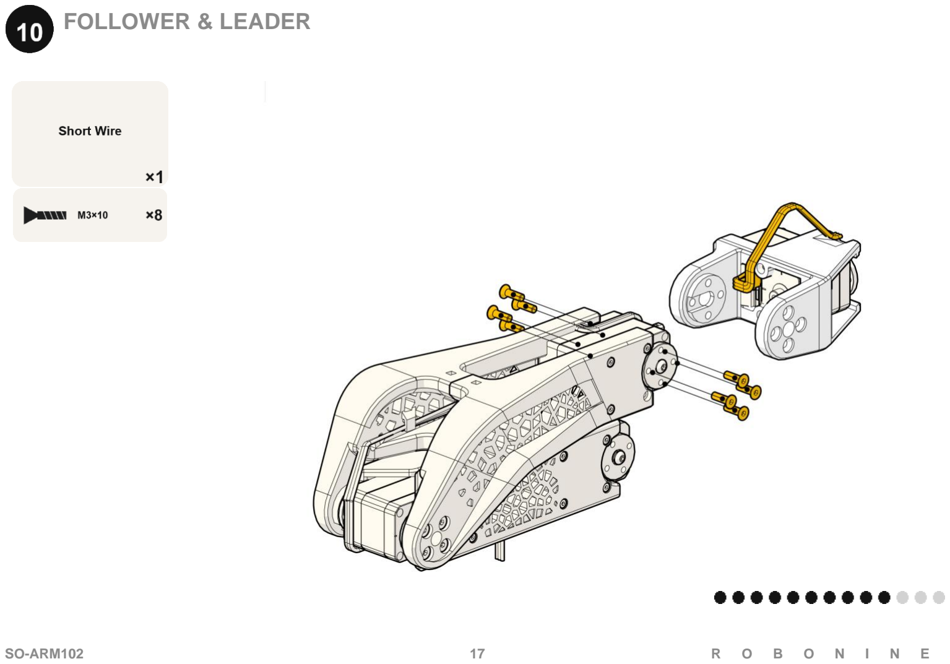
[picture p58: page 17]

SO-ARM102 | 17 | R | O | B | O | N | I | N | E

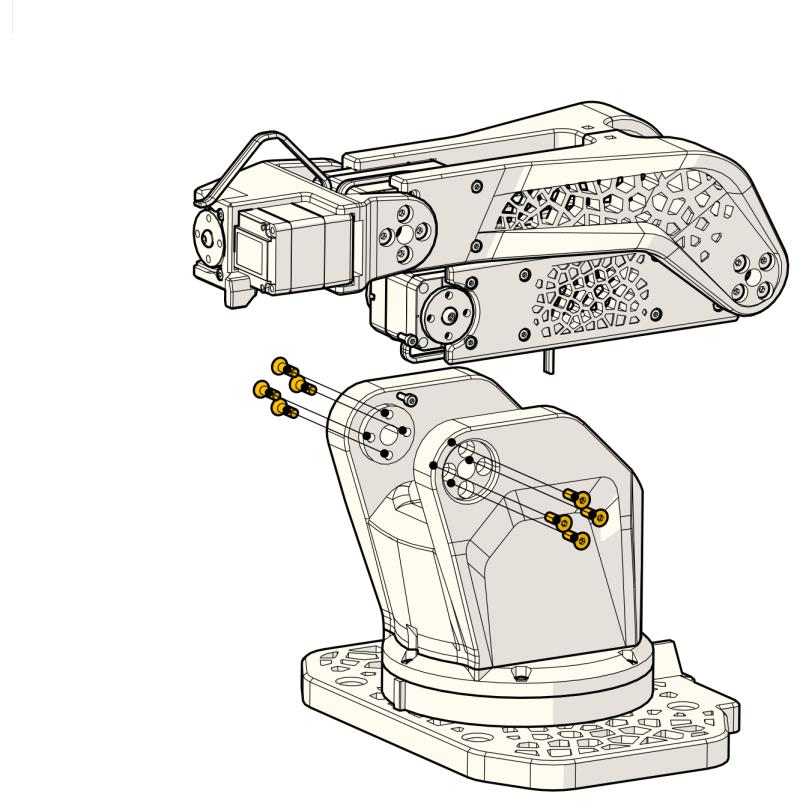
[picture p59: figure]

SO-ARM102 | 18 | R | O | B | O | N | I | N | E

## FOLLOWER & LEADER

## FOLLOWER & LEADER

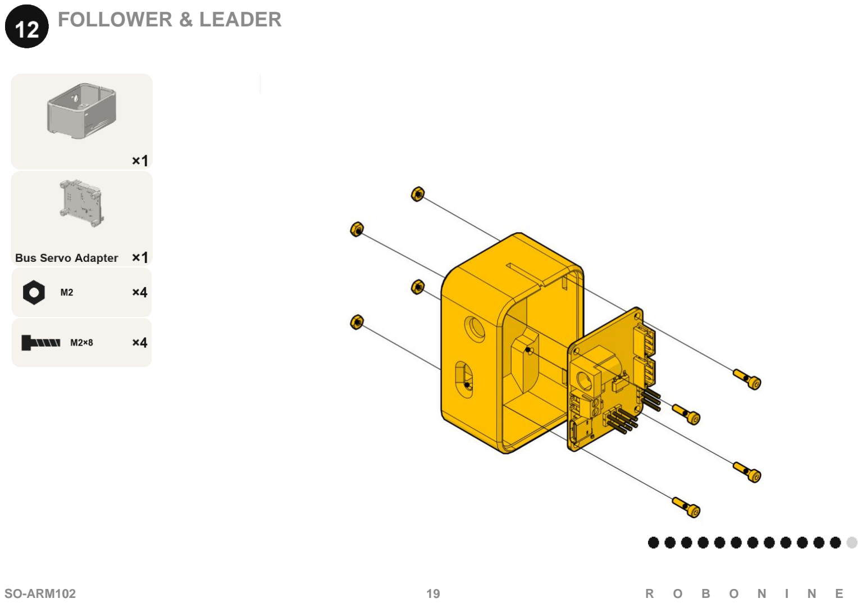
[picture p60: page 19]

SO-ARM102 | 19 | R | O | B | O | N | I | N | E

## FOLLOWER & LEADER

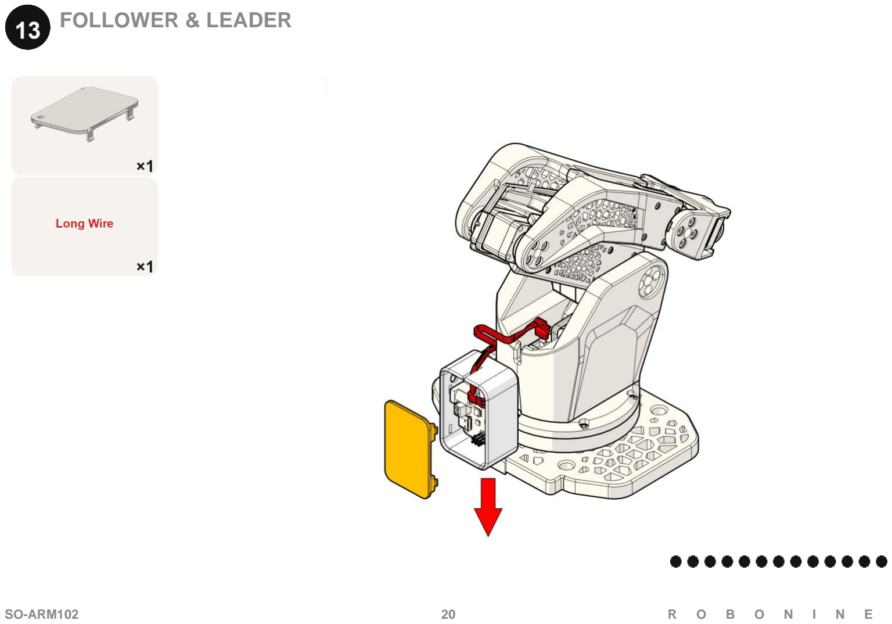
[picture p61: page 20]

SO-ARM102 | 20 | R | O | B | O | N | I | N | E

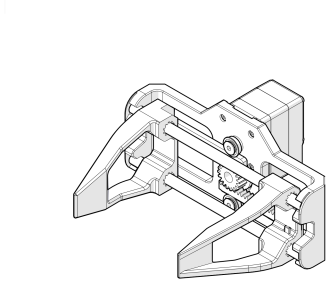
[picture p62: figure]
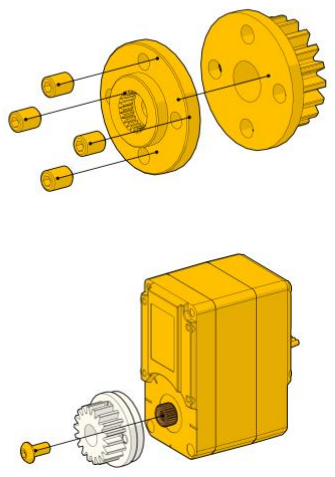
[picture p63: figure]
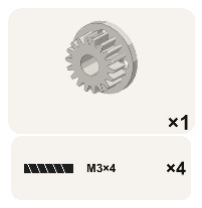
[picture p64: figure]
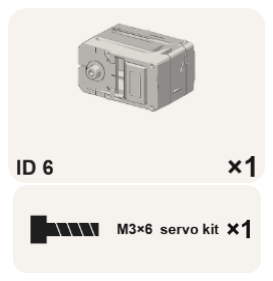
[picture p65: figure]

SO-ARM102 | 21 | R | O | B | O | N | I | N | E

# GRIPPER

# GRIPPER

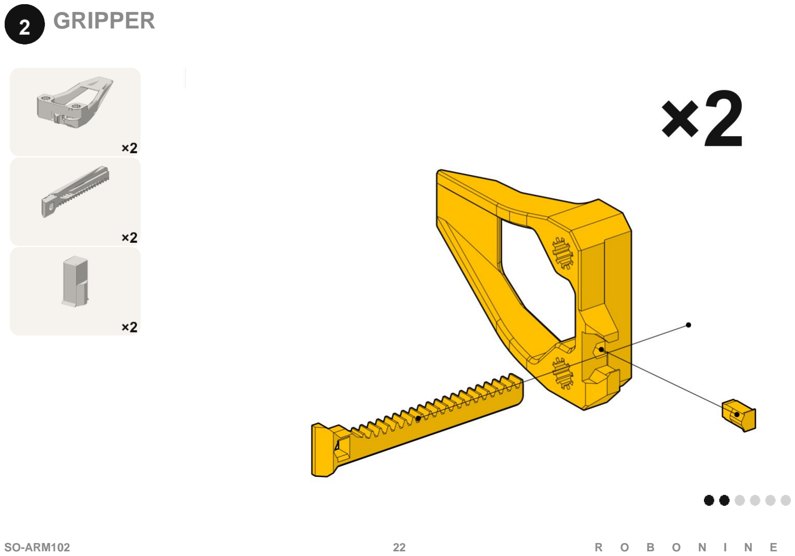
[picture p66: page 22]

SO-ARM102 | 22 | R | O | B | O | N | I | N | E

# GRIPPER

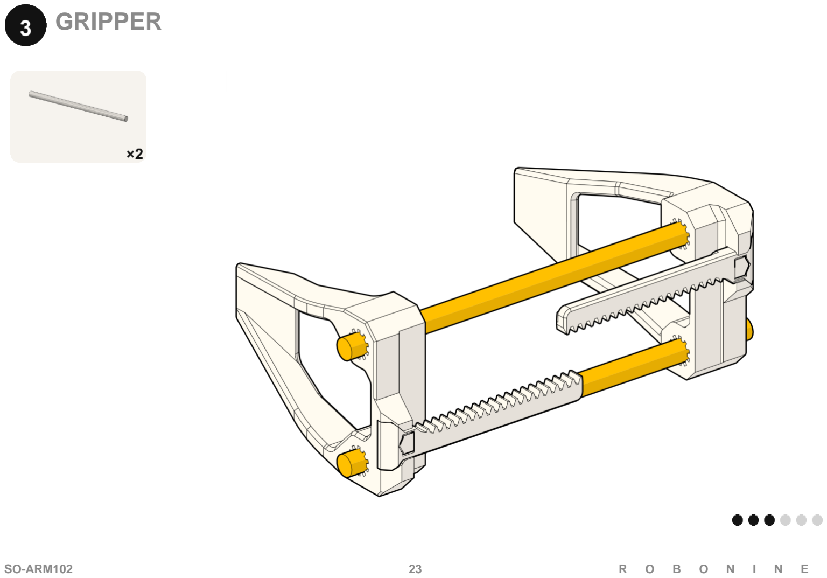
[picture p67: page 23]

SO-ARM102 | 23 | R | O | B | O | N | I | N | E

# GRIPPER

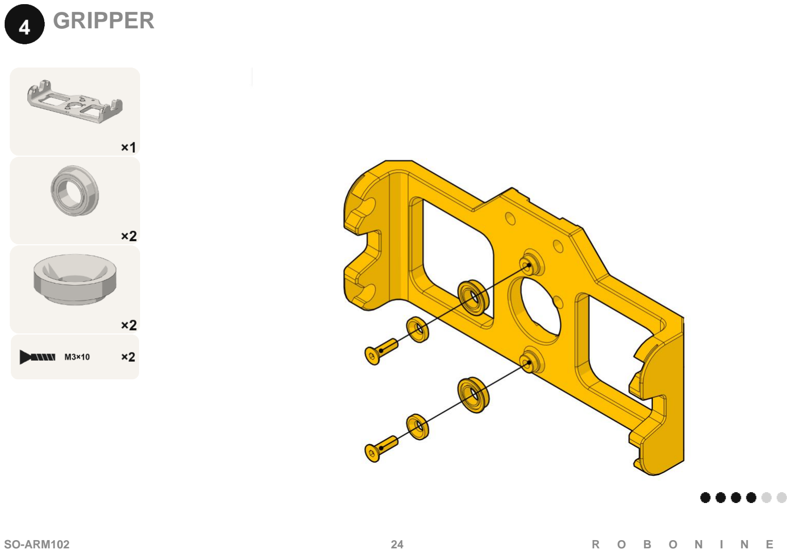
[picture p68: page 24]

SO-ARM102 | 24 | R | O | B | O | N | I | N | E

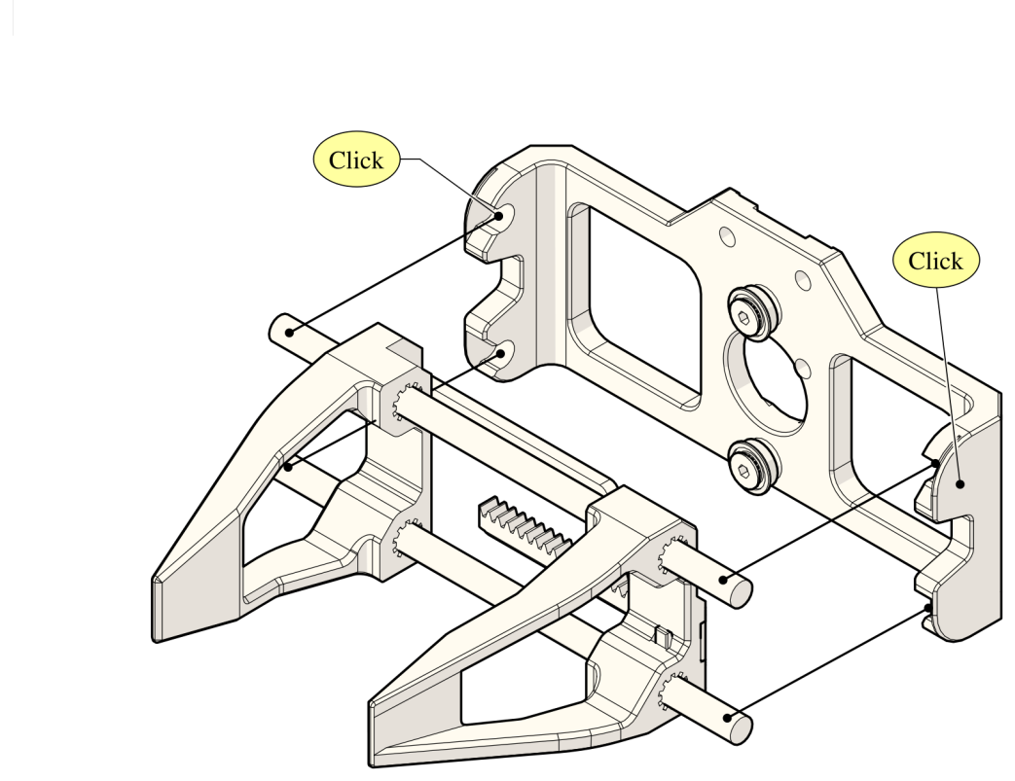
[picture p69: figure]

SO-ARM102 | 25 | R | O | B | O | N | I | N | E

# GRIPPER

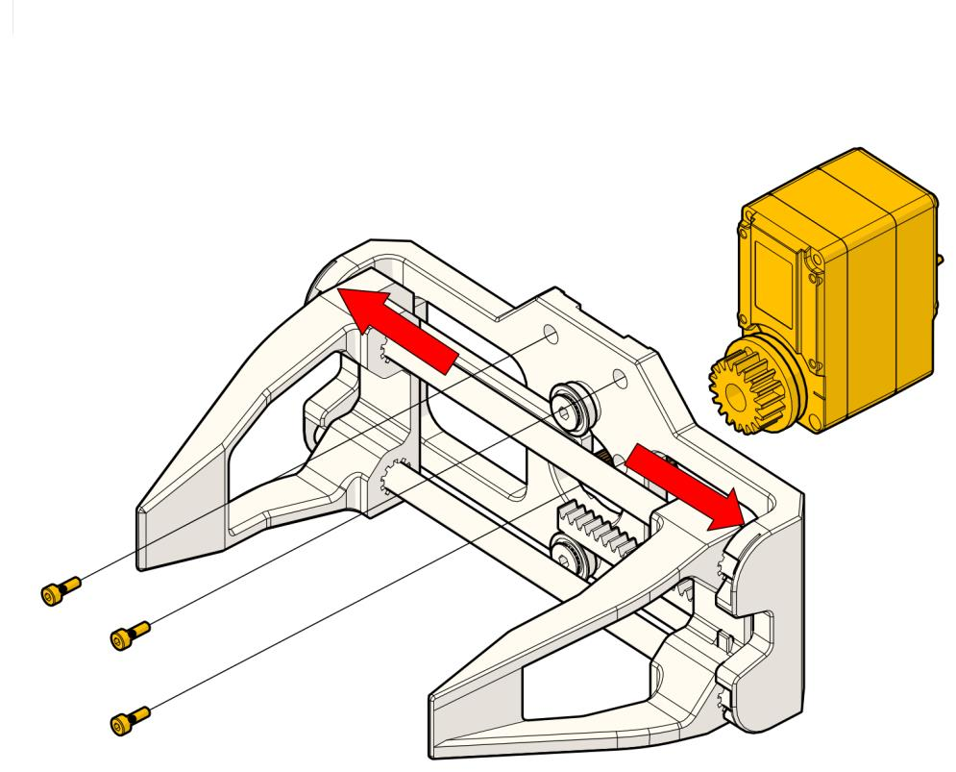
[picture p70: figure]

SO-ARM102 | 26 | R | O | B | O | N | I | N | E

# GRIPPER

# FOLLOWER

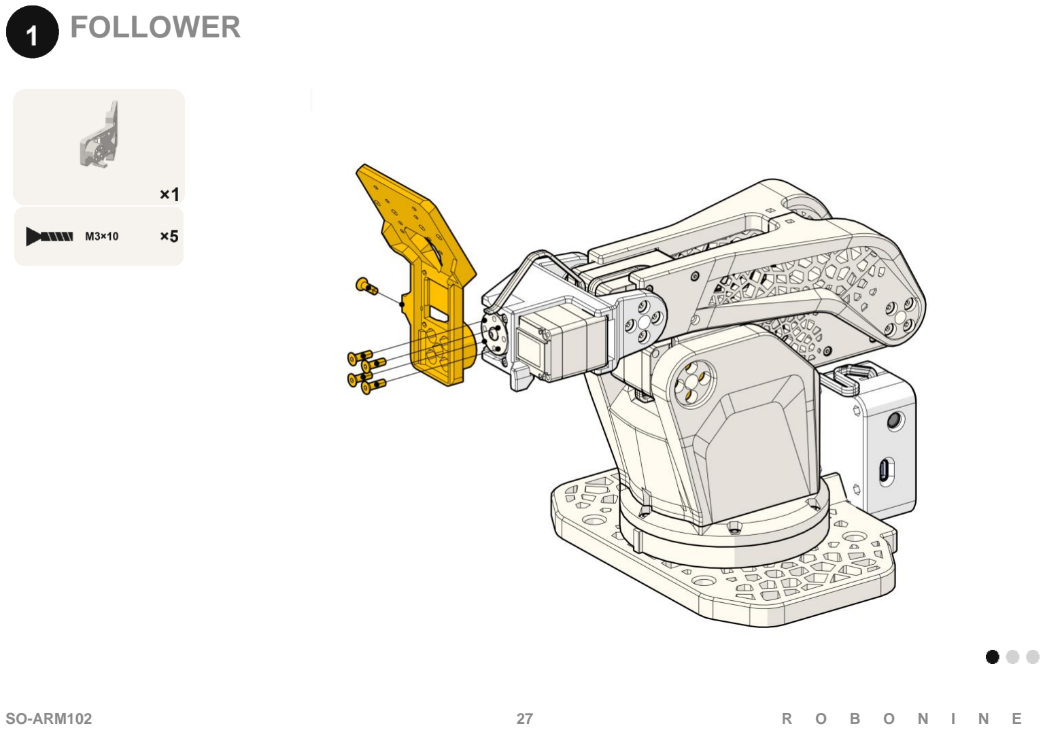
[picture p71: page 27]

SO-ARM102 | 27 | R | O | B | O | N | I | N | E

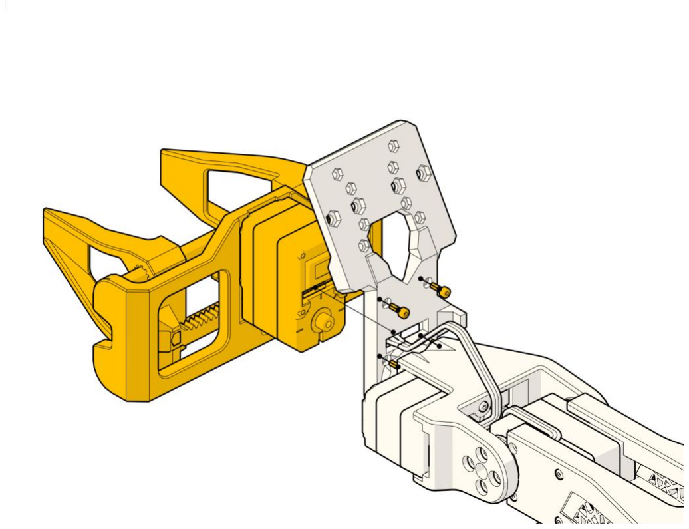
[picture p72: figure]

SO-ARM102 | 28 | R | O | B | O | N | I | N | E

# FOLLOWER

# FOLLOWER

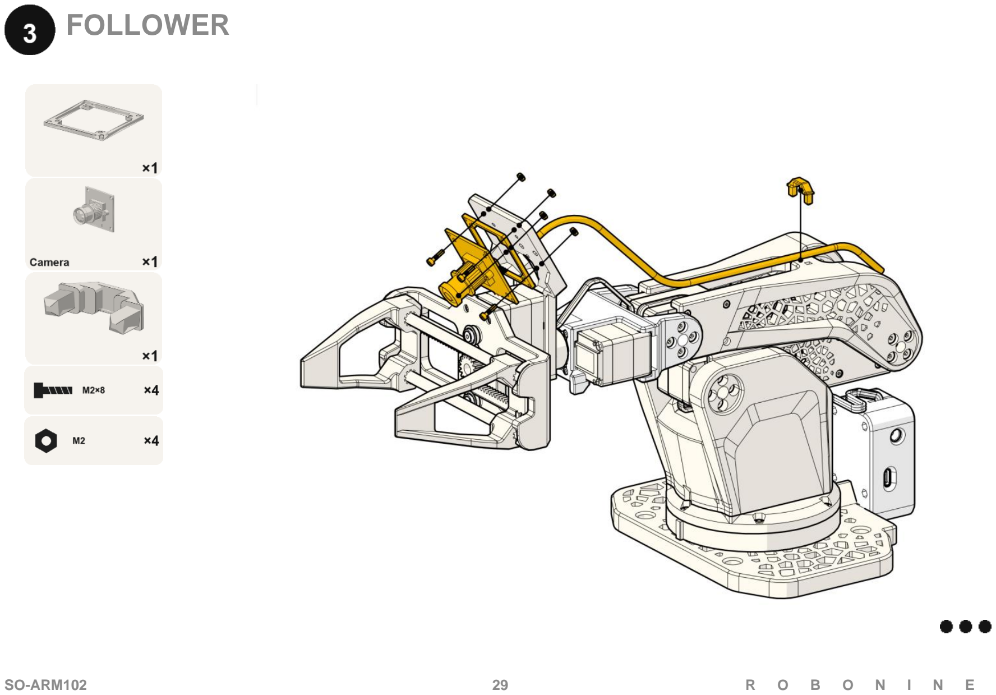
[picture p73: page 29]

SO-ARM102 | 29 | R | O | B | O | N | I | N | E

# LEADER

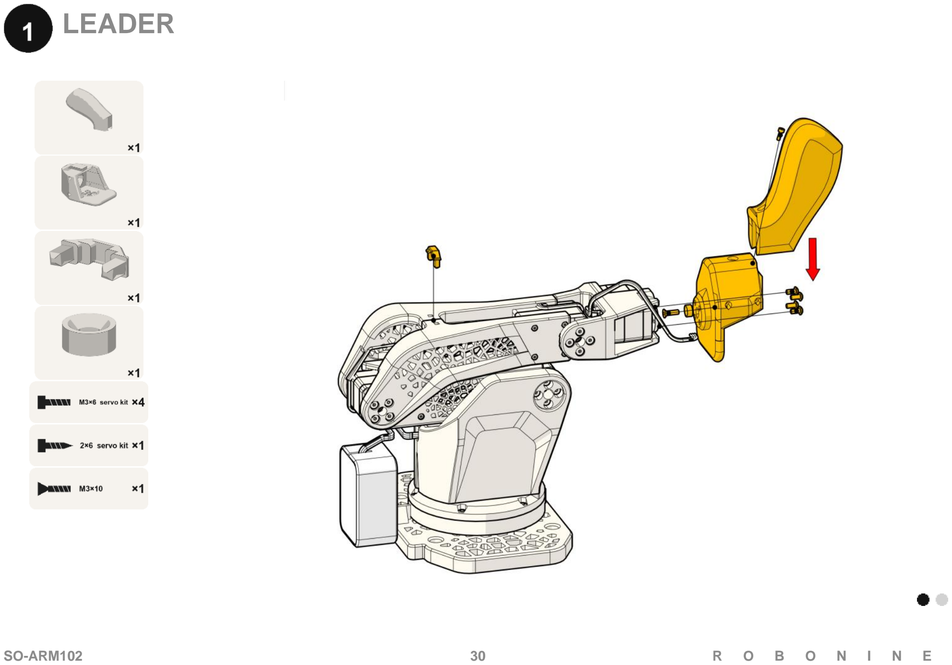
[picture p74: page 30]

SO-ARM102 | 30 | R | O | B | O | N | I | N | E

# LEADER

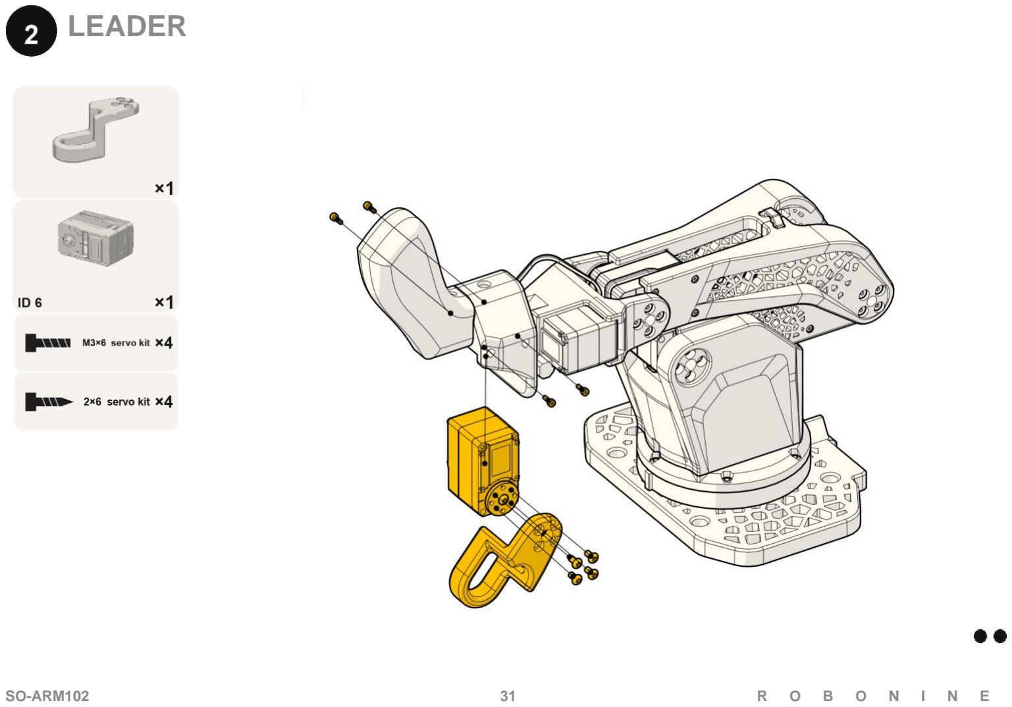
[picture p75: page 31]

SO-ARM102 | 31 | R | O | B | O | N | I | N | E

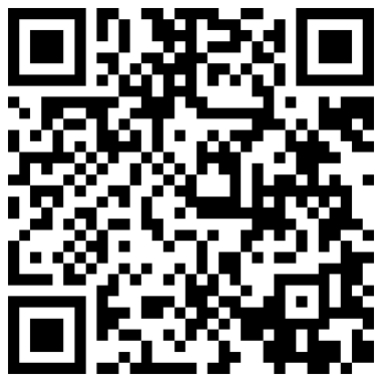
[picture p76: figure]

## LAB.ROBONINE.COM

## A S S E M B L Y C A L I B R A T I O N L E S S O N S

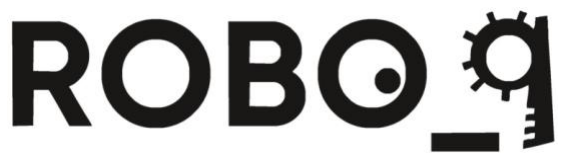
[picture p77: figure]

## robonine.com

## hello@robonine.com
