roboninecom/SO-ARM102/assets/images/3d print/follower_3dprint_layout.png

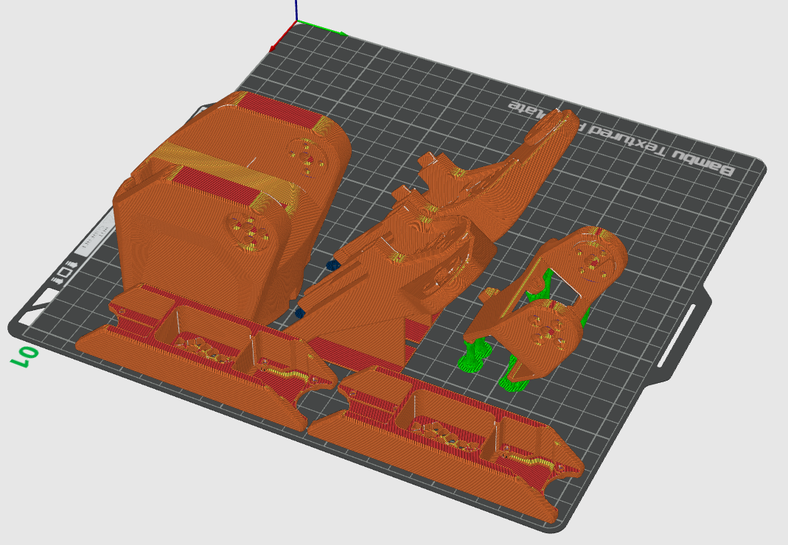
assets/images/3d print/follower_3dprint_layout.png
