roboninecom/SO-ARM102/assets/images/3d print/gripper_3dprint.png

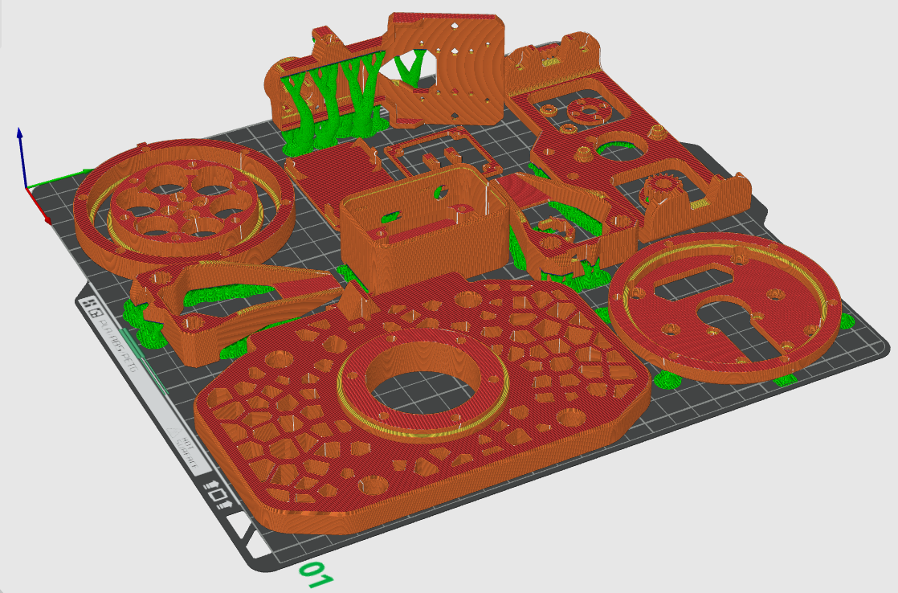
assets/images/3d print/gripper_3dprint.png
