roboninecom/SO-ARM102/simulation/urdf/so_arm_102.urdf

<?xml version='1.0' encoding='utf-8'?>
<robot name="so_arm_102_pre_for_urdf_v5">
  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
  <link name="base_link">
    <inertial>
      <origin xyz="-0.00753657459228 2.70964811146e-05 0.013641047398" rpy="0 0 0" />
      <mass value="0.178499229726" />
      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
    </inertial>
    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
  </link>
  <link name="link1_1">
    <inertial>
      <origin xyz="0.000323477926688 -9.49285422888e-06 0.0277445919724" rpy="0 0 0" />
      <mass value="0.201603775922" />
      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
    </inertial>
    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
  </link>
  <link name="link2_1">
    <inertial>
      <origin xyz="-9.08588393138e-05 0.0179996080154 0.0565027997369" rpy="0 0 0" />
      <mass value="0.180993297738" />
      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
    </inertial>
    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
  </link>
  <link name="link3_1">
    <inertial>
      <origin xyz="0.0899345844067 -0.0180532098499 0.030929698344" rpy="0 0 0" />
      <mass value="0.121036400289" />
      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
    </inertial>
    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
  </link>
  <link name="link4_1">
    <inertial>
      <origin xyz="0.0367612549493 -0.00682773158541 -9.36509085222e-05" rpy="0 0 0" />
      <mass value="0.0850684506718" />
      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
    </inertial>
    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
  </link>
  <link name="link5_1">
    <inertial>
      <origin xyz="0.0344926242899 -3.24353462452e-05 0.0128432467385" rpy="0 0 0" />
      <mass value="0.106616468137" />
      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
    </inertial>
    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
  </link>
  <link name="clamp1_1">
    <inertial>
      <origin xyz="0.0150861322583 -0.0085189835284 -0.0166385856799" rpy="0 0 0" />
      <mass value="0.00734953722517" />
      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
    </inertial>
    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
  </link>
  <link name="clamp2_1">
    <inertial>
      <origin xyz="0.0150861312617 0.00851898352954 -0.0153534196604" rpy="0 0 0" />
      <mass value="0.00734953759363" />
      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
    </inertial>
    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
  </link>
  <joint name="base_to_link1" type="revolute">
    <origin xyz="-0.006 -1.10978314851e-16 0.025" rpy="0 0 0" />
    <parent link="base_link" />
    <child link="link1_1" />
    <axis xyz="-3.48927236311e-15 -1.38855301773e-17 -1" />
    <limit effort="2.942" velocity="4.717" lower="-3.07177948351" upper="3.07177948351" />
  </joint>
  <joint name="link1_to_link2" type="revolute">
    <origin xyz="0.04 -0.018 0.073356707952" rpy="0 0 0" />
    <parent link="link1_1" />
    <child link="link2_1" />
    <axis xyz="3.7576779295e-14 -1 3.11848821907e-14" />
    <limit effort="4.903" velocity="7.874" lower="-2.32128790515" upper="1.58824961931" />
  </joint>
  <joint name="link2_to_link3" type="revolute">
    <origin xyz="3.39589458789e-05 0.035999879491 0.113000833762" rpy="0 0 0" />
    <parent link="link2_1" />
    <child link="link3_1" />
    <axis xyz="5.4643524895e-08 -1 3.71447673953e-08" />
    <limit effort="4.903" velocity="7.874" lower="-1.57079632679" upper="2.67035375555" />
  </joint>
  <joint name="link3_to_link4" type="revolute">
    <origin xyz="0.135059233654 -2.61233757511e-07 0.0336375809223" rpy="0 0 0" />
    <parent link="link3_1" />
    <child link="link4_1" />
    <axis xyz="-5.21611917629e-08 1 -3.41984371354e-08" />
    <limit effort="2.942" velocity="4.717" lower="-1.72787595947" upper="1.69296937443" />
  </joint>
  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
  <joint name="link4_to_link5" type="revolute">
    <origin xyz="0.0591945817497 -0.0180002669618 -4.03637807994e-05" rpy="0 0 0" />
    <parent link="link4_1" />
    <child link="link5_1" />
    <axis xyz="-1 -4.90398764451e-08 1.40482066922e-10" />
    <limit effort="1.629" velocity="7.808" lower="-2.87979326579" upper="2.84488668075" />
  </joint>
  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
  <joint name="clamp1" type="prismatic">
    <origin xyz="0.0639999993385 0.0165020797222 0.0159979235363" rpy="0 0 0" />
    <parent link="link5_1" />
    <child link="clamp1_1" />
    <axis xyz="-5.21612507542e-08 1 4.50838078172e-08" />
    <limit effort="226.2" velocity="0.0562" lower="0" upper="0.0415" />
  </joint>
  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
  <joint name="clamp2" type="prismatic">
    <origin xyz="0.0640000007627 -0.0154979202778 0.0159979219163" rpy="0 0 0" />
    <parent link="link5_1" />
    <child link="clamp2_1" />
    <axis xyz="-4.9039873492e-08 1 4.73420869362e-08" />
    <limit effort="226.2" velocity="0.0562" lower="-0.0415" upper="3.46944695195e-17" />
    <mimic joint="clamp1" multiplier="-1" offset="0" />
  </joint>
</robot>
