roboninecom/SO-ARM102/(commit log)

2026-10-31 added cable info
2026-11-01 cable links
2026-11-01 wrist roll & camera holder update
    [Gripper rods test plate D6.0-D6.2.STL, Gripper test plate star holes 6.0-6.3.STL, RB9.01.062.025 Clamp (D6.0).STEP, RB9.01.062.025 Clamp (D6.0).STL, RB9.01.062.025 Clamp (D6.2).STEP, RB9.01.062.025 Clamp (D6.2).STL, RB9.01.062.075 Camera holder.STEP, RB9.01.062.075 Camera holder.STL]
2026-11-01 rod test part
2026-11-02 rods test plate intro
2026-11-02 docs: correct M3 x 10 quantity in all BOM translations
2026-11-03 models: change orange figures to blue
    [colored_figures.3mf]
2026-11-03 docs: retain assembly booklet v0.7 filename and remove only v0.6
2026-11-04 Remove standalone logo 3MF files
    [logo_black_base.3mf, logo_white_base.3mf]
2026-11-07 Fix C049 1:191 follower specs and estimate simulation limits (#32)
    * docs: align follower wrist and gripper specifications with C049
    * fix: estimate C049 simulation limits from speed and gear ratios
    [so_arm_102.urdf, so_arm_102.xacro]
2026-11-07 fix: disable supports for follower upper arm in 3MF (#42)
    * fix: disable supports for follower upper arm in 3MF
    * fix: add painted skirt for upper arm
    [SO102.1.01_Follower_table_arm_links_PET-CF.3mf]
2026-11-07 fixed board cap broken ears
    [SO102.02.101-01 Board cap.STEP, SO102.02.101-01 Board cap.STL, SO102.3.01_Leader_table_PLA+.3mf]
2026-11-07 updated clamp, nail, gear rack models, 3mf tables
    [RB9.01.062.025 Clamp (D6.0).STEP, RB9.01.062.025 Clamp (D6.0).STL, RB9.01.062.025 Clamp (D6.1).STEP, RB9.01.062.025 Clamp (D6.1).STL, RB9.01.062.025 Clamp (D6.2).STEP, RB9.01.062.025 Clamp (D6.2).STL, RB9.01.062.030 Gear rack.STEP, RB9.01.062.030 Gear rack.stl]
2026-11-09 Update the assembly guide to booklet v0.8.
    Cable clips move to the camera and leader handle, the camera holder takes five M3x10 screws, and the controller case uses the current board holder names.
2026-11-10 docs: refresh live star history chart for current repository (#47)
2026-11-10 docs: sync assembly booklet v0.8 across translations
