roboninecom/SO-ARM102/(notices)

Notices in the files:
README.md:
Hardware: CERN-OHL-P-2.0
Docs: CC BY 4.0
docs/i18n/hi/README.md:
हार्डवेयर: CERN-OHL-P-2.0
डॉक्यूमेंट्स: CC BY 4.0
docs/i18n/ja/README.md:
ハードウェア: CERN-OHL-P-2.0
ドキュメント: CC BY 4.0
docs/i18n/ru/README.md:
Аппаратные модели: CERN-OHL-P-2.0
Документация: CC BY 4.0
docs/i18n/zh-CN/README.md:
硬件：CERN-OHL-P-2.0
文件：CC BY 4.0
